meltoner/agrofelis/introduction/_figures/unselected/01_agrofelis-robot-schematics.png

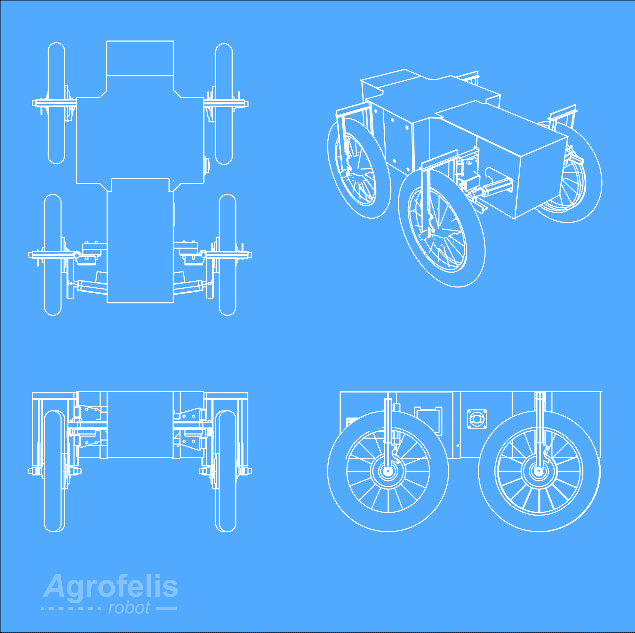
introduction/_figures/unselected/01_agrofelis-robot-schematics.png
