meltoner/agrofelis/introduction/_figures/unselected/02_.jpg

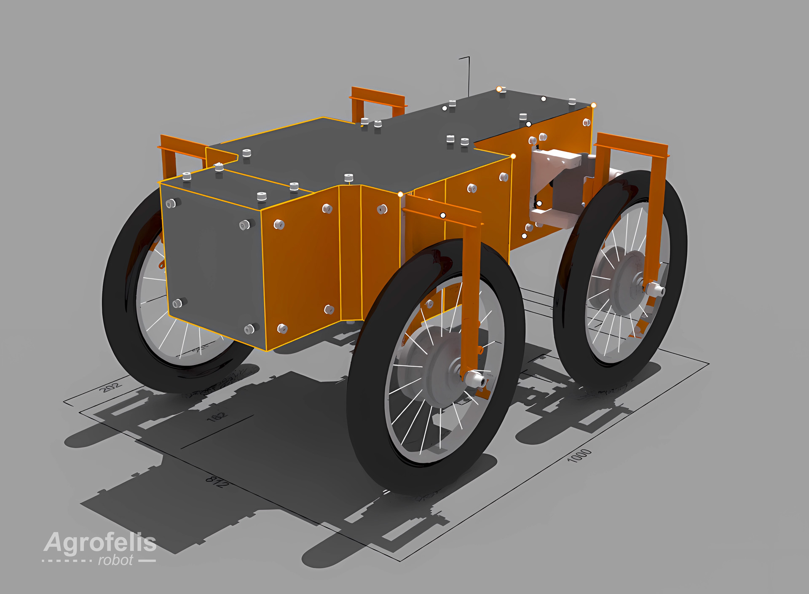
introduction/_figures/unselected/02_.jpg
