meltoner/agrofelis/introduction/_figures/unselected/02_agrofelis-robot-render.jpg

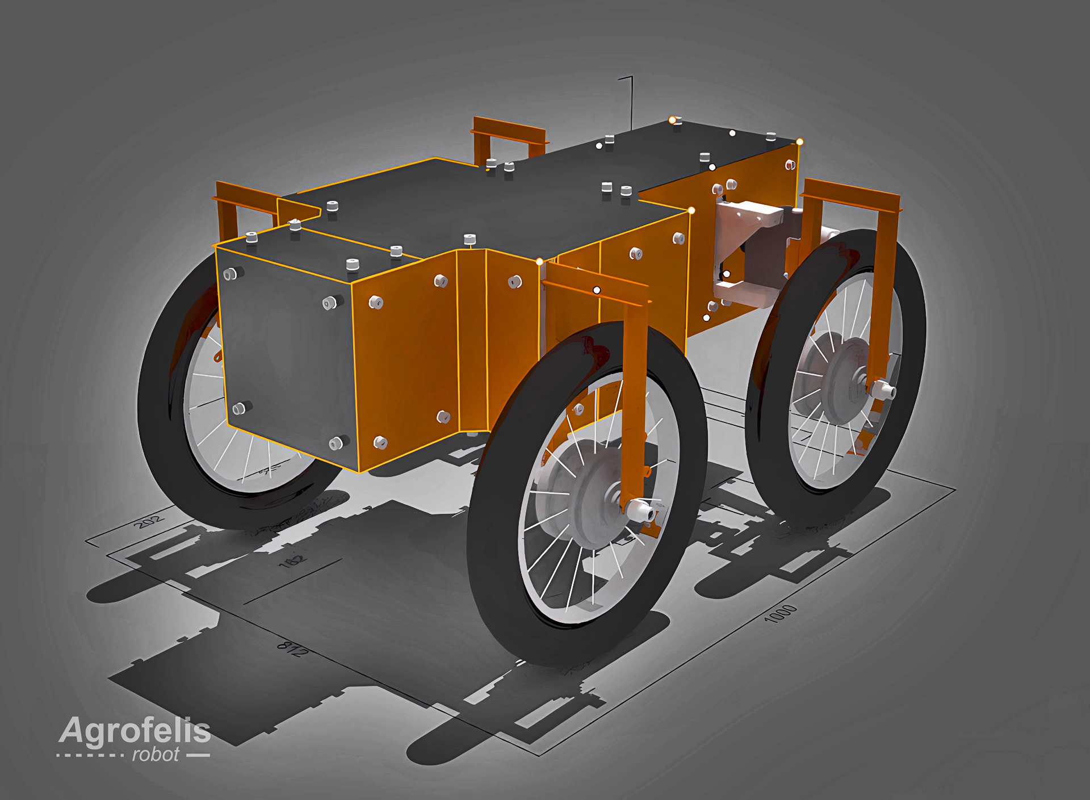
introduction/_figures/unselected/02_agrofelis-robot-render.jpg
