meltoner/agrofelis/introduction/_figures/unselected/03.png

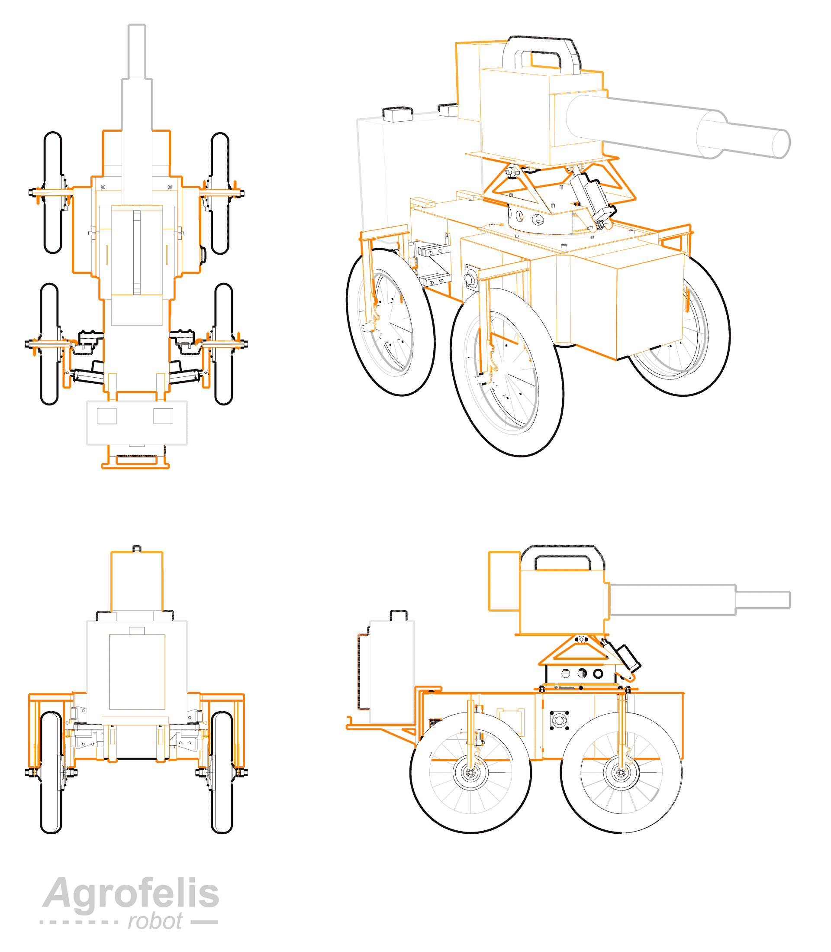
introduction/_figures/unselected/03.png
