meltoner/agrofelis/introduction/_figures/unselected/03_agrofelis-robot-implement-mount-schematic.png

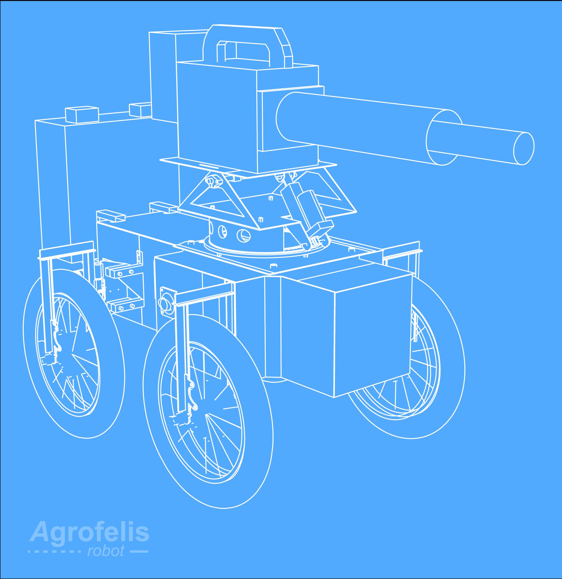
introduction/_figures/unselected/03_agrofelis-robot-implement-mount-schematic.png
