meltoner/agrofelis/introduction/_figures/unselected/+3dView_plansc.png

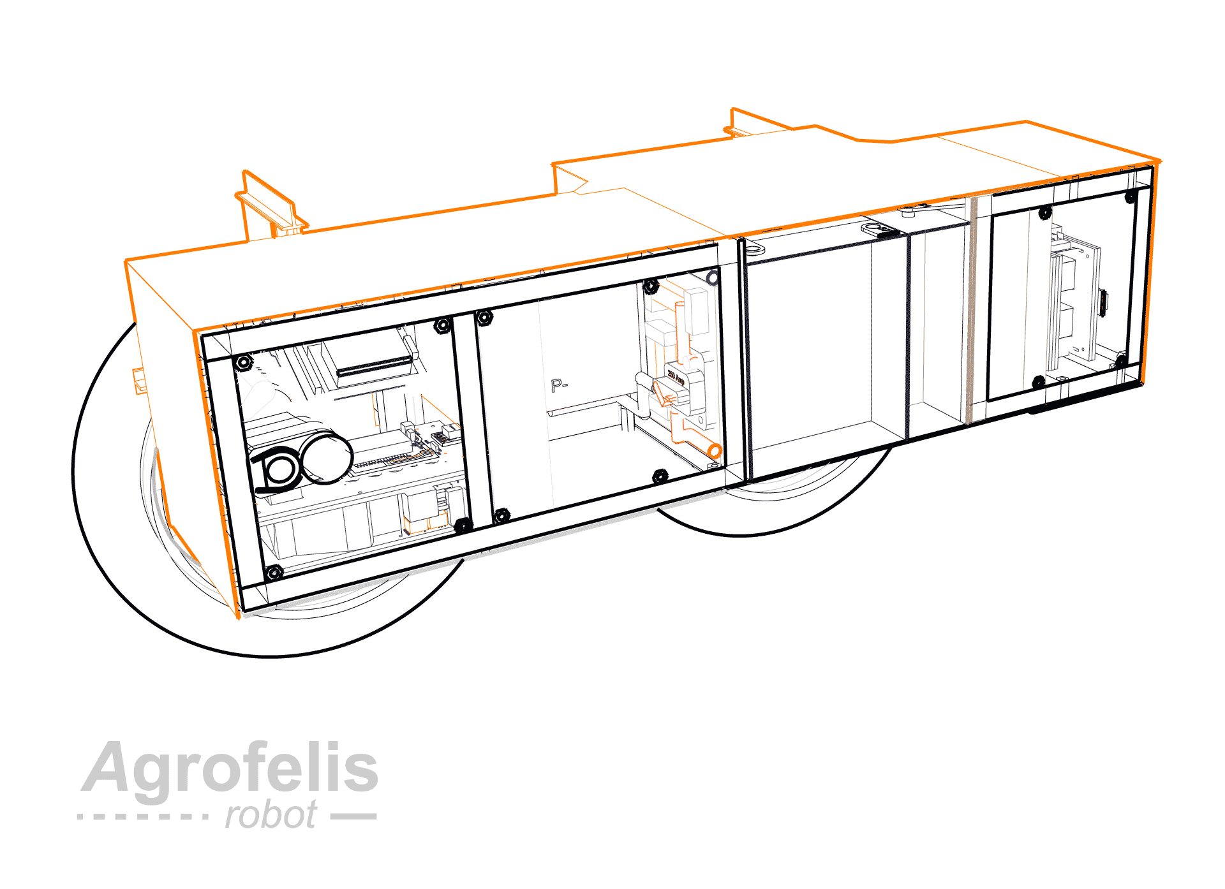
introduction/_figures/unselected/+3dView_plansc.png
