meltoner/agrofelis/components/mobility/motors_hub_driver/pcb/PCB.CNC.controller/readme.md

The folder contains SVG files that define the wholes and paths of the PCB. 
Moreover, the folder contains the actionable NC derivatives, generated by 
the respective JavaScript applications.

SVG 
- [1.DRILL.svg](https://github.com/meltoner/agrofelis/blob/main/components/mobility/motors_hub_driver/pcb/PCB.CNC.controller/1.DRILL.svg)
- [2.CURVE.svg](https://github.com/meltoner/agrofelis/blob/main/components/mobility/motors_hub_driver/pcb/PCB.CNC.controller/2.CURVE.svg)

NC
- [1.DRILL.ENHANCED.nc](https://github.com/meltoner/agrofelis/blob/main/components/mobility/motors_hub_driver/pcb/PCB.CNC.controller/1.DRILL.ENHANCED.nc)
- [2.CURVE.ENHANCED.nc](https://github.com/meltoner/agrofelis/blob/main/components/mobility/motors_hub_driver/pcb/PCB.CNC.controller/2.CURVE.ENHANCED.nc)

JavaScript
- [LineRoutesToHoles.html](https://github.com/meltoner/agrofelis/blob/main/components/mobility/motors_hub_driver/pcb/PCB.CNC.controller/LineRoutesToHoles.html)
- [LineRoutesToWire.html](https://github.com/meltoner/agrofelis/blob/main/components/mobility/motors_hub_driver/pcb/PCB.CNC.controller/LineRoutesToWire.html)

The transformation procedure follows :

A. FROM SVG EXPORT IN RHINO A4 1:1
OPEN IN ILLUSTRATOR AND SCALE X * 1.887640
MOVE OBJECT TO LEFT DOWN CORNER
SAVE

B. OPEN IN LASERGRBL AND SAVE AS CNC BOTH FILES

C. EDIT THE CNC CODE AND PROCESS IT VIA THE 

[LineRoutesToHoles.html](https://github.com/meltoner/agrofelis/blob/main/components/mobility/motors_hub_driver/pcb/PCB.CNC.controller/LineRoutesToHoles.html) THE DRILLING AND THE
[LineRoutesToWire.html](https://github.com/meltoner/agrofelis/blob/main/components/mobility/motors_hub_driver/pcb/PCB.CNC.controller/LineRoutesToWire.html) THE WIRING CNC CODE

USE A DRILL BIT IN THE FOR THE DRILLING
USE A PCB NOSE BIT FOR THE WIRING

[DRILL.svg](https://github.com/meltoner/agrofelis/blob/main/components/mobility/motors_hub_driver/pcb/PCB.CNC.controller/1.DRILL.svg) IS THE DRILLING PART
[CURVE.svg](https://github.com/meltoner/agrofelis/blob/main/components/mobility/motors_hub_driver/pcb/PCB.CNC.controller/2.CURVE.svg) IS THE WIRING PART

---------------------
189.26611224
