meltoner/agrofelis/components/mobility/motors_hub_driver/pcb/PCB.CNC.power/readme.md

The folder contains SVG files that define the wholes and paths of the PCB. 
Moreover, the folder contains the actionable NC derivatives, generated by 
the respective JavaScript applications.

SVG 
- [1.DRILL.svg](https://github.com/meltoner/agrofelis/blob/main/components/mobility/motors_hub_driver/pcb/PCB.CNC.power/1.drill.svg)
- [2.CURVE.svg](https://github.com/meltoner/agrofelis/blob/main/components/mobility/motors_hub_driver/pcb/PCB.CNC.power/2.curve.svg)

NC
- [1.drill.normalised.nc](https://github.com/meltoner/agrofelis/blob/main/components/mobility/motors_hub_driver/pcb/PCB.CNC.power/1.drill.normalised.nc)
- [1.drill.normalised.enhanced.nc](https://github.com/meltoner/agrofelis/blob/main/components/mobility/motors_hub_driver/pcb/PCB.CNC.power/1.drill.normalised.enhanced.nc)
- [2.curve.normalised.nc](https://github.com/meltoner/agrofelis/blob/main/components/mobility/motors_hub_driver/pcb/PCB.CNC.power/2.curve.normalised.nc)
- [2.curve.normalised.enhanced.nc](https://github.com/meltoner/agrofelis/blob/main/components/mobility/motors_hub_driver/pcb/PCB.CNC.power/2.curve.normalised.enhanced.nc)

JavaScript
- [LineRoutesToHoles.html](https://github.com/meltoner/agrofelis/blob/main/components/mobility/motors_hub_driver/pcb/PCB.CNC.power/LineRoutesToHoles.html)
- [LineRoutesToWire.html](https://github.com/meltoner/agrofelis/blob/main/components/mobility/motors_hub_driver/pcb/PCB.CNC.power/LineRoutesToWire.html)

A. FROM SVG EXPORT IN RHINO A4 1:1
OPEN IN ILLUSTRATOR AND SCALE X * 1.887640
MOVE OBJECT TO LEFT DOWN CORNER
SAVE

B. OPEN IN LASERGRBL AND SAVE AS CNC BOTH FILES

C. EDIT THE CNC CODE AND PROCESS IT VIA THE 

[LineRoutesToHoles.html](https://github.com/meltoner/agrofelis/blob/main/components/mobility/motors_hub_driver/pcb/PCB.CNC.power/LineRoutesToHoles.html) THE DRILLING AND THE
[LineRoutesToWire.html](https://github.com/meltoner/agrofelis/blob/main/components/mobility/motors_hub_driver/pcb/PCB.CNC.power/LineRoutesToWire.html) THE WIRING CNC CODE

USE A DRILL BIT IN THE FOR THE DRILLING
USE A PCB NOSE BIT FOR THE WIRING

[DRILL.svg](https://github.com/meltoner/agrofelis/blob/main/components/mobility/motors_hub_driver/pcb/PCB.CNC.power/1.drill.svg) IS THE DRILLING PART
[CURVE.svg](https://github.com/meltoner/agrofelis/blob/main/components/mobility/motors_hub_driver/pcb/PCB.CNC.power/2.curve.svg) IS THE WIRING PART

---------------------
