meltoner/agrofelis/components/mobility/motors_hub_driver/pcb/PCB.CNC.adac/readme.md

A. FROM SVG EXPORT IN RHINO A4 1:1
OPEN IN ILLUSTRATOR AND SCALE X * 1.887640
MOVE OBJECT TO LEFT DOWN CORNER
SAVE

B. OPEN IN LASERGRBL AND SAVE AS CNC BOTH FILES

C. EDIT THE CNC CODE AND PROCESS IT VIA THE 

LineRoutesToHoles.html THE DRILLING AND THE
LineRoutesToWire.html THE WIRING CNC CODE

USE A DRILL BIT IN THE FOR THE DRILLING
USE A PCB NOSE BIT FOR THE WIRING

DRIL.svg IS THE DRILLING PART
CURVE.svg IS THE WIRING PART

---------------------
152.2306
