meltoner/agrofelis/components/vehicle-steering/driver-board/laser-cut-nc/notes.txt

180 ms
60%
two passes

WARNING DRIVER +5V SHOULD NOT BE CONNECTED
AS IT LINKS TO THE HIGH VOLTAGE.
