meltoner/agrofelis/components/vehicle-steering/driver-board/STEERING_DRIVER_CABLES_LABELS.pdf

MB P
-5V
+5V
MB
MB
MB C

MA P

MOTOR A
potentiometer

-5V
+5V
MA
MA
MA C

# STEERING DRIVER CABLE LABELS

# DUAL DC MOTOR DRIVER WITH CURRENT SERNSOR AND FEEDBACK

# MOTOR B

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
MOTOR A

30 V | 30 V | 30 V | 30 V

J.NANO 5V

J.NANO USB | WIFI | USB | MEGA USB

MEGA USB

BMS USB

USB HUB 5V | 5 V

MOTOR B

MOTOR B
potentiometer

# MOTOR A
