meltoner/agrofelis/components/mobility/motors_hub_driver/src/web-app/snapshot.png

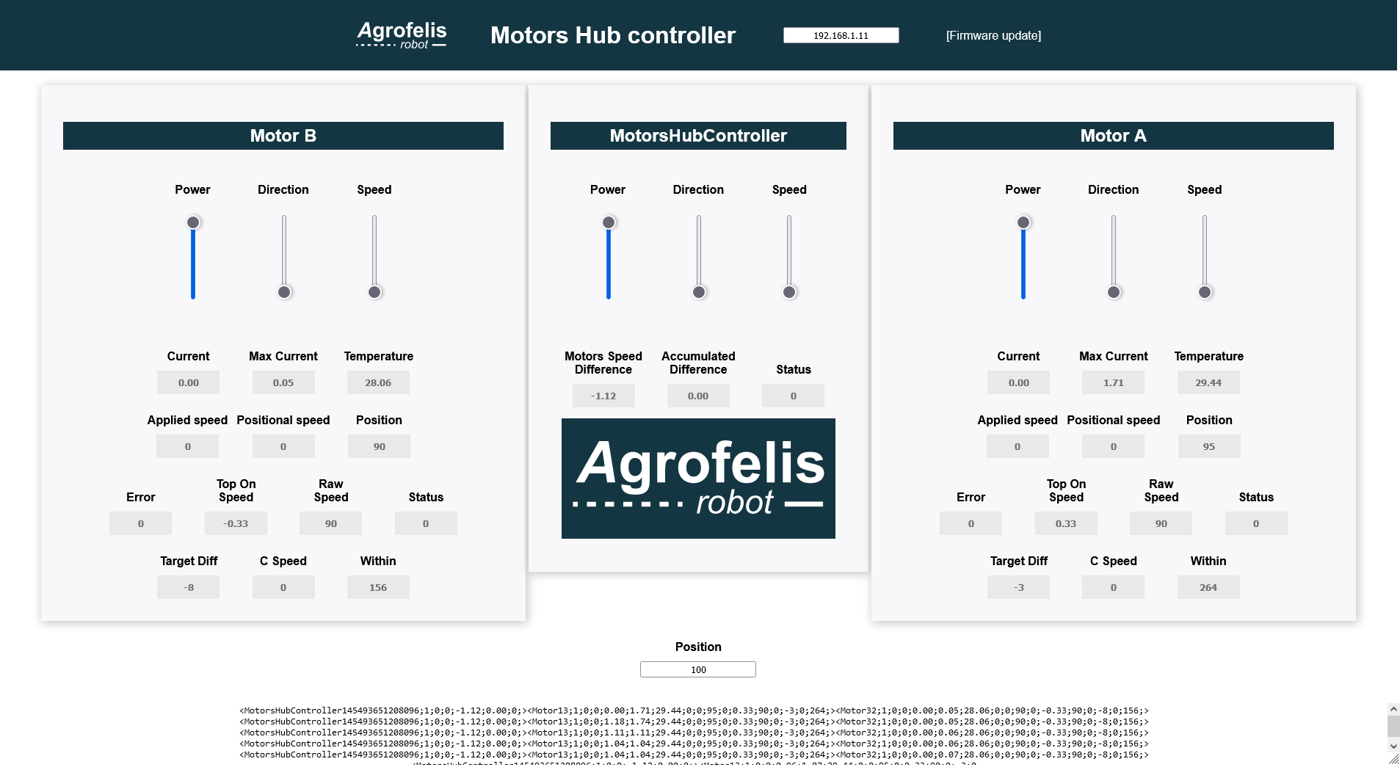
components/mobility/motors_hub_driver/src/web-app/snapshot.png
