meltoner/agrofelis/components/vehicle-steering/driver-board/model/LINEAR MODULE_embedded_files/drivercurrent.png

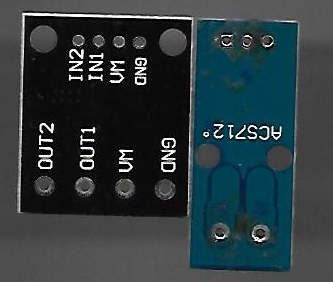
components/vehicle-steering/driver-board/model/LINEAR MODULE_embedded_files/drivercurrent.png
