meltoner/agrofelis/components/connectivity/assets/3d-print/JetsonElectronicsBase/export_electronics_base.stl

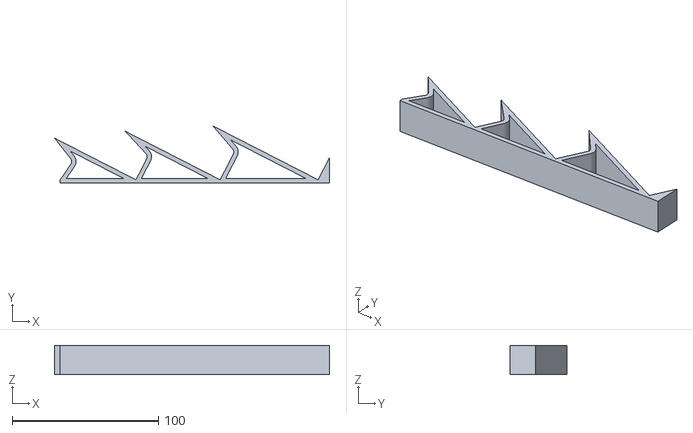
[picture p175: CAD file, 2023-09-10]
components/connectivity/assets/3d-print/JetsonElectronicsBase/export_electronics_base.stl
188.2 x 39.2 x 20.0
