meltoner/agrofelis/components/connectivity/assets/3d-print/usbHolder/usb_holder.stl

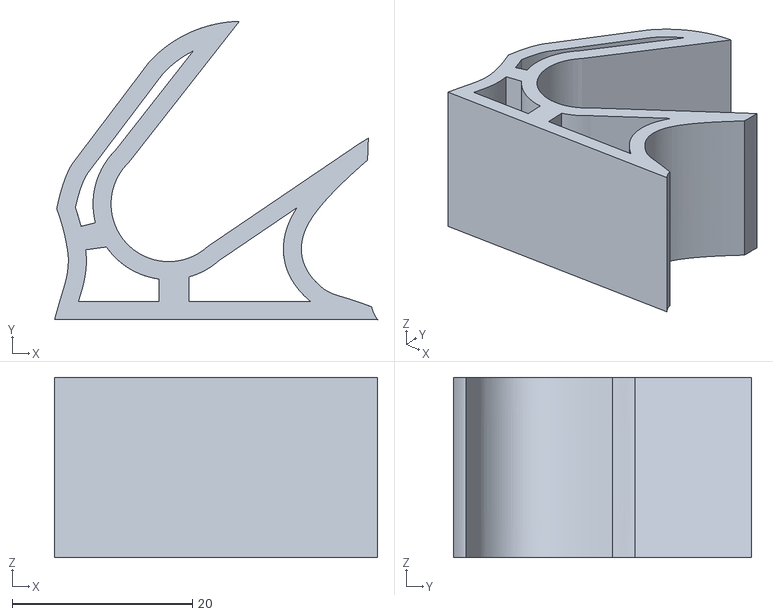
[picture p176: CAD file, 2023-09-10]
components/connectivity/assets/3d-print/usbHolder/usb_holder.stl
35.8 x 33.1 x 20.0
