meltoner/agrofelis/components/mobility/motors_hub_driver/structural/box_fins/3d_print/motorsDriverFinsInner.stl

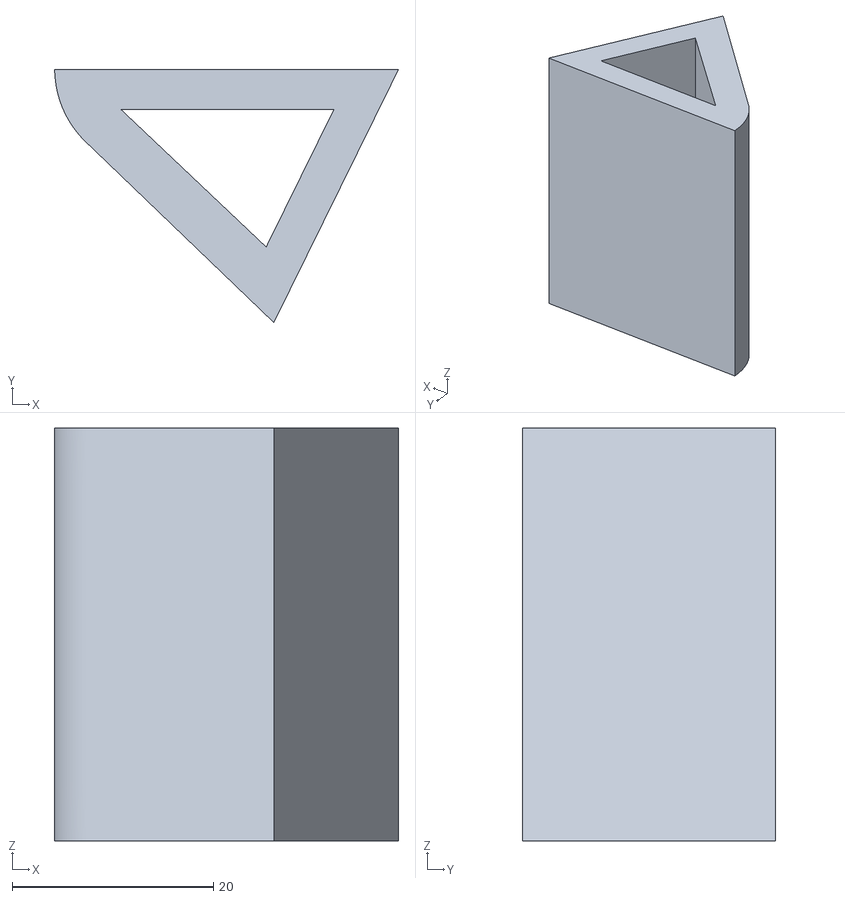
[picture p177: CAD file, 2023-07-12]
components/mobility/motors_hub_driver/structural/box_fins/3d_print/motorsDriverFinsInner.stl
34.2 x 25.1 x 41.0
