meltoner/agrofelis/components/vehicle-steering/assets/3d-print-feedback-potensiometer-covers/potensiometerCoversL.stl

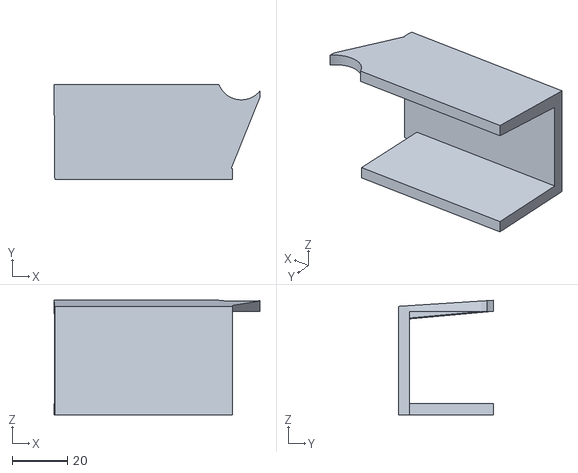
[picture p178: CAD file, 2023-08-30]
components/vehicle-steering/assets/3d-print-feedback-potensiometer-covers/potensiometerCoversL.stl
74.3 x 34.2 x 41.3
