meltoner/agrofelis/components/mobility/motors_hub_driver/structural/box_fins/3d_print/motorsDriverFinsOuter.stl

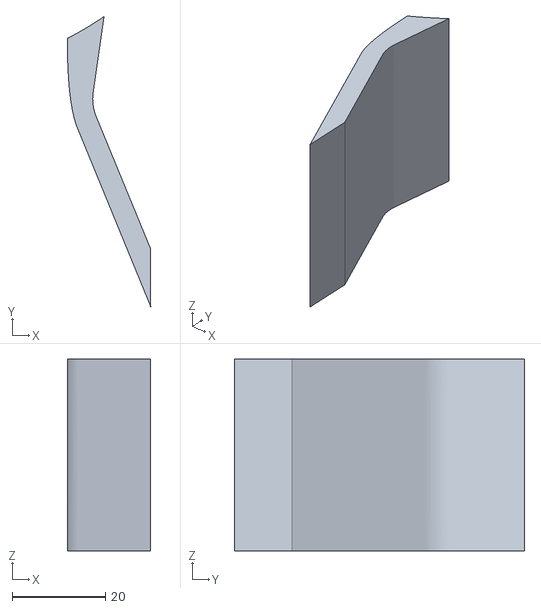
[picture p179: CAD file, 2023-07-12]
components/mobility/motors_hub_driver/structural/box_fins/3d_print/motorsDriverFinsOuter.stl
17.8 x 62.0 x 41.0
