meltoner/agrofelis/(list of files, cad)

Other CAD files:
components/implement-2-degrees-rotating-mount/assets/stainless-steel-laser-cut/laser-cut_stainless_gear_disk_motor_gear_order.dwg
components/vehicle-steering/assets/3d-print-feedback-potensiometer-covers/potensiometerCoversR.stl
components/vehicle-steering/driver-board/model/LINEAR MODULE_4.3dm
components/vehicle-wheels/assets/36holes-16-inch-pattern.3dm
