meltoner/agrofelis/components/mobility/motors_hub_driver/pcb/PCB.PRINT.Stickers/readme.md

The folder includes the printed top cover of the PCB boards, namely the:

- [motors_hub_driver-sticker-pcb-power_driver.pdf](https://github.com/meltoner/agrofelis/blob/main/components/mobility/motors_hub_driver/pcb/PCB.PRINT.Stickers/motors_hub_driver-sticker-pcb-power_driver.pdf)
- [motors_hub_driver-sticker-pcb-controller.pdf](https://github.com/meltoner/agrofelis/blob/main/components/mobility/motors_hub_driver/pcb/PCB.PRINT.Stickers/motors_hub_driver-sticker-pcb-controller.pdf)
- [motors_hub_driver-sticker-pcb-adac.pdf](https://github.com/meltoner/agrofelis/blob/main/components/mobility/motors_hub_driver/pcb/PCB.PRINT.Stickers/motors_hub_driver-sticker-pcb-adac.pdf)
