meltoner/agrofelis/book/03agrofelisrobotwheelsforksdesignandfabrication.pdf

# Agrofelis Robot Wheels Forks Design and Fabrication

### Documentation

### Agrofelis

### Document created on 2023-10-09 03:57:09

Abstract

This document presents an overview of the fabrication process for the forks mounting the four wheels of the Agrofelis vehicle. These forks are intentionally designed to be detachable, so that the wheels could be removed or replaced with alternative ones. The forks are responsible for securing the active wheels of the vehicle, establishing active brakes actuated via servos, enabling steering and installing feedback rotating mechanisms. Two types of forks are being employed, those installed in the front and those installed in the back. The majority of fork designs are similar, with the only differentiating factor being the mounting mechanism aimed for fixed or steering purposes. The forks installed on the left and right sides are arranged in a mirrored fashion. The forks are constructed from regular iron T-shaped rods that have been cut and welded. Additional sub-components elaborated are the vehicle’s fork mounting mechanisms and the parrot-like (drop out) elements securing the wheels via the motor’s hub shaft. The design schematics, plasma cut patterns, as well as images of the fabrication progression are all documented. The document concludes by providing a list of indicative suppliers from whom the raw materials were acquired, further enriched with bill and material details.

## Contents

Introduction | 1
Forks Arrangement | 1
Front Forks | 3
Back Forks | 7
Forks Components and Indicative Suppliers | 15
Summary | 16

Agrofelis
Agrofelis Robot Wheels Forks Design and Fabrication

## Introduction

In order to minimize the footprint of the vehicle, to have a sturdier front structure where mechanisms could be mounted, to reduce the fabrication complexity and to cut manufacturing costs, the front wheels were designed with a fixed function in mind, while the back wheels were designed with a dynamic function implementing the steering of the vehicle. The forks utilized existing profile characteristics found in the bicycle industry and more specifically for the fork drop out and brake mounting points, so disk brakes could be employed. Fabrication of the forks and their mounting mechanisms involves regular 25 mm T-shaped rods, along with two plasma-cut components that are cut, drilled and MIG welded. All forks were designed so they are detachable in order to support future revisions or variations of the forks.

In the following sections, the Agrofelis forks are being decomposed into their sub-elements, showcasing their fabrication details.

## Forks Arrangement

The following schematic illustrates the four wheel forks of the vehicle.

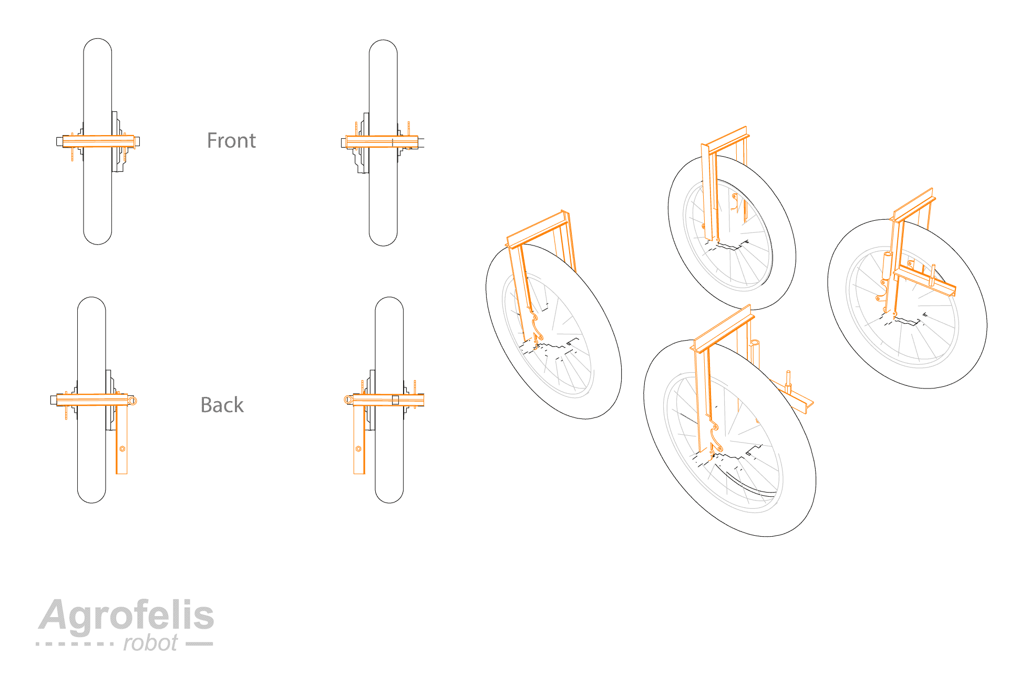
[picture p206: figure]

Figure 1: Forks and wheels

The following figure depicts the forks mirrored arrangement.

Forks Arrangement | Page | 1 of 17

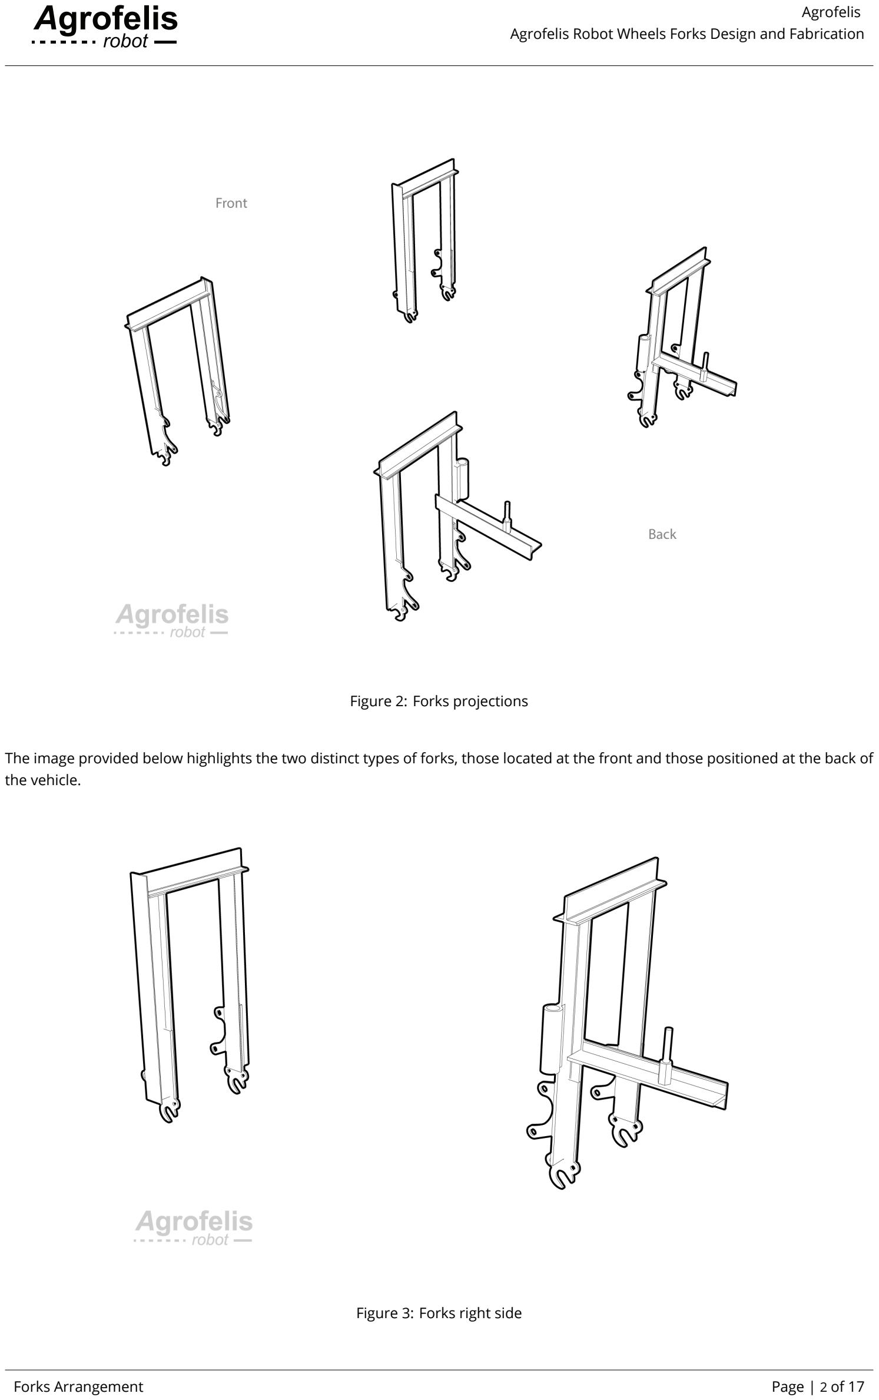
[picture p207: page 3]

Figure 2: Forks projections

The image provided below highlights the two distinct types of forks, those located at the front and those positioned at the back of the vehicle.

Figure 3: Forks right side

Forks Arrangement | Page | 2 of 17

## Front Forks

All fours forks share a common structure, differentiating only at the final fabrication stage based on their intended usage. The diagram below encodes the profile characteristics and dimensions of a front fork.

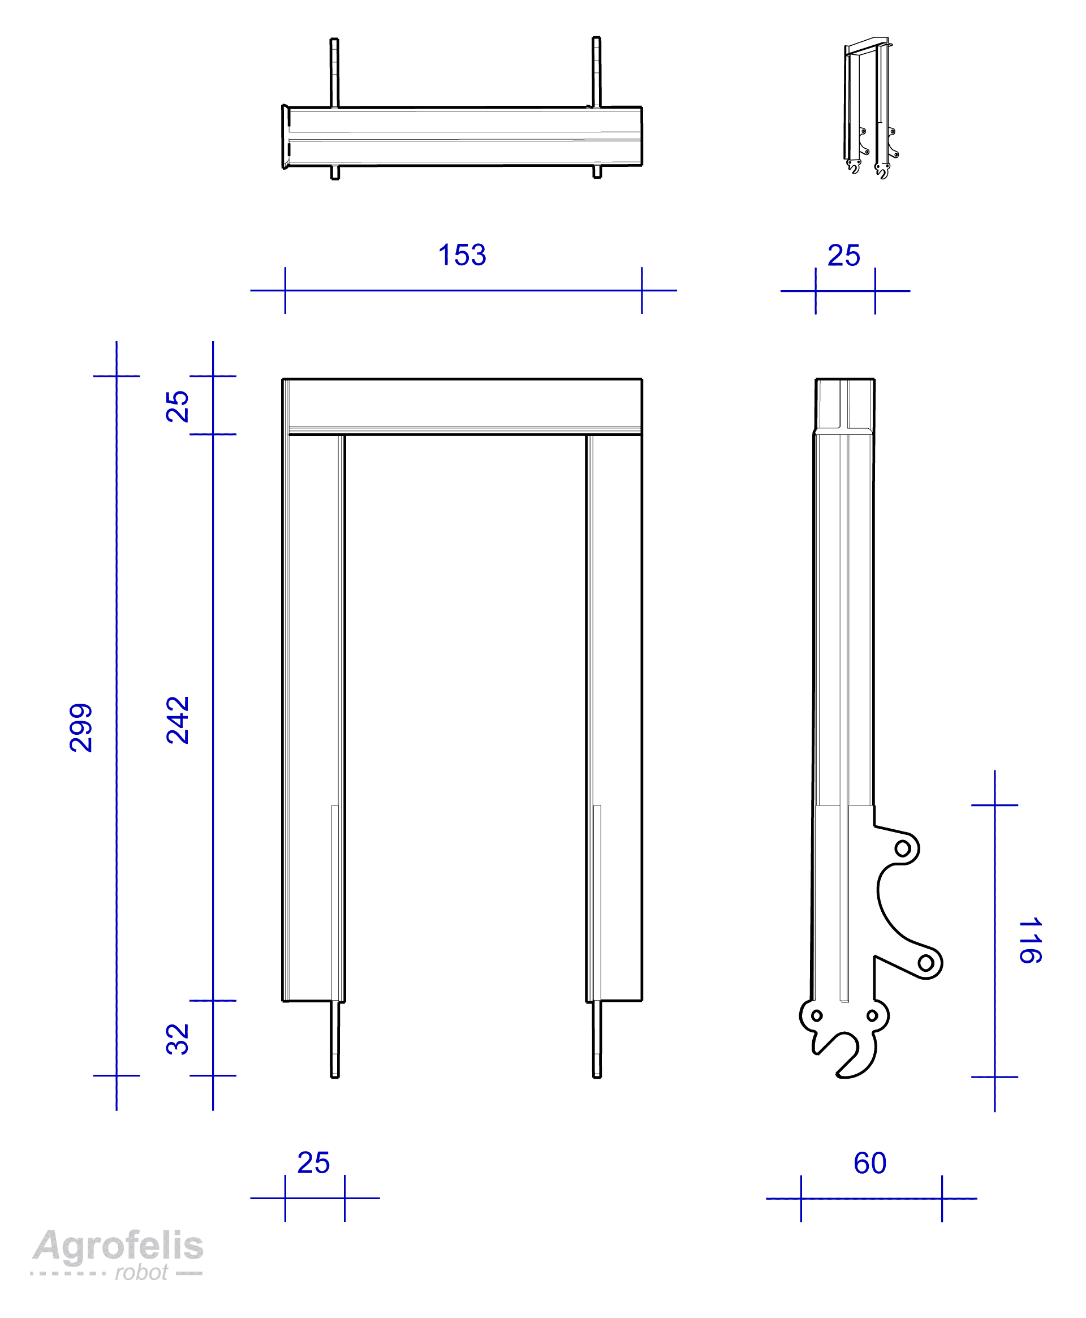
[picture p208: figure]

Figure 4: Front fork dimensions

The front fork mounting mechanism is also fabricated using a T-shaped rod, with its top part trimmed to create a socket for the fork’s placement. The mounting mechanism is welded onto the vehicle’s frame. Both the mounting mechanism and the fork are drilled and connected together using regular nuts and bolts. The mounting mechanism (A) of the front fork (B) is illustrated by the following figure.

Front Forks | Page | 3 of 17

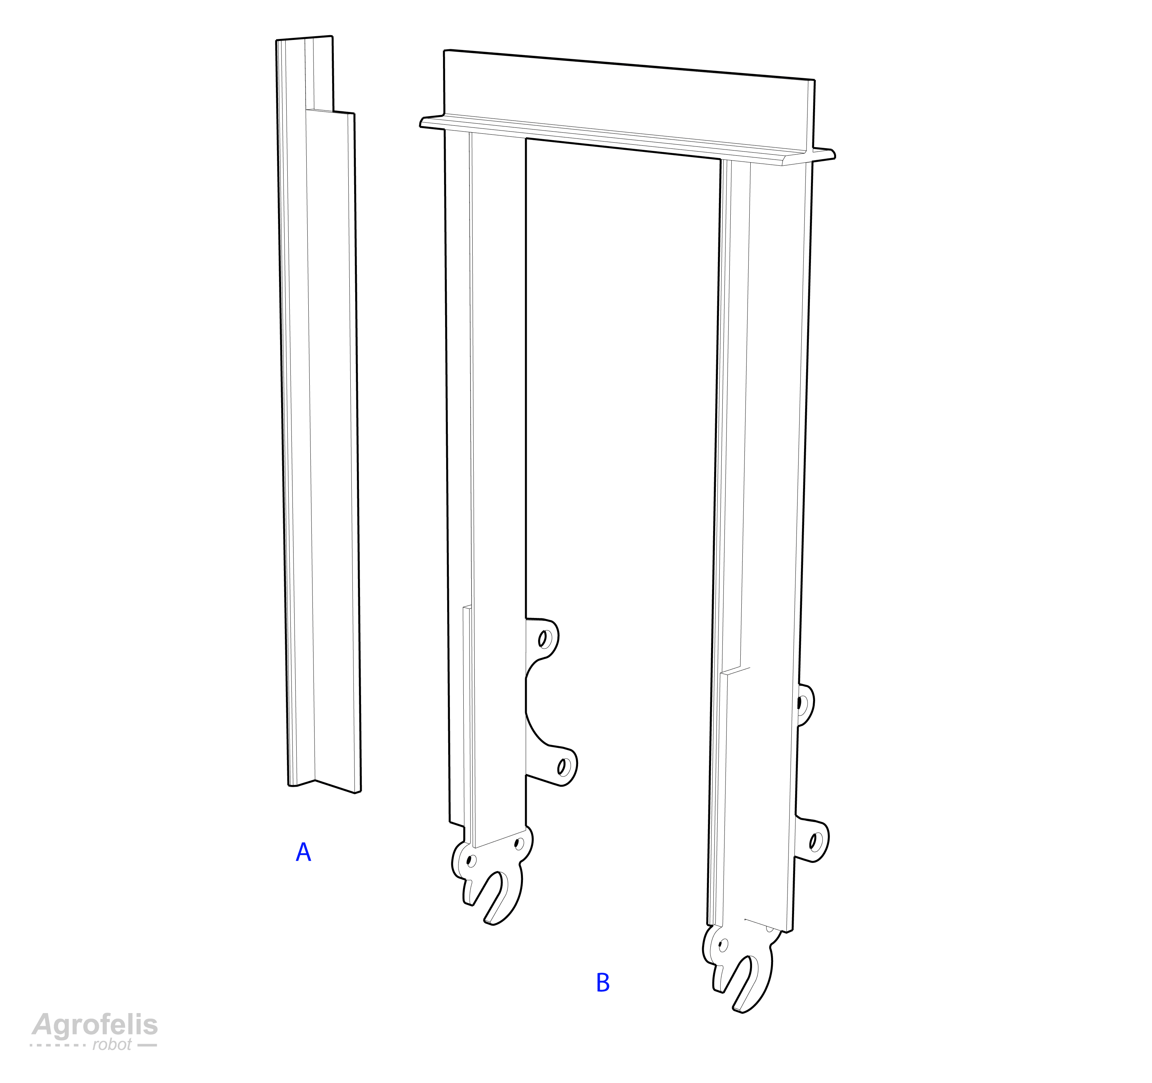
[picture p209: figure]

Figure 5: Front fork and mount

The front fork sub-parts are indexed by the following exploded view diagram.

Front Forks | Page | 4 of 17

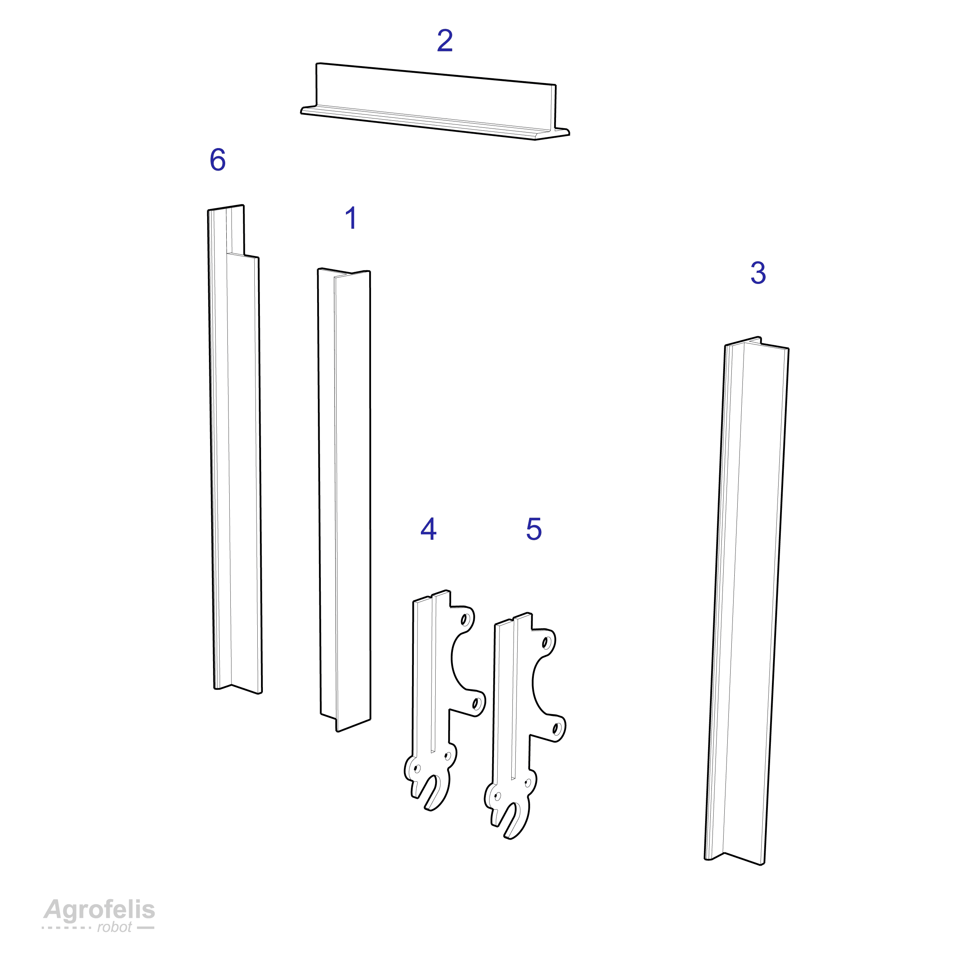
[picture p210: figure]

Figure 6: Front fork exploded view

The following part designed and fabricated, has a vertical socket allowing to slide within the T-shaped rod as seen by the following schematic.

Front Forks | Page | 5 of 17

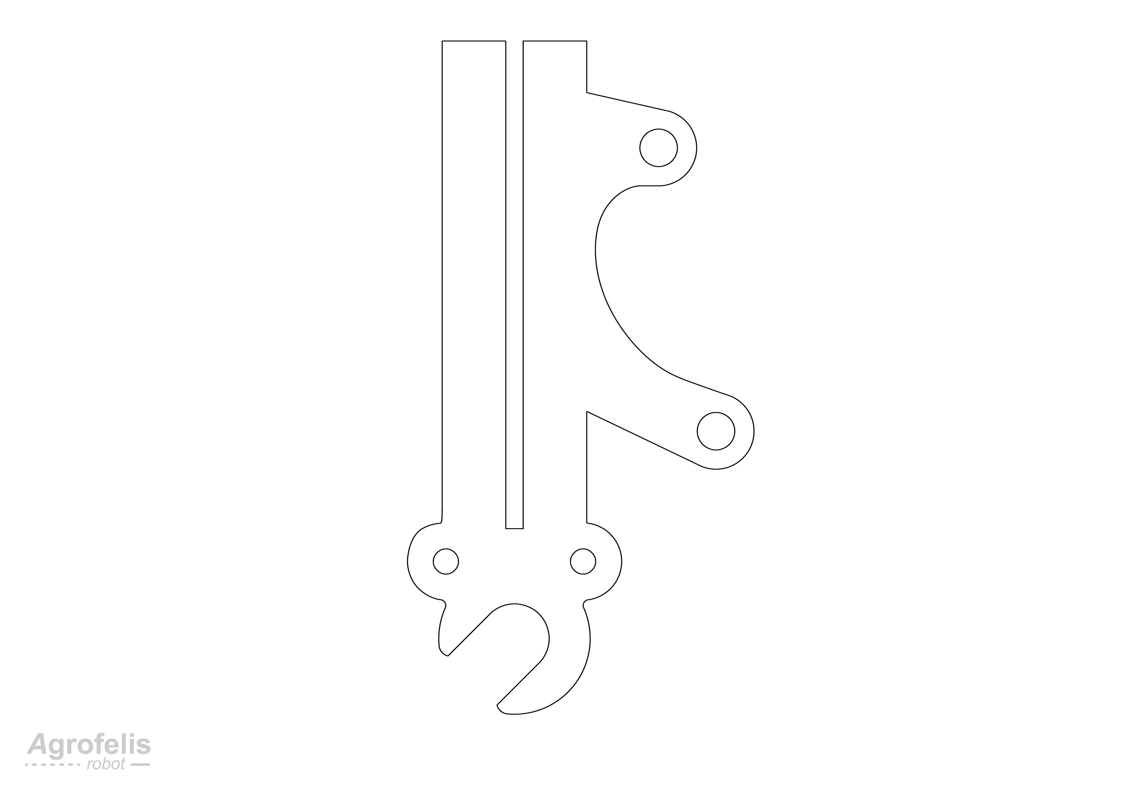
[picture p211: figure]

Figure 7: Fork drop out component plasma cut

Two of these elements are fabricated per fork and are welded in each of its bottom sides. The component accommodates for mounting the wheels, as well as for mounting the disk brakes mechanism. The NC files used to fabricate them are provided in the following directory in the open source repository.

- assets/forks_dropout (https://github.com/meltoner/agrofelis/tree/main/components/vehicle-forks/assets/forks_dropout)

The following directory contains the scalable vector graphics design plan of the component, offset by 1 mm, accounting for the plasma torch diameter.

- forks_dropout_1mm_offset.svg (https://github.com/meltoner/agrofelis/tree/main/components/vehicle-forks/assets/forks_dropout/forks_dropout_1mm_offset.svg)

In addition, the NC (Numerical Control) instructions file sent to the CNC is available in the following file.

- forks_dropout_1mm_offset.nc (https://github.com/meltoner/agrofelis/tree/main/components/vehicle-forks/assets/forks_dropout/forks_dropout_1mm_offset.nc)

The SVG to NC conversion was accomplished by the Laser GRBL free laser engraving software and its outcome was transformed for a plasma cutter (z-axis actuation) using the open-source software developed for driving a custom DIY plasma cutter tailored for this specific purpose.

- https://github.com/meltoner/g-code-plasma-cutting

The fabricated plasma cut drop out component can be seen by the following image.

Front Forks | Page | 6 of 17

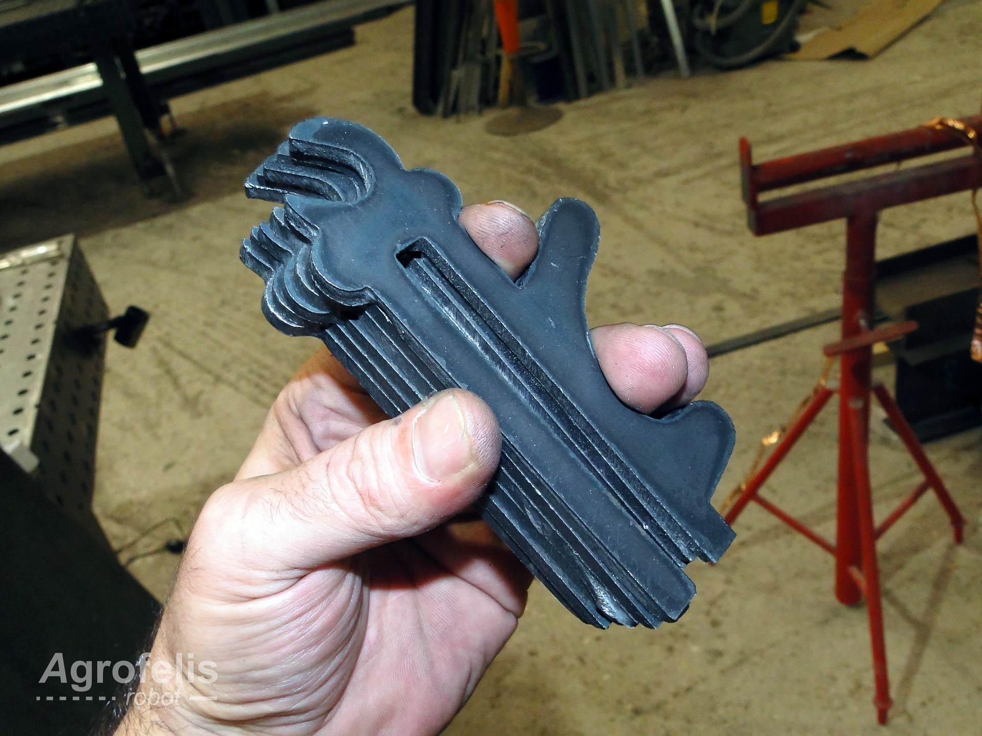
[picture p212: figure]

Figure 8: Fabricated drop out element

## Back Forks

The back forks of the Agrofelis vehicle closely resemble to the front forks. They differentiate by welding the half part of a hinge on their side, as well as welding a lever where a liner actuator can push rotate the wheels at the desired degree. The back fork schematic and dimensions are encoded by the following diagram.

Back Forks | Page | 7 of 17

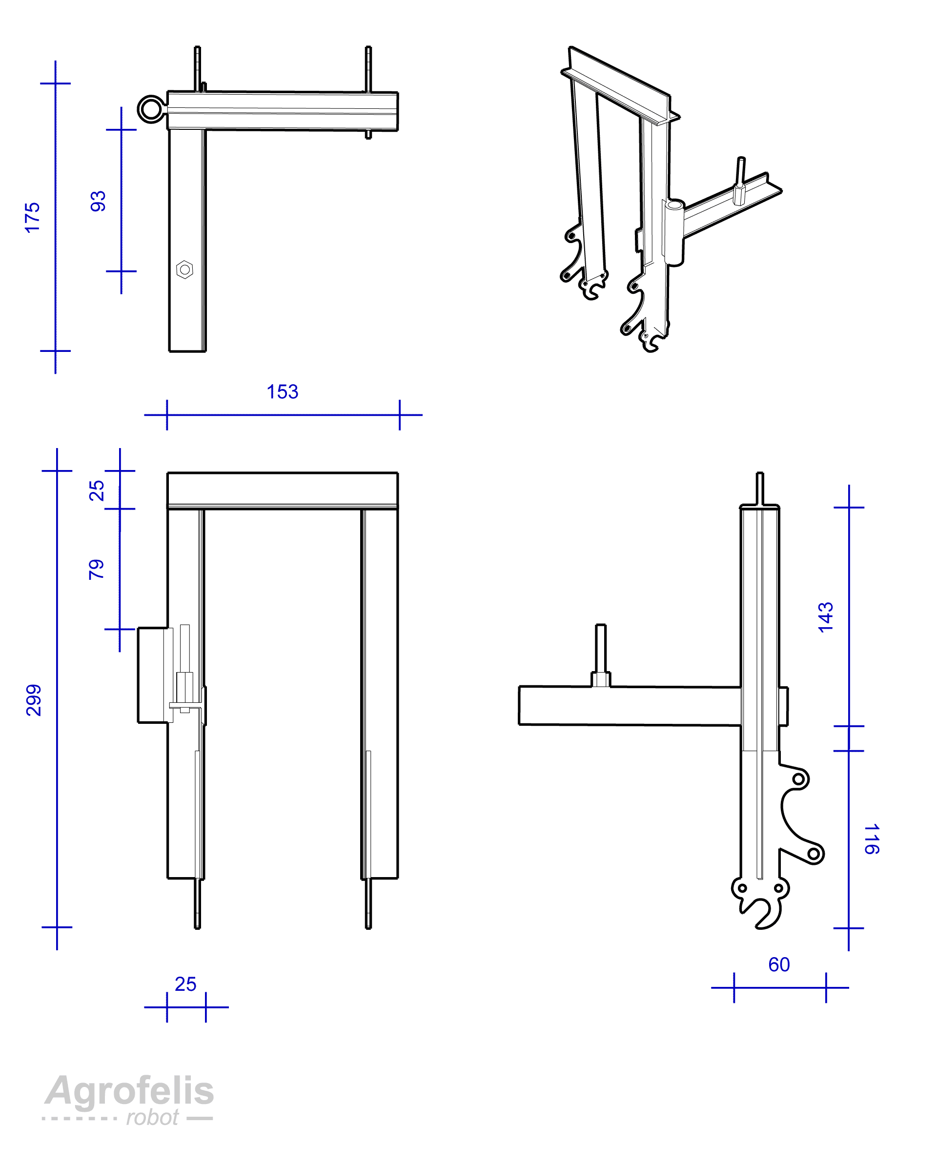
[picture p213: figure]

Figure 9: Back fork dimensions

The back fork sub-parts are indexed by the following exploded view diagram.

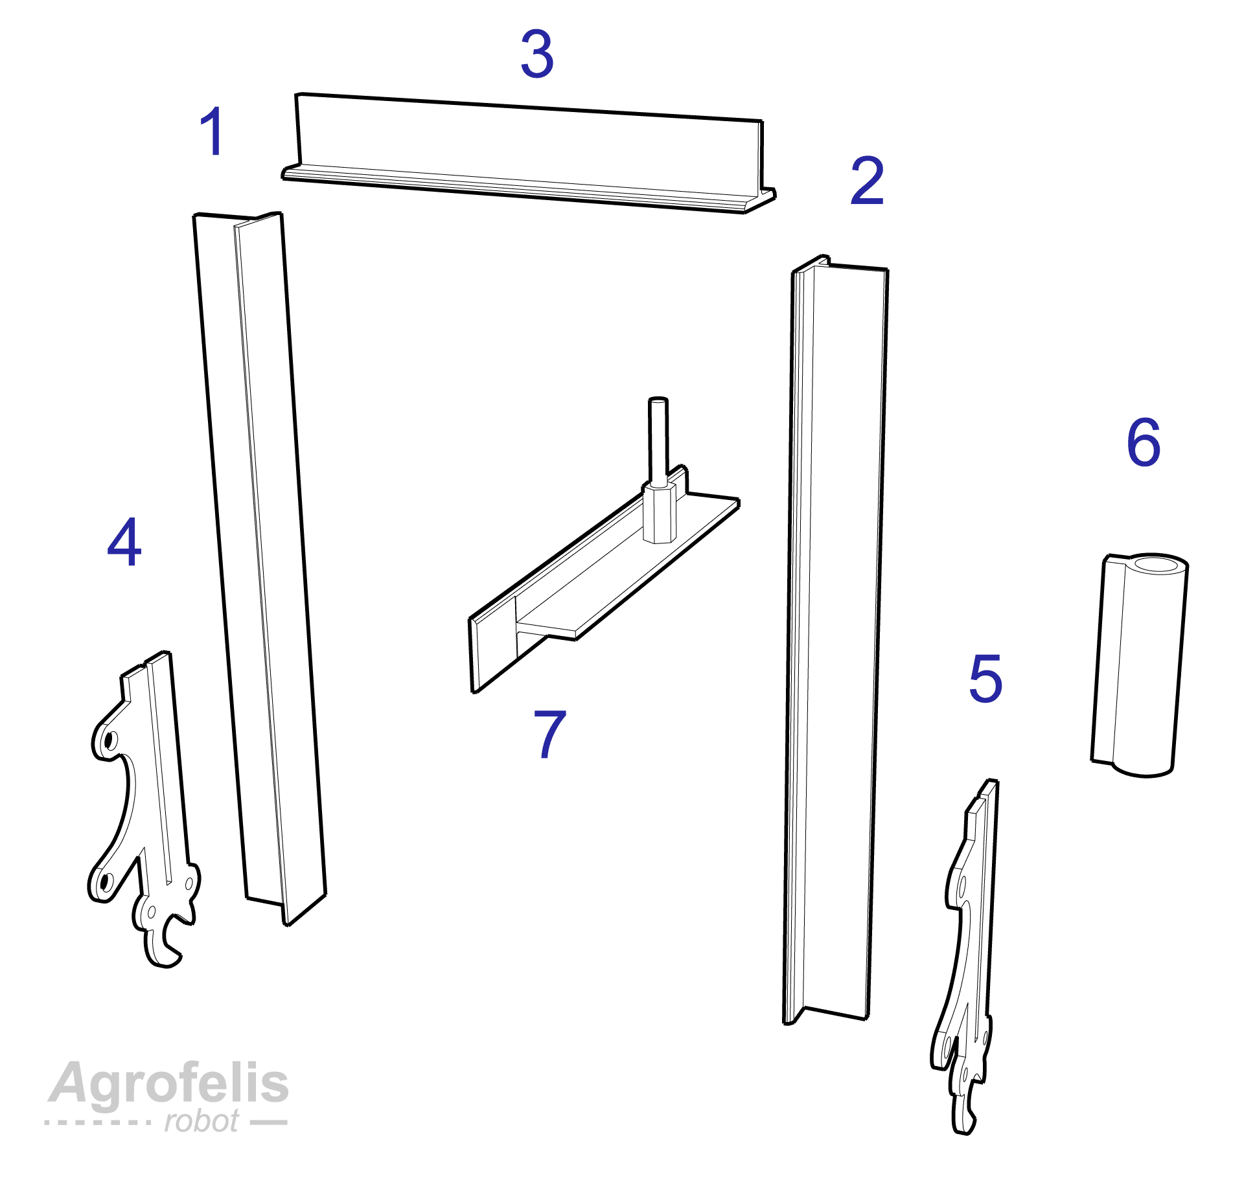
[picture p214: figure]

Figure 10: Back fork exploded view

A more detailed schematic of the related level element is encoded by the consequent image.

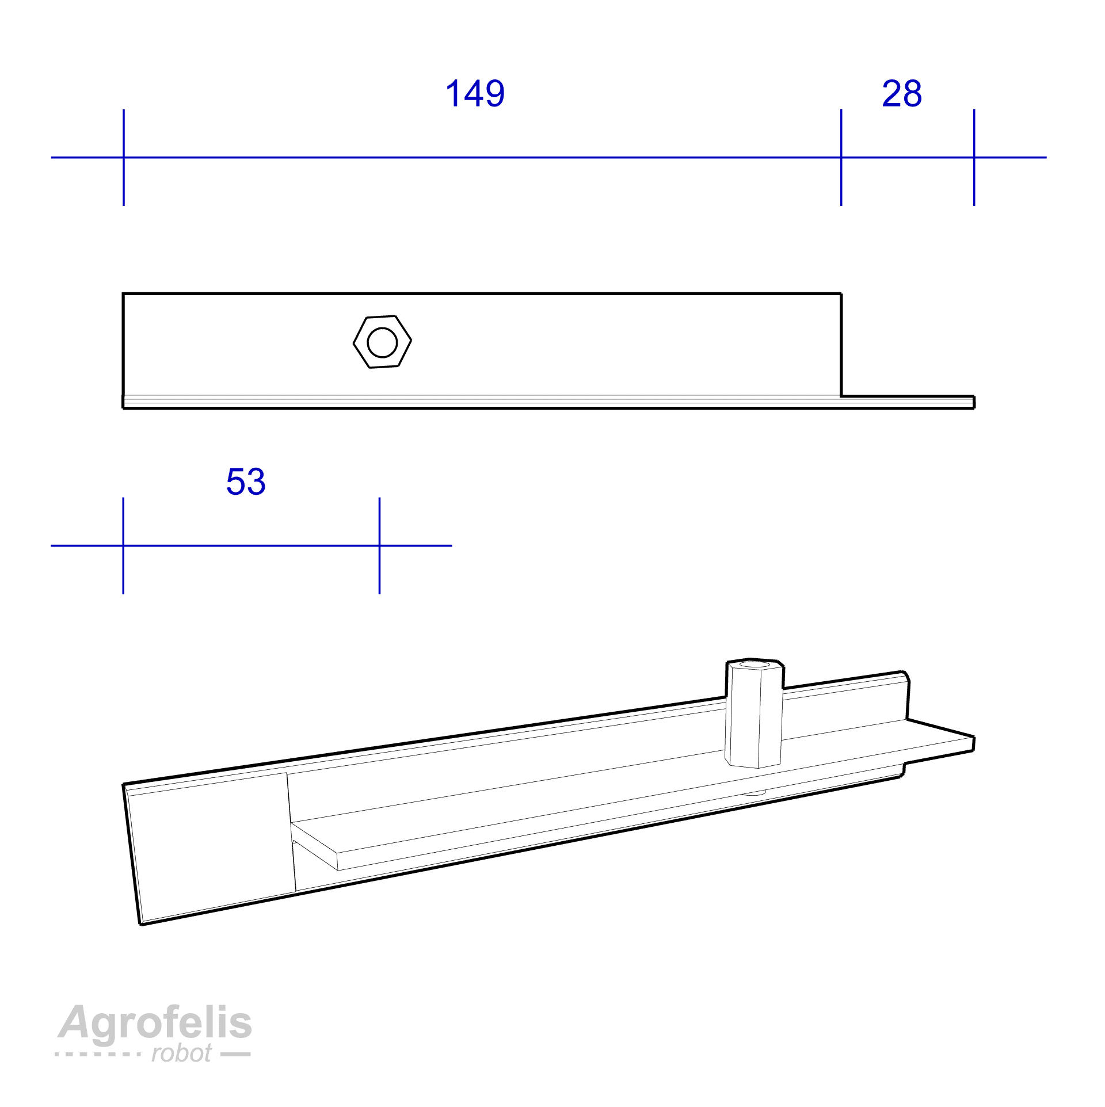
[picture p215: figure]

Figure 11: Back fork lever

Within the lever at the depicted distance a hole is drilled and an extended nut is installed via a bolt to accommodate the end of a linear actuator, rotating the wheel. Further details about this detail are covered in the Agrofelis steering design and fabrication document.

Sub-components of the forks laid out, ready to be welded have been photographed by the next image.

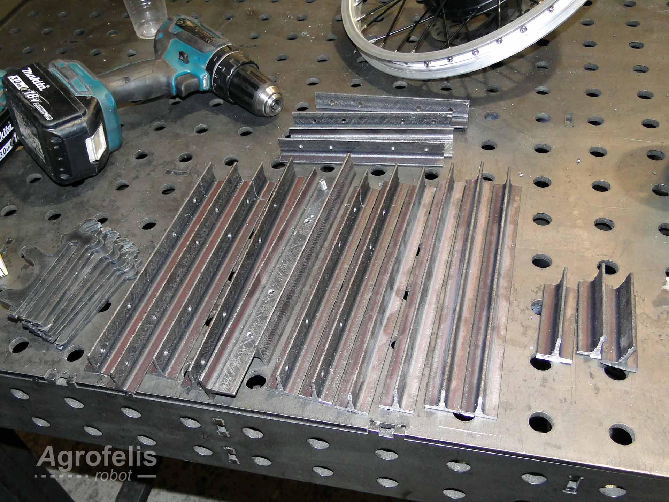
[picture p216: figure]

Figure 12: Multiple components of the forks

The back fork, is connected with the frame using a custom plasma cut part and a hinge. The half part of the hinge is welded into this component and the other half to the fork. The schematic of the custom cut part is presented by the following figure.

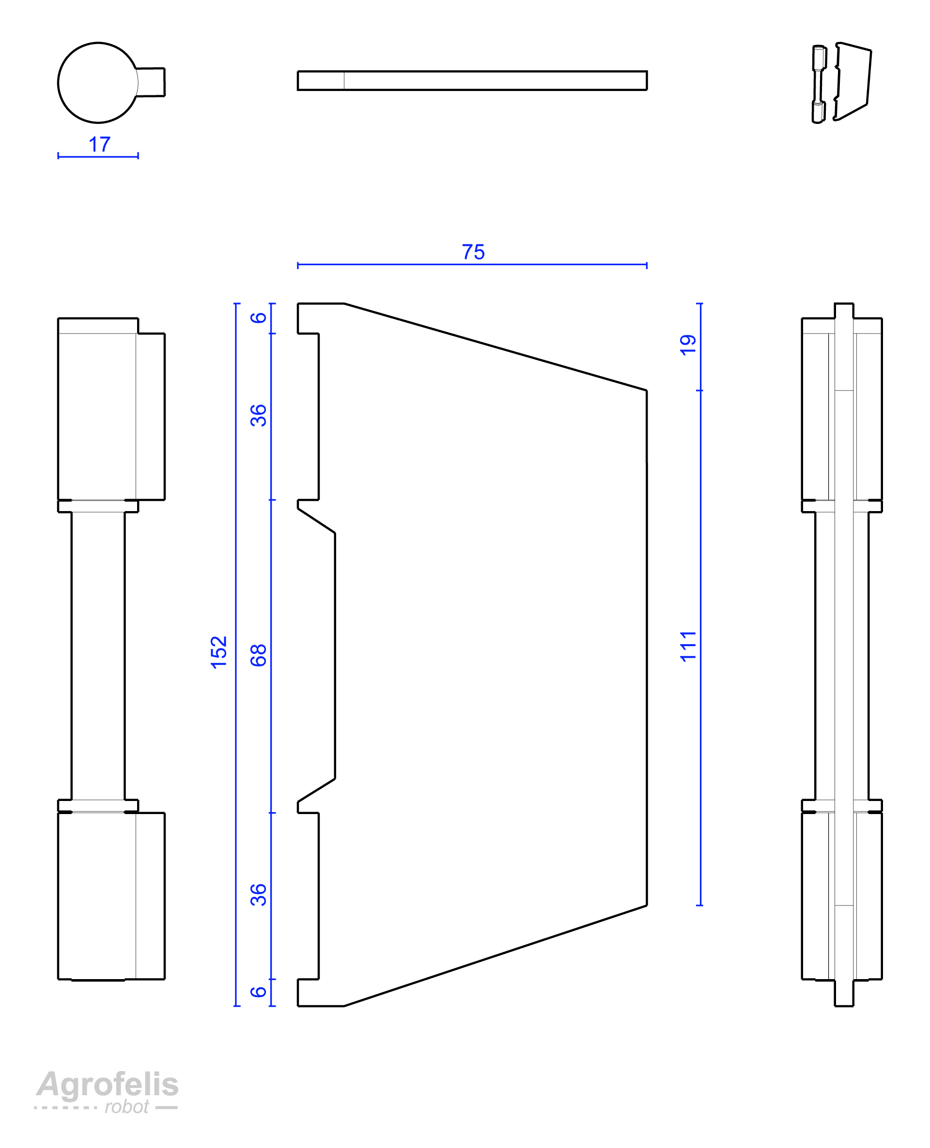
[picture p217: figure]

Figure 13: Back fork hinge-mount

Two of these elements are fabricated for the back forks and are drilled and connected to the frame using 12 mm bolt and nuts. The NC files used to fabricate them are provided in the following directory in the open source repository.

- assets/back_wheel_mount (https://github.com/meltoner/agrofelis/tree/main/components/vehicle-forks/assets/back_wheel_mount)

The directory contains the scalable vector graphics design plan of the component, offset-ed by 1 mm, accounting for the plasma torch diameter.

- back_wheel_mount.svg (https://github.com/meltoner/agrofelis/tree/main/components/vehicle-forks/assets/back_wheel_mount/back_wheel_mount.svg)

In addition, the NC (Numerical Control) instructions file sent to the CNC are provided by the following file.

- back_wheel_mount.nc (https://github.com/meltoner/agrofelis/tree/main/components/vehicle-forks/assets/back_wheel_mount/back_wheel_mount.nc)

The SVG to NC conversion process was carried out using the Laser GRBL free laser engraving software and its outcome was converted for a plasma cutter (with z-axis actuation) using open-source software specifically developed to steer a custom DIY plasma cutter designed for this precise application.

- https://github.com/meltoner/g-code-plasma-cutting

The fabricated mounting mechanism as plasma cut and welded with the first half part of the hinge is captured by the following photo.

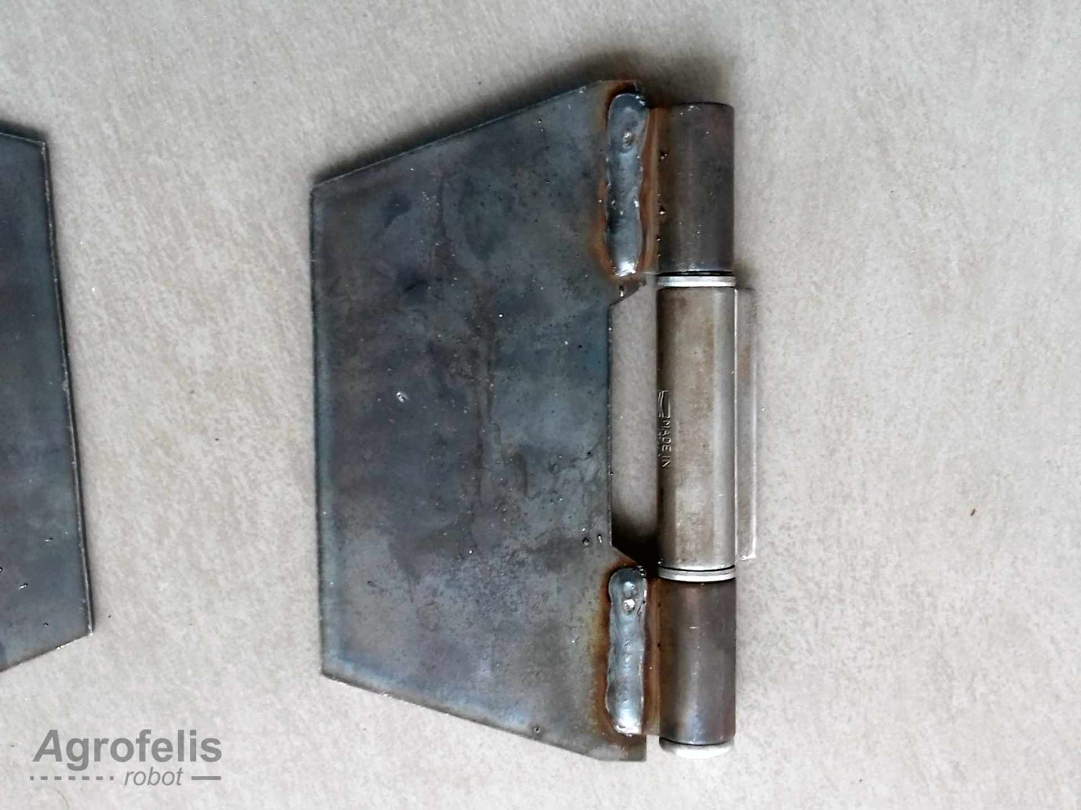
[picture p218: figure]

Figure 14: Hinge mount fabricated view a

A detailed view of the fork just prior to welding the second part of the hinge is depicted in the following photo.

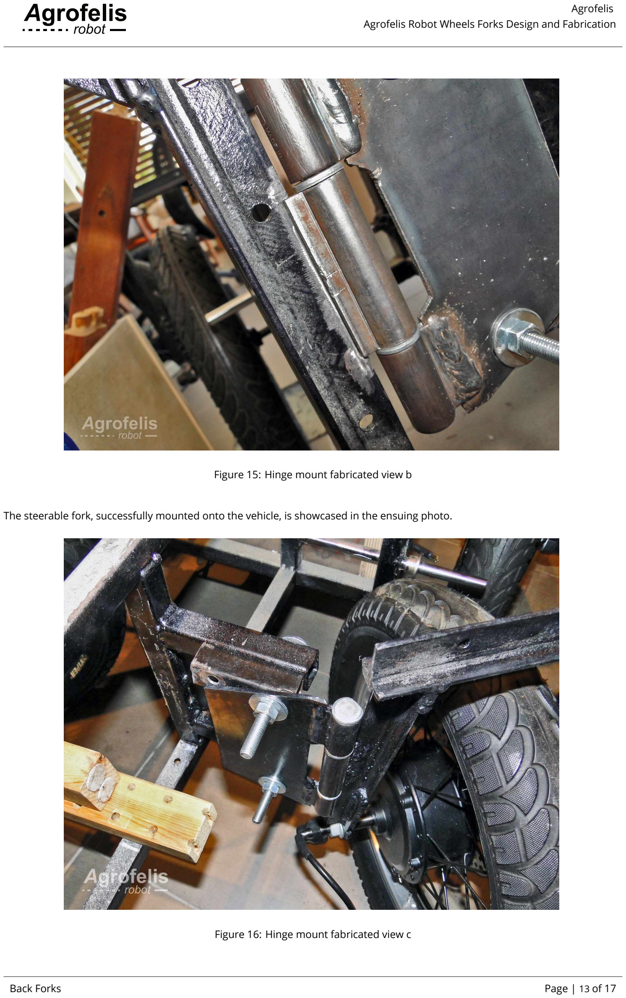
[picture p219: page 14]

Figure 15: Hinge mount fabricated view b

The steerable fork, successfully mounted onto the vehicle, is showcased in the ensuing photo.

Figure 16: Hinge mount fabricated view c

A bottom side focused view of the related mechanism after it has been painted is provided by the next image.

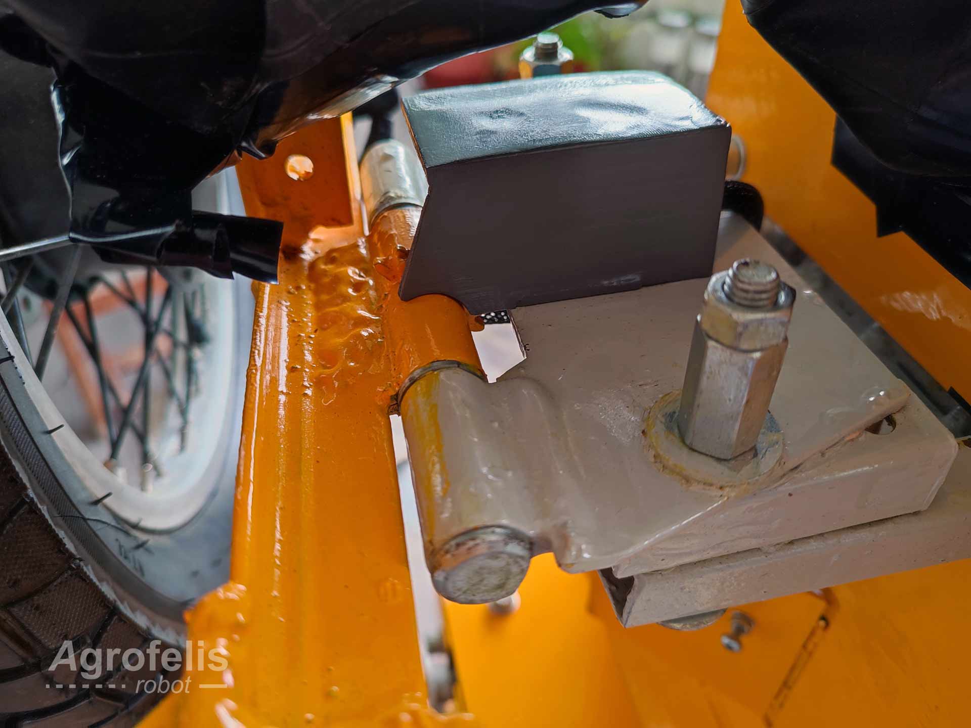
[picture p220: figure]

Figure 17: Hinge mount fabricated view d

A close-up photo revealing the dropout element of the fork with a disk brake attached to it, is displayed by the following photo.

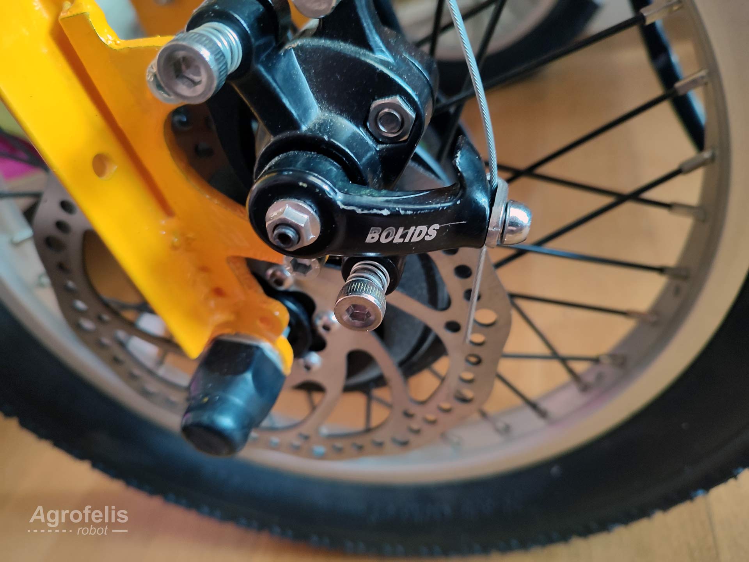
[picture p221: figure]

Figure 18: Hinge mount fabricated view d

## Forks Components and Indicative Suppliers

The following table lists the individual components employed for manufacturing the four Agrofelis forks and their mounting mechanism. The index table includes moreover the product URLs, the indicative suppliers, as well as the total unit price amounts.

No. | Product | Product URL | Supplier | Used
| | | | Quantity | VAT Price
| | | | | (€)

Subtotal
| | | | | | (€) | Note
#1 | 4 meter black iron T bar

| 25 x 3 | T bar (https://sitsianis.gr/%CF%80%CF%81%CE%BF%CE%B9%CE%BF%CE%BD%CF%84%CE%B1-%CF%83%CE%B9%CE%B4%CE%B7%CF%81%CE%BF%CF%85-%CE%BC%CE%B5%CF%84%CE%B1%CE%BB%CE%BB%CE%BF%CF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) | QOOP Met-
| | | alworks (https://www.qoop.gr) | 1 | 24.00 | 24.00 | -
#2 | Black iron metal sheet

| 1000x2000x3mm | 3mm metal
| | sheet (https://www.e-metalshop.gr/sidera/lamarynes/lamarina-sidhroy-mayrh-1000x2000x3mm) | QOOP Met-
| | | alworks (https://www.qoop.gr) | 0 | 73.85 | 0.00 | Already accounted in
| | | | | | | the chassis frame bill
| | | | | | | and material
#3 | Black iron metal sheet

| 600x400x4mm | 4mm metal
| | sheet (https://www.e-metalshop.gr/sidera/lamarynes/lamarina-sidhroy-mayrh-1000x2000x4mm) | QOOP Met-
| | | alworks (https://www.qoop.gr) | 1 | 15.00 | 15.00 | -
#4 | Bolt 12mm X 50mm | Bolt 12mm X

| | 50mm (https://www.vida.gr/exagones-vides-olopasses-m8-galvanize-metrikes-din-933/) | Vida (https://www.vida.gr) | 4 | 0.70 | 2.80 | -
#5 | 30 Nuts pack 12mm | Nuts 12mm (https://www.flextools.gr/index.php?route=product/product&path=260&product_id=1077) | Flextools (https://www.flextools.gr) | 1 | 1.50 | 1.50 | -

#6 | Welded Hinge with 3

| winds
Hinge (https://www.schmiedekult.de/Hinges-for-welding-with-3-wings-and-removable-pin) | Schmiedekult (https://www.schmiedekult.de/Schmiedekult-EN) 2 | 5.00 | 10.00 | -
Total | | | | | | 53.30

The total cost to manufacture four Agrofelis forks, exclusive of shipping and assembly expenses, totals approximately 53 euros.

Forks Components and Indicative Suppliers | Page | 15 of 17

## Summary

The development process, component details, essential dimensions and Numerical Control source files for reproducing the Agrofelis wheels forks have all been documented in a progressive manner. To conclude, an image depicting the vehicle with a focus on its front and back forks is presented below.

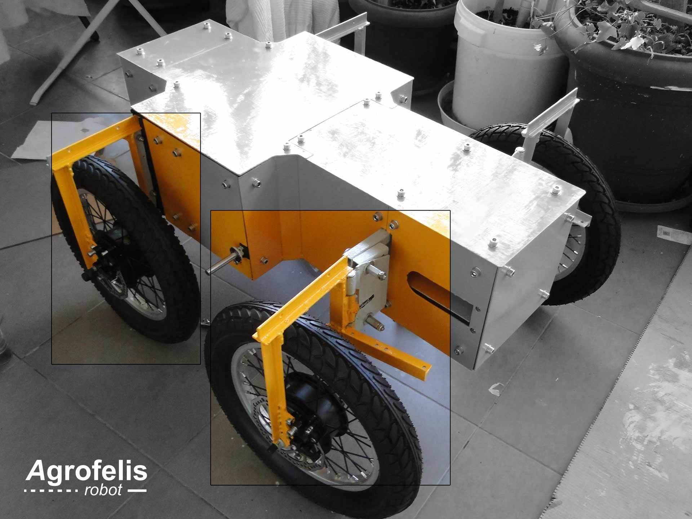
[picture p222: figure]

Figure 19: Vehicle with focus on the forks

Summary | Page | 16 of 17

# End of document

Summary | Page | 17 of 17
