meltoner/agrofelis/components/implement-2-degrees-rotating-mount/assets/3d-print/RotationTableWalls/howwalls.png

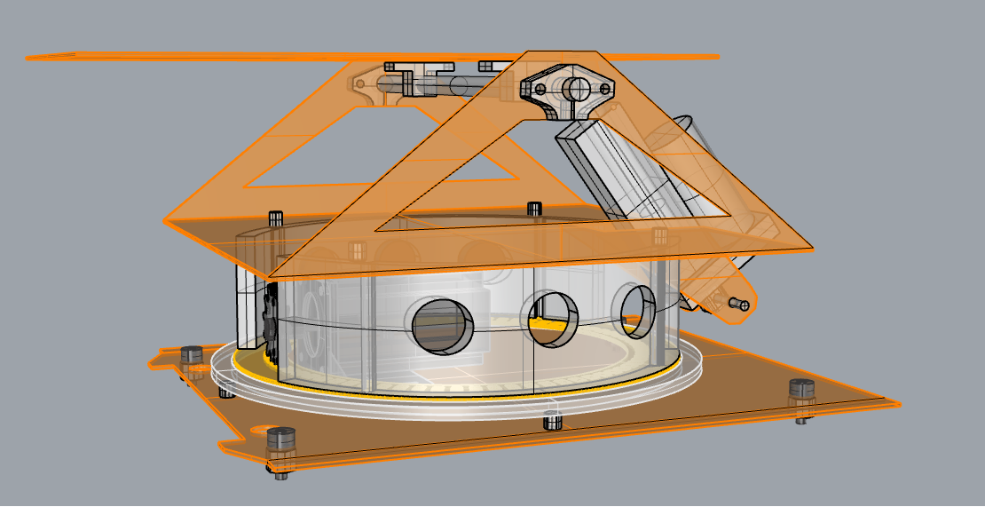
components/implement-2-degrees-rotating-mount/assets/3d-print/RotationTableWalls/howwalls.png
