meltoner/agrofelis/components/vehicle-steering/driver-board/STEERING_DRIVER_document.pdf

# STEERING DRIVER

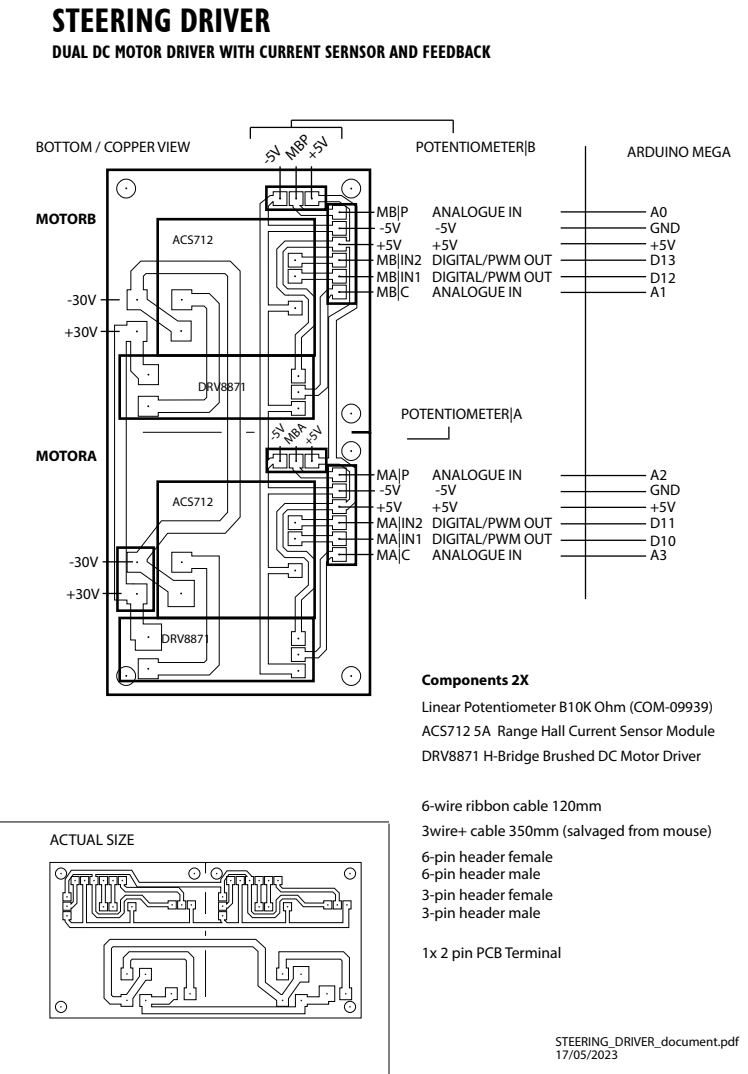
[picture p244: page 1]
STEERING_DRIVER_document.pdf 17/05/2023; ACTUAL SIZE; BOTTOM / COPPER VIEW; ARDUINO MEGA; ANALOGUE IN; GND +5V D13 D12 A1; A2 GND +5V D11 D10 A3; MOTORB; MOTORA; POTENTIOMETER|B -5VMBP+5V; POTENTIOMETER|A; MBA +5V; ACS712; DRV8871

DUAL DC MOTOR DRIVER WITH CURRENT SERNSOR AND FEEDBACK

MB|IN2 DIGITAL/PWM OUT
MB|IN1 DIGITAL/PWM OUT

ANALOGUE IN
DIGITAL/PWM OUT

Components 2X
Linear Potentiometer B10K Ohm (COM-09939)
ACS712 5A Range Hall Current Sensor Module
DRV8871 H-Bridge Brushed DC Motor Driver

6-wire ribbon cable 120mm
3wire+ cable 350mm (salvaged from mouse)
6-pin header female
6-pin header male
3-pin header female
3-pin header male

1x 2 pin PCB Terminal
