meltoner/agrofelis/components/vehicle-steering/_figures/pdf/vehicle-steering-25-R-left-right-ackerman-differences.pdf

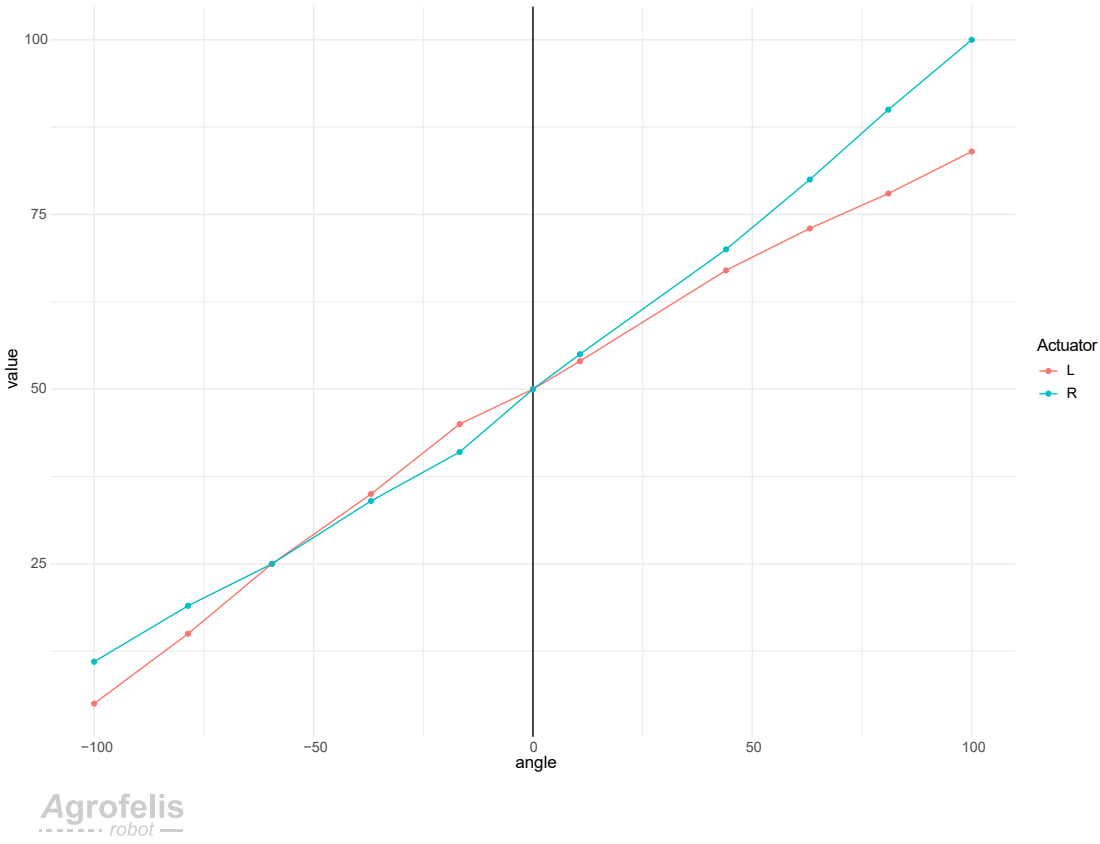
[picture p245: page 1]
angle; value; Actuator L R
