meltoner/agrofelis/components/vehicle-steering/_figures/pdf/vehicle-steering-23_STEERING_DRIVER.pdf

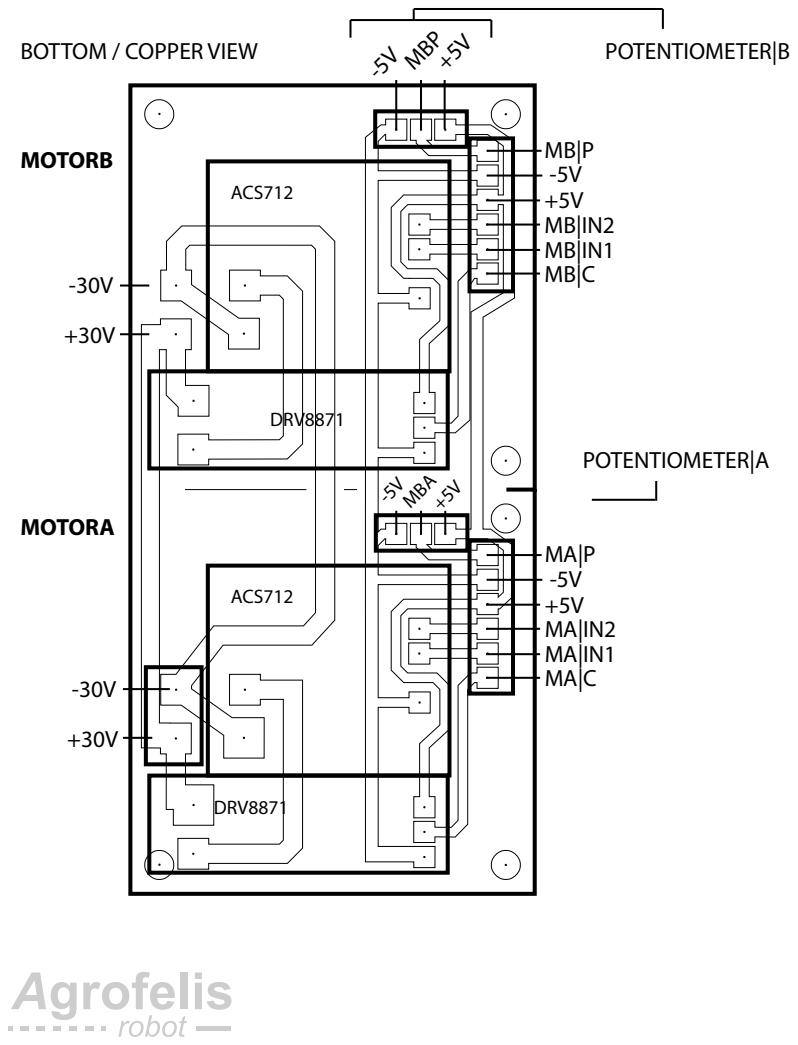
[picture p246: page 1]
MB|P MOTORB; MOTORA; POTENTIOMETER|B -5VMBP +5V; POTENTIOMETER|A; MBA +5V; ACS712; DRV8871

BOTTOM / COPPER VIEW
