meltoner/agrofelis/components/vehicle-steering/_figures/pdf/vehicle-steering-23_STEERING_DRIVER_connections.pdf

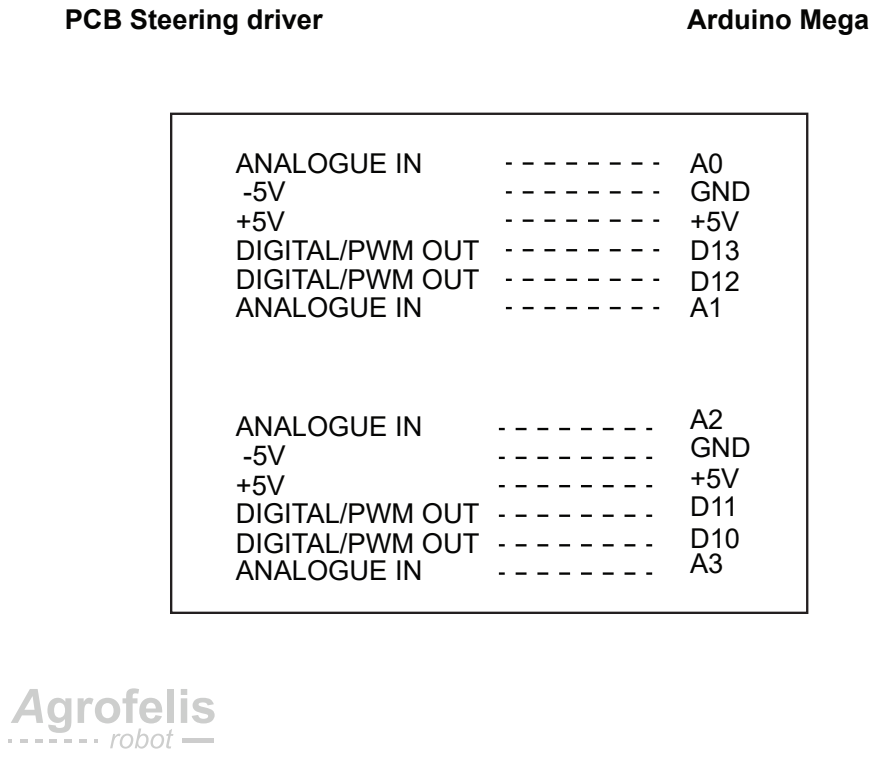
[picture p247: page 1]
PCB Steering driver; Arduino Mega; ANALOGUE IN; GND +5V D13 D12 A1; A2 GND +5V D11 D10 A3

DIGITAL/PWM OUT
ANALOGUE IN
