meltoner/agrofelis/components/vehicle-steering/_figures/pdf/vehicle-steering-24-STEERING_DRIVER_CABLES_LABELS.pdf

# MOTOR B MOTOR A

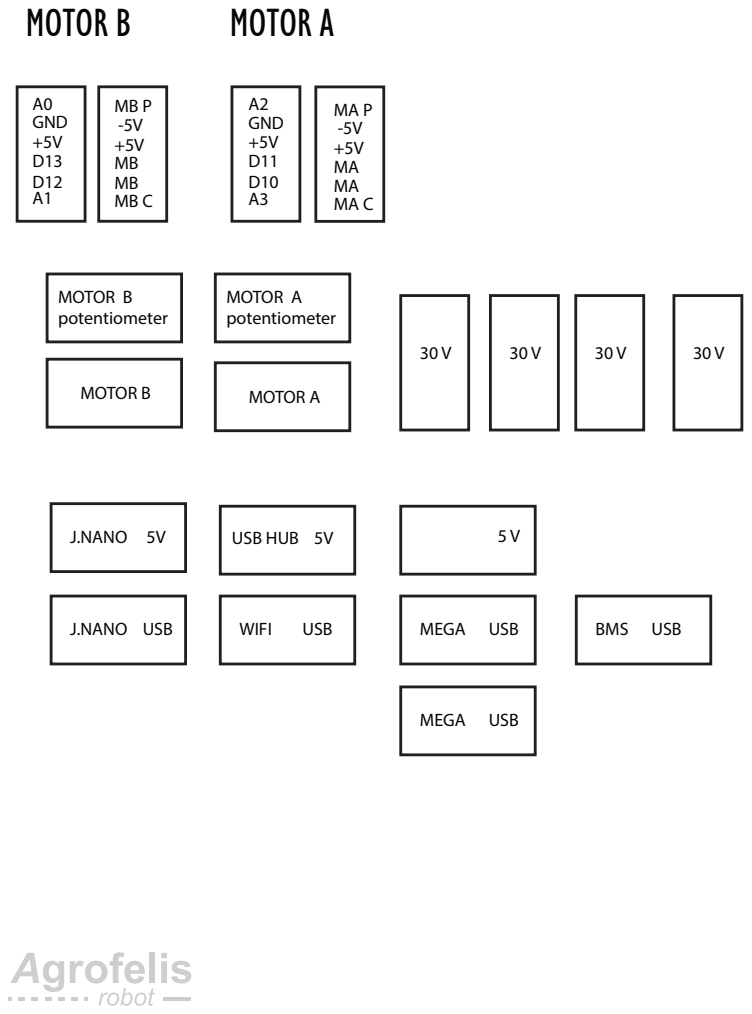
[picture p248: page 1]
MOTOR A potentiometer; A0 GND +5V D13 D12 A1; A2 GND +5V D11 D10 A3; MOTOR A; J.NANO 5V; J.NANO USB; WIFI; USB; MEGA USB; BMS USB; USB HUB 5V; MOTOR B; MOTOR B potentiometer
