meltoner/agrofelis/components/vehicle-wheels/_figures/pdf/vehicle-wheels-02.pdf

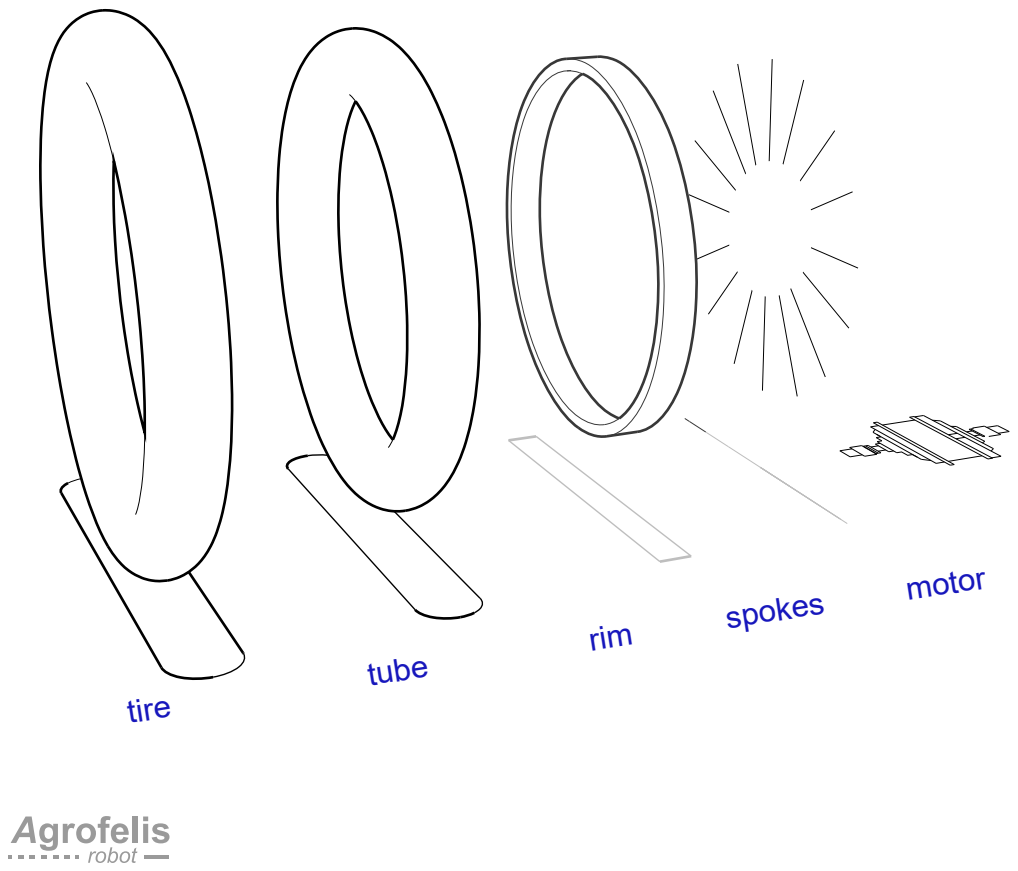
[picture p249: page 1]
tire; tube; rim; spokes; motor
