meltoner/agrofelis/components/vehicle-wheels/_figures/pdf/vehicle-wheels-03.pdf

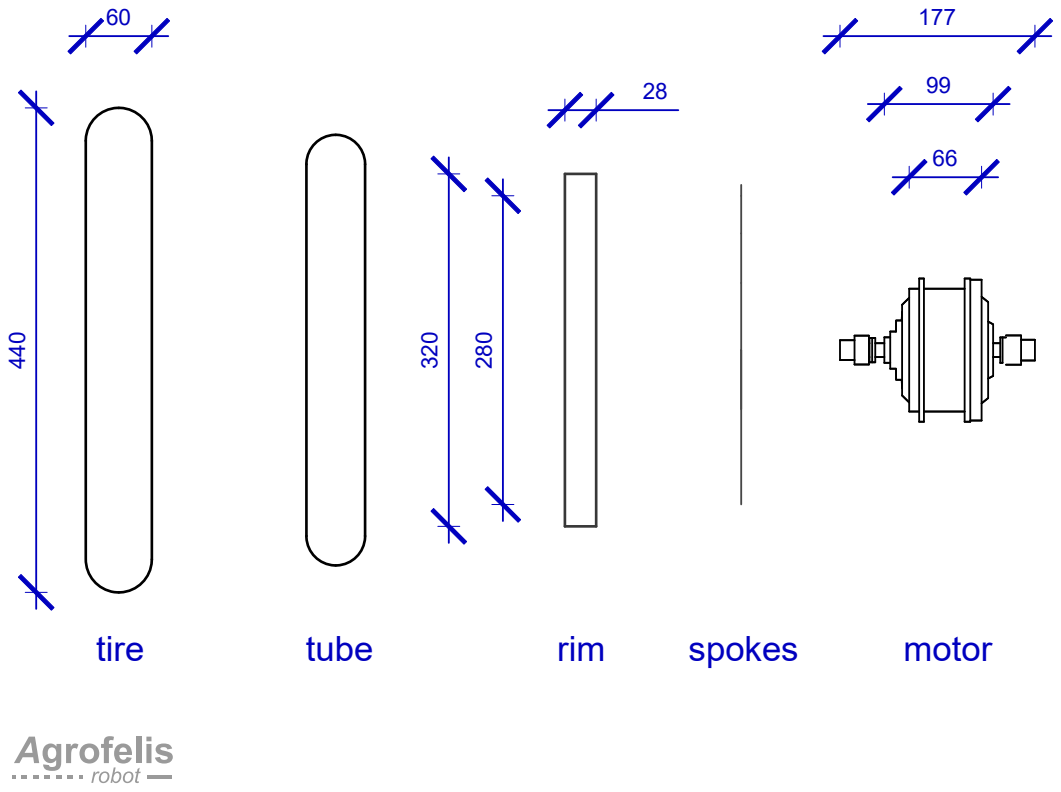
[picture p250: page 1]
tire; tube; rim; spokes; motor
