meltoner/agrofelis/components/vehicle-wheels/assets/36holes-16-inch-pattern.pdf

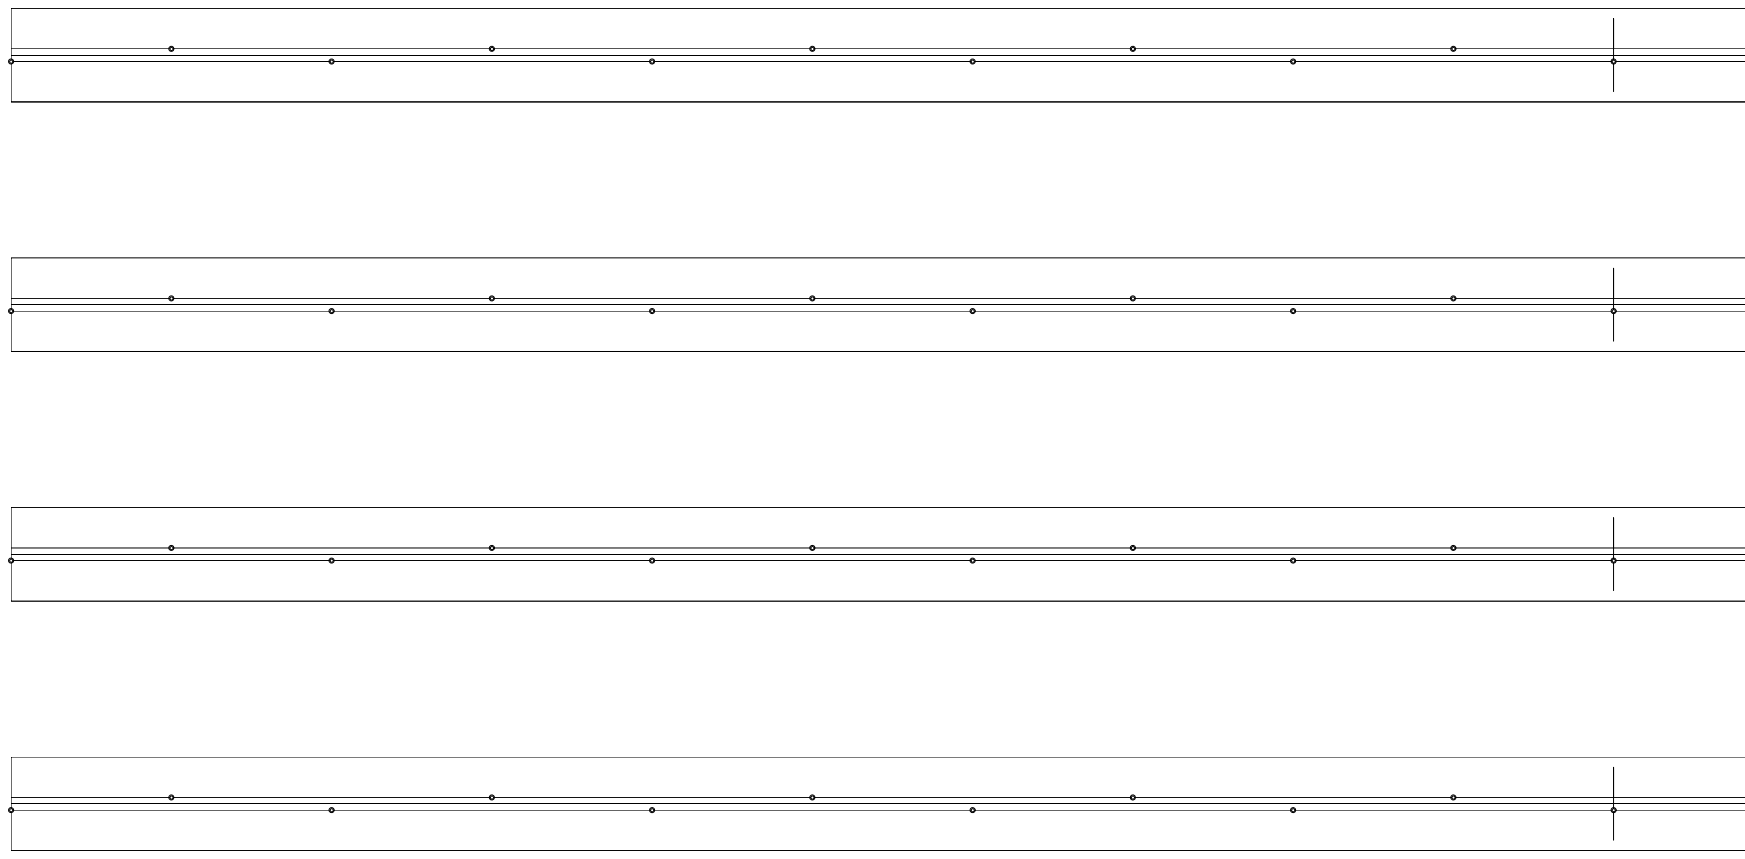
[picture p251: page 1]
