meltoner/agrofelis/components/connectivity/_figures/pdf/computing-00-overview.pdf

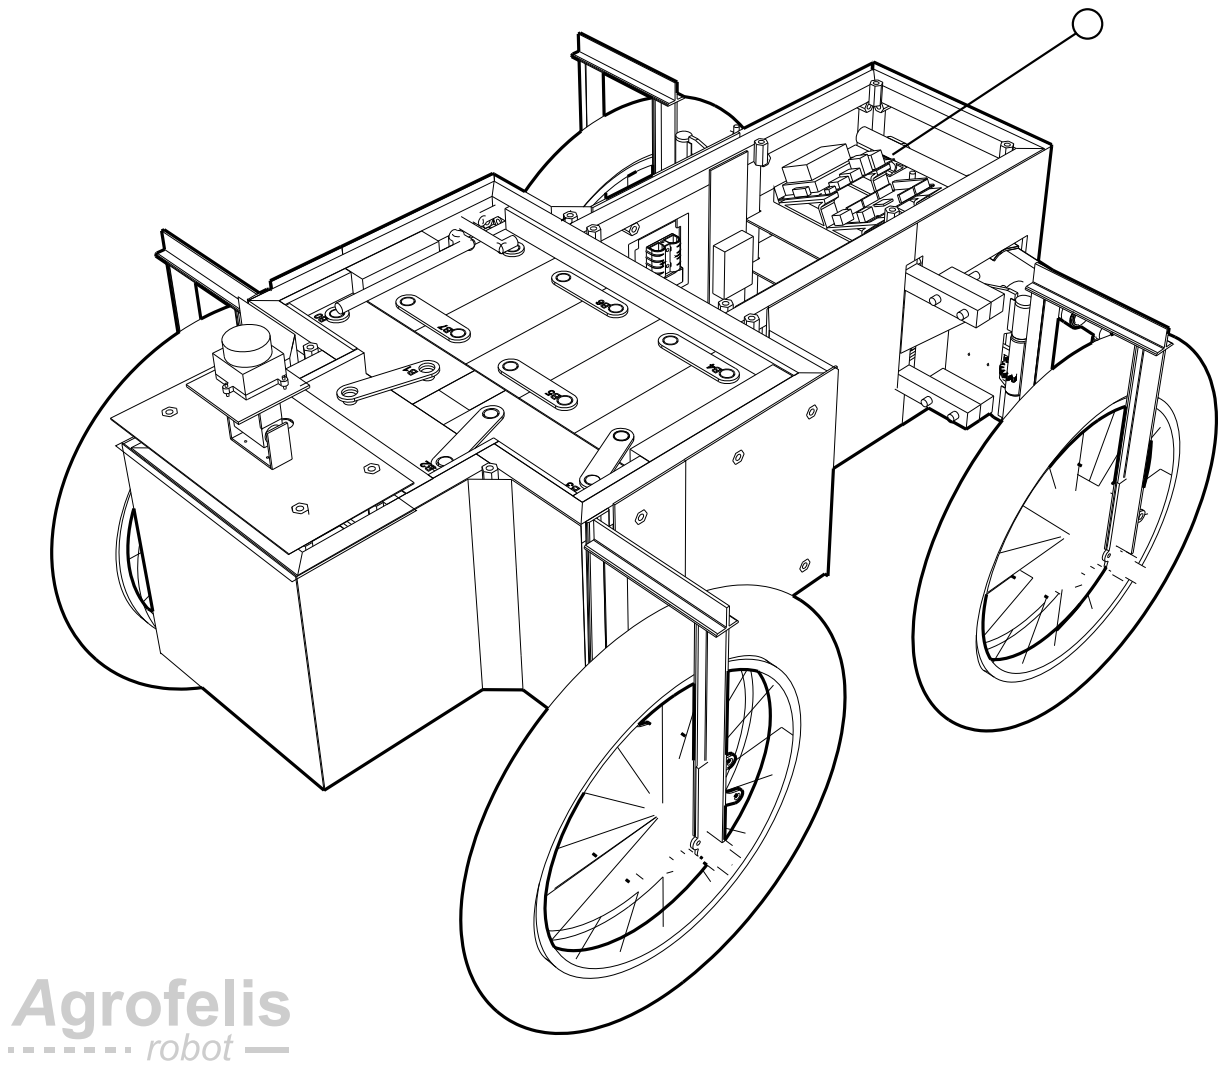
[picture p252: page 1]
