meltoner/agrofelis/components/connectivity/_figures/pdf/computing-06-0-schematic.pdf

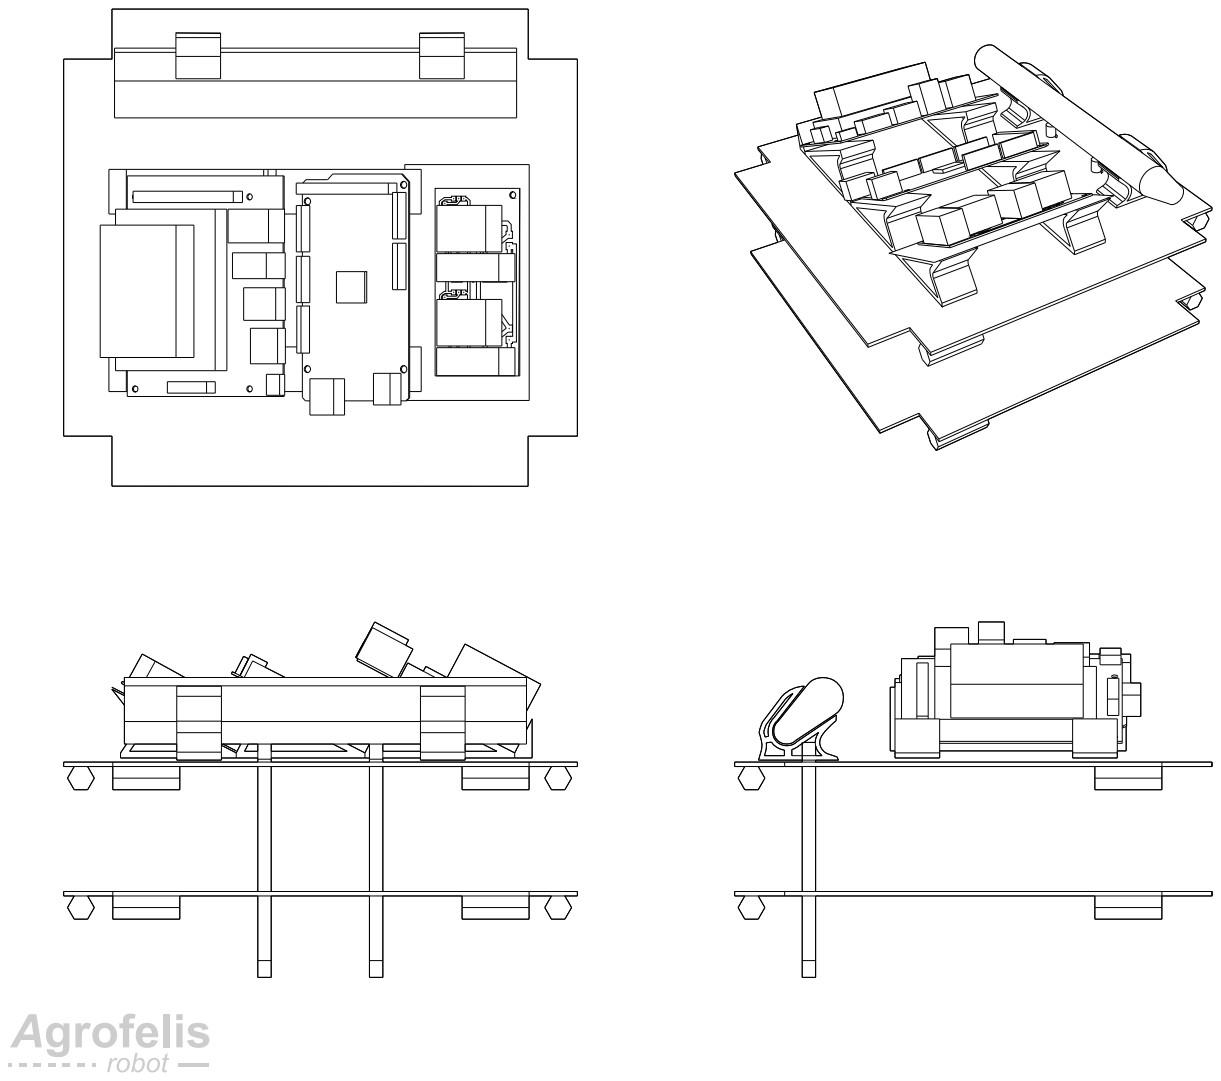
[picture p253: page 1]
