meltoner/agrofelis/components/connectivity/_figures/pdf/computing-06-1-3d-print-brackets.pdf

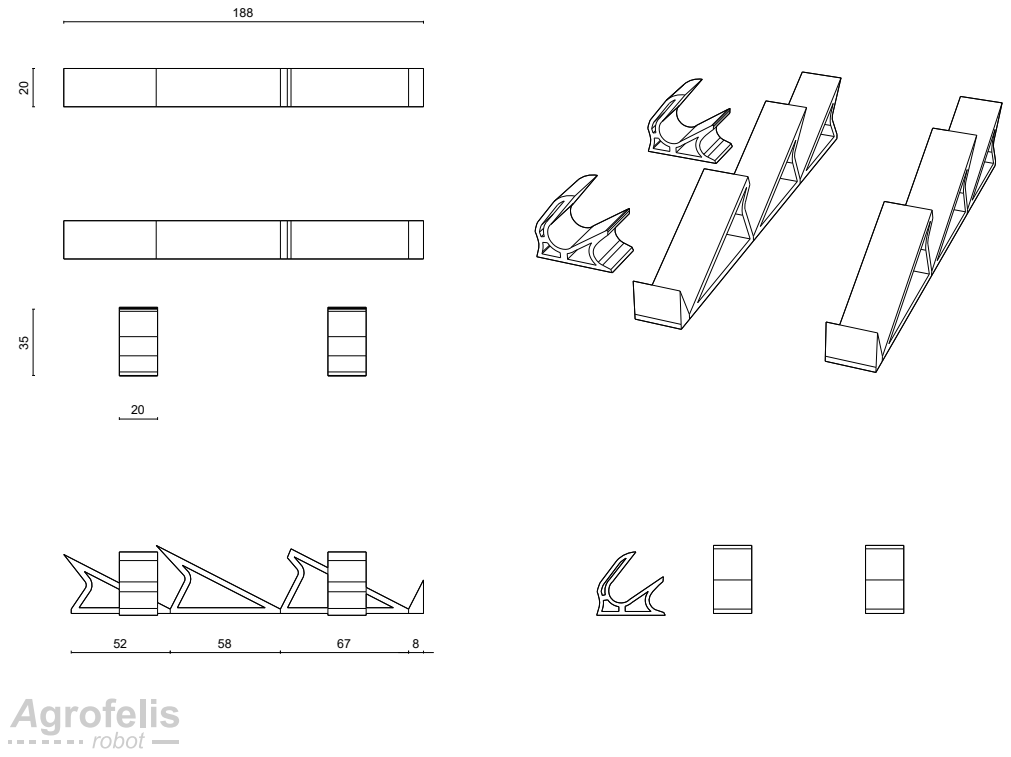
[picture p254: page 1]
