meltoner/agrofelis/components/remote-control/_figures/pdf/hlighted-remote-control-02-module-schematics.pdf

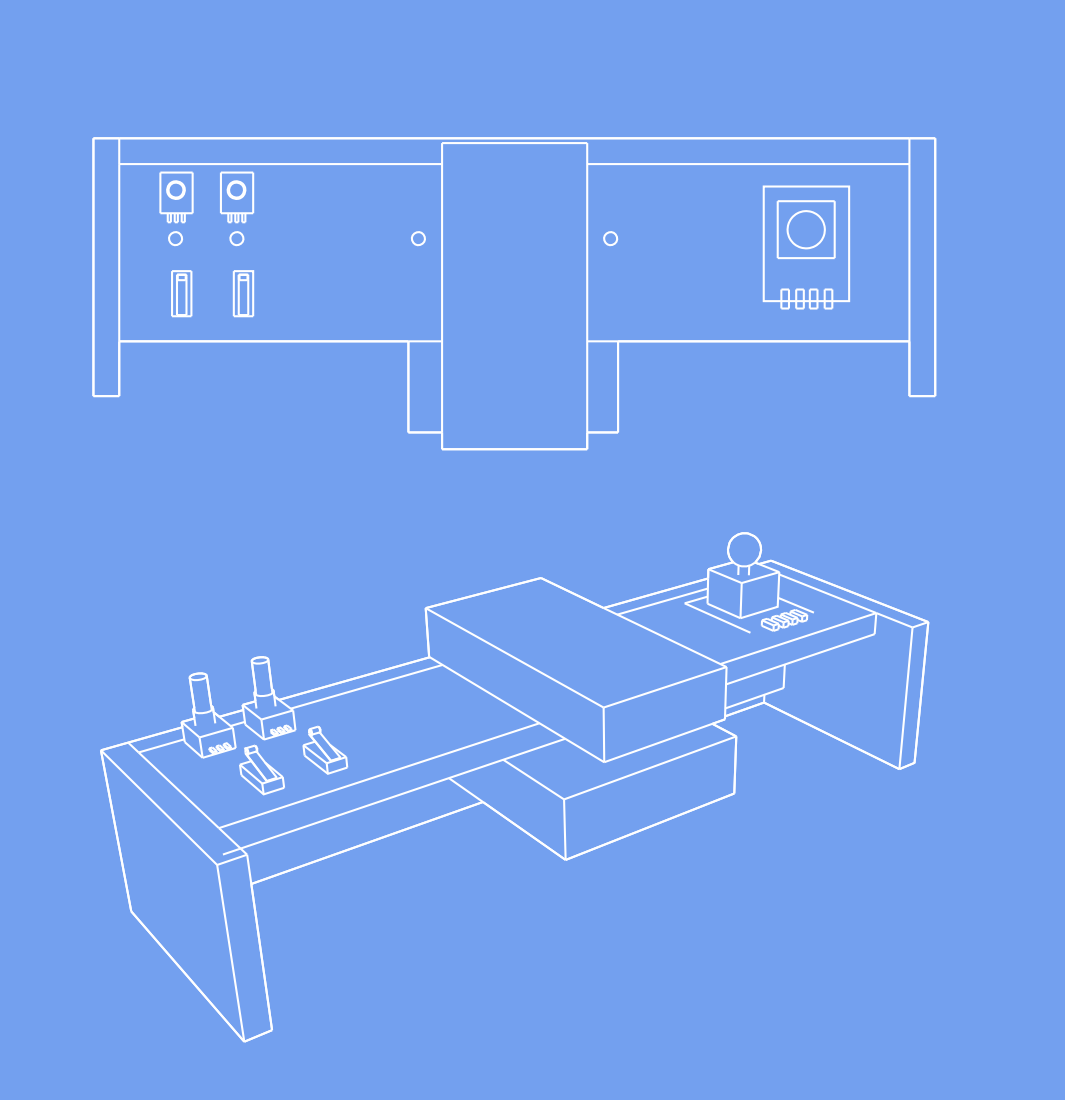
[picture p255: page 1]
