meltoner/agrofelis/components/remote-control/_figures/pdf/remote-control-01-structure-schematics.pdf

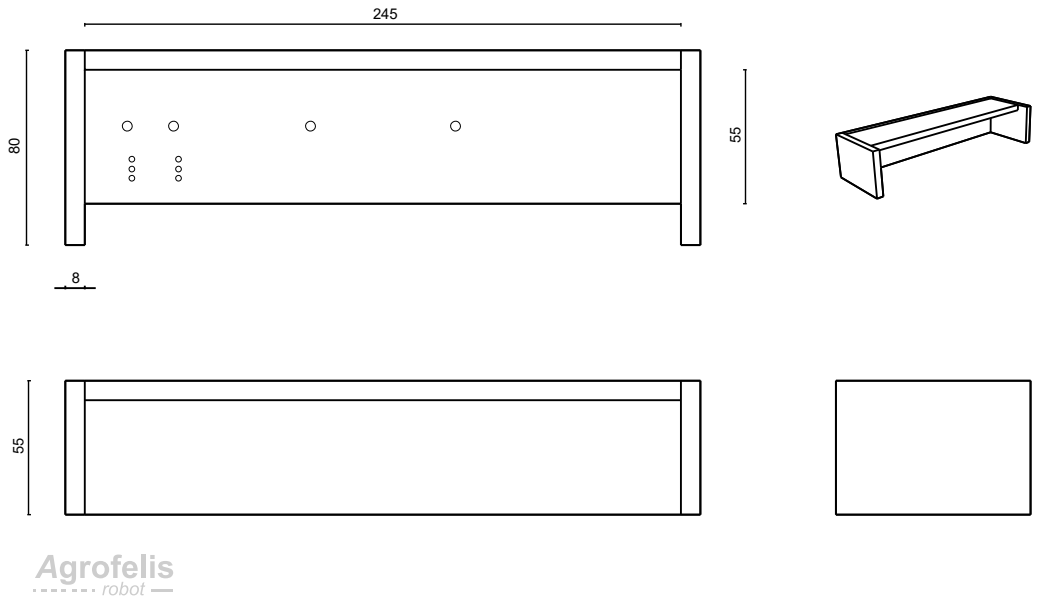
[picture p256: page 1]
