meltoner/agrofelis/components/remote-control/_figures/pdf/remote-control-02-module-schematics.pdf

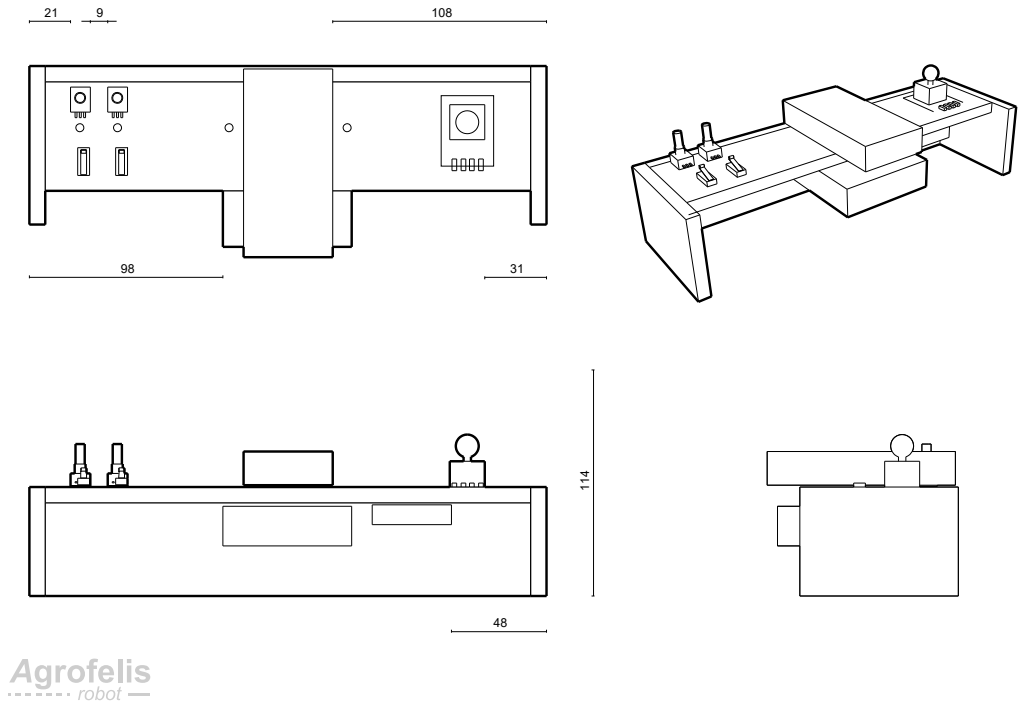
[picture p257: page 1]
