meltoner/agrofelis/components/remote-control/_figures/pdf/remote-control-03-module-exploded.pdf

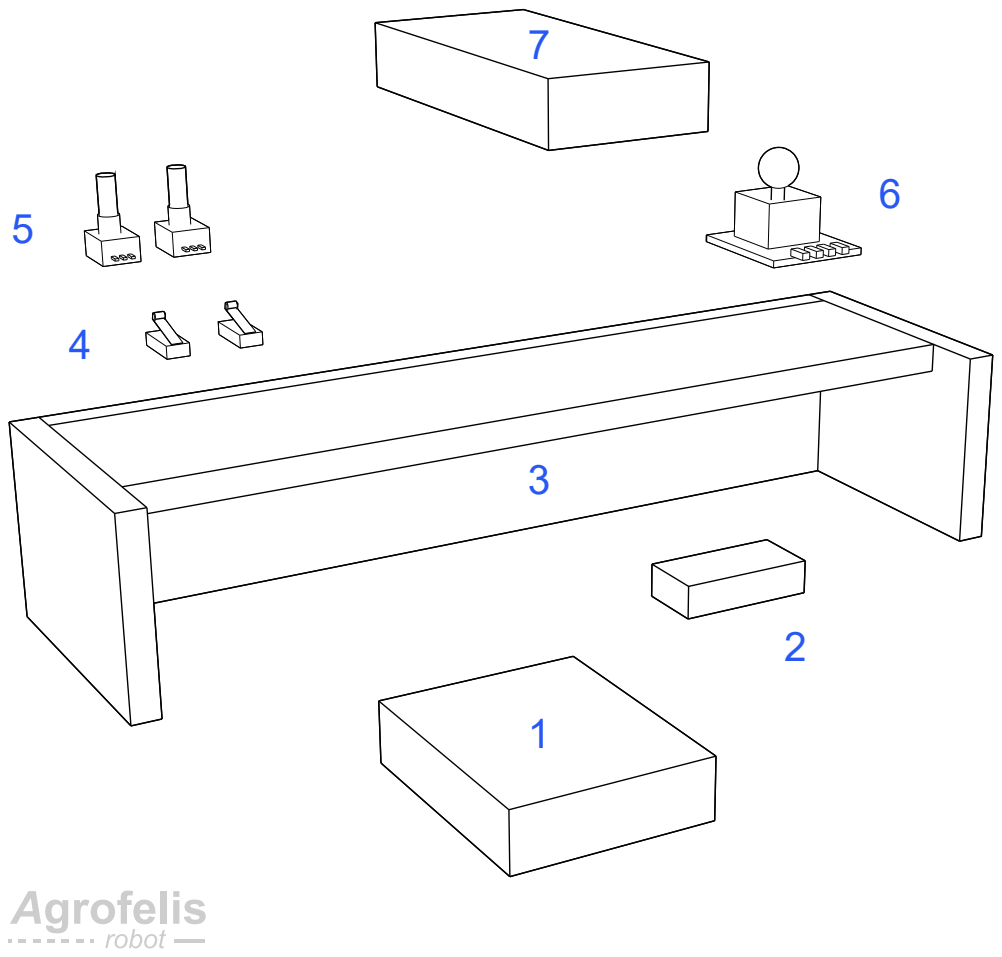
[picture p258: page 1]
