meltoner/agrofelis/components/implement-2-degrees-rotating-mount/assets/stainless-steel-laser-cut/laser-cut_stainless_gear_disk_motor_gear_order_preview.pdf

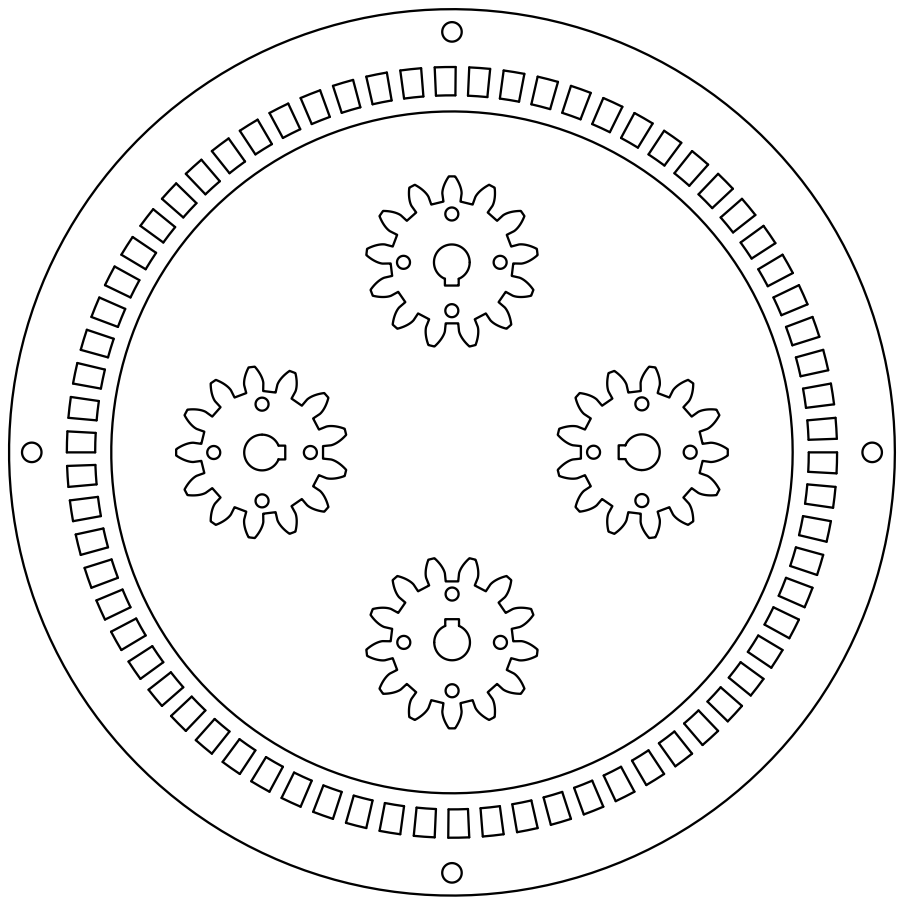
[picture p259: page 1]
