meltoner/agrofelis/components/implement-2-degrees-rotating-mount/_figures/pdf/_vehicle-2-degrees-rotating-implement-mount-01-.pdf

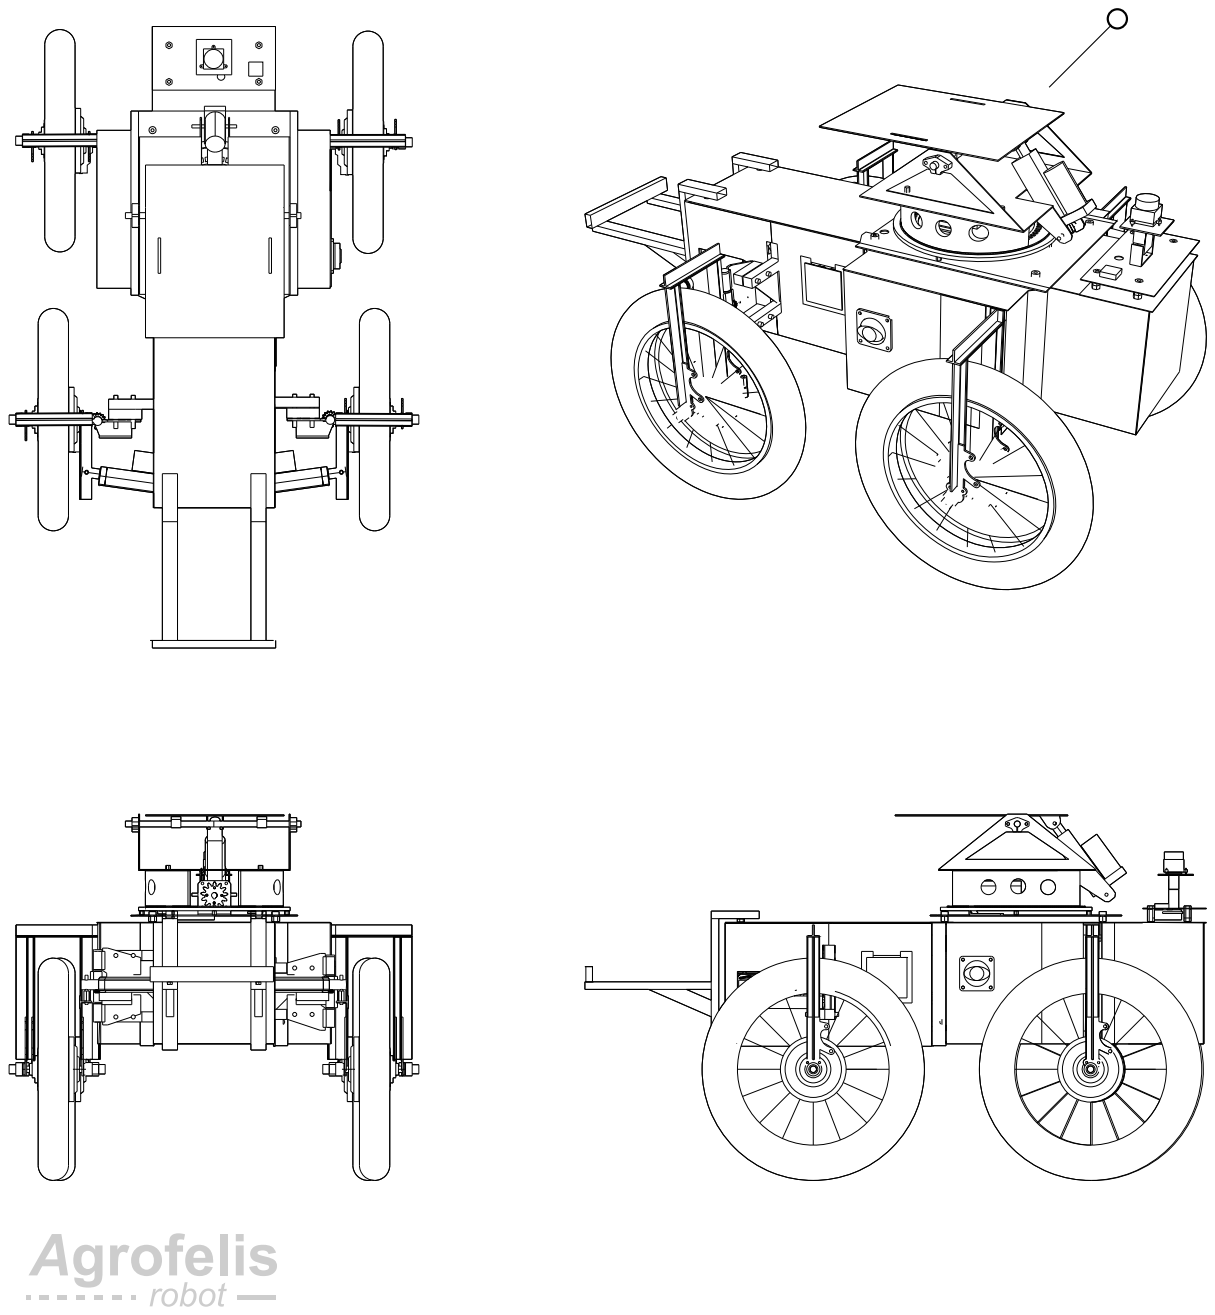
[picture p260: page 1]
