meltoner/agrofelis/components/implement-2-degrees-rotating-mount/_figures/pdf/_vehicle-2-degrees-rotating-implement-mount-02-.pdf

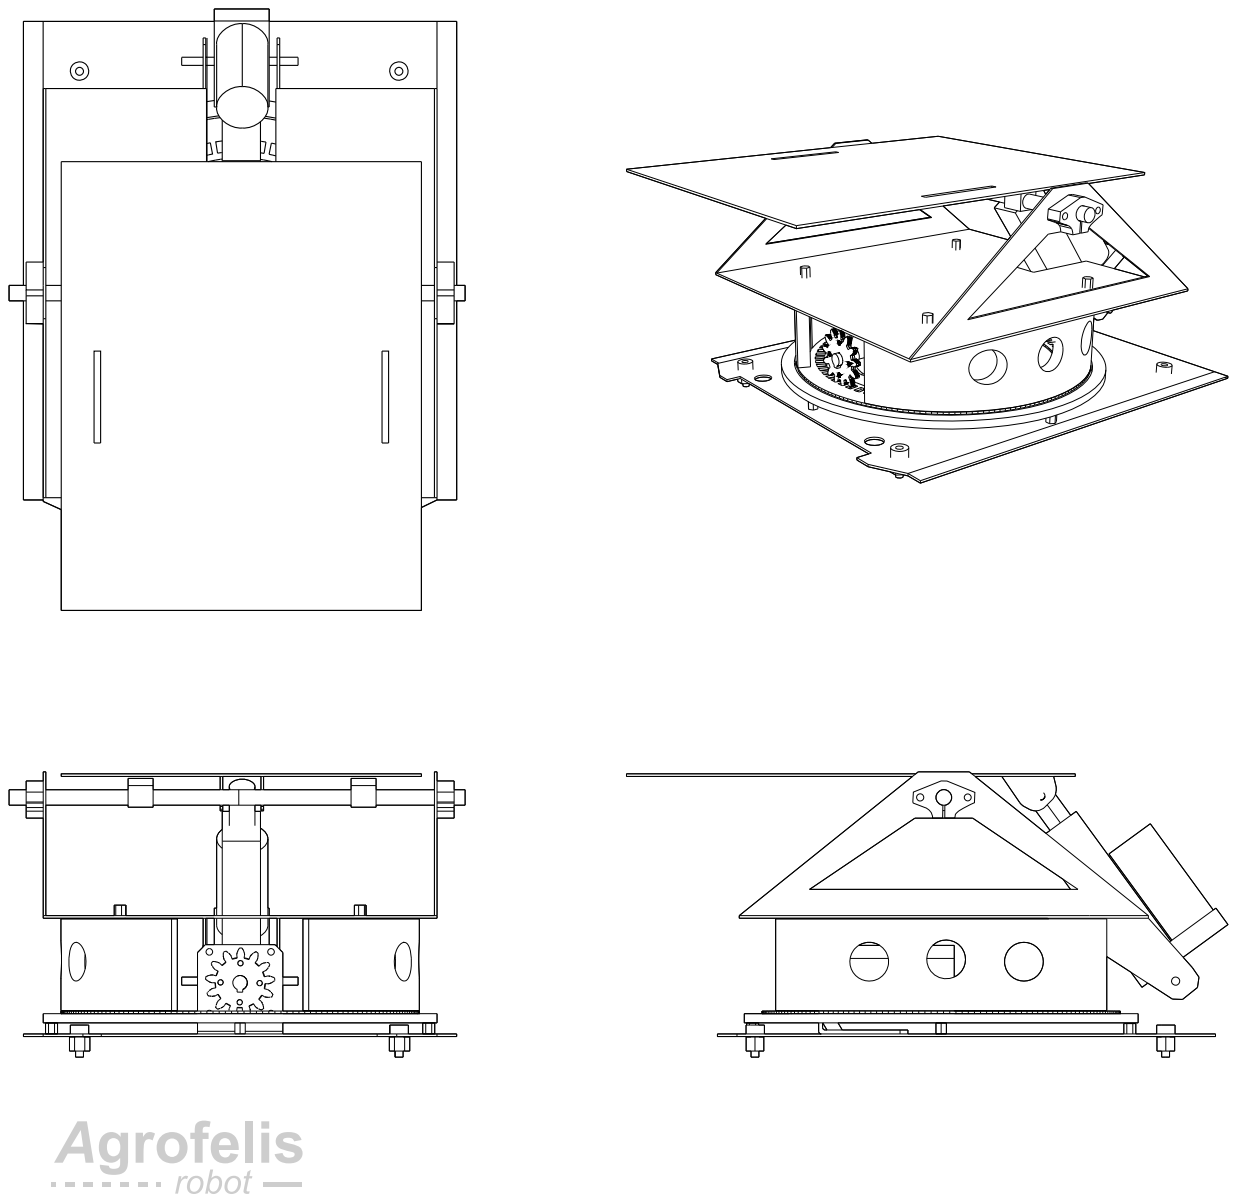
[picture p261: page 1]
