meltoner/agrofelis/components/implement-2-degrees-rotating-mount/_figures/pdf/_vehicle-2-degrees-rotating-implement-mount-04-.pdf

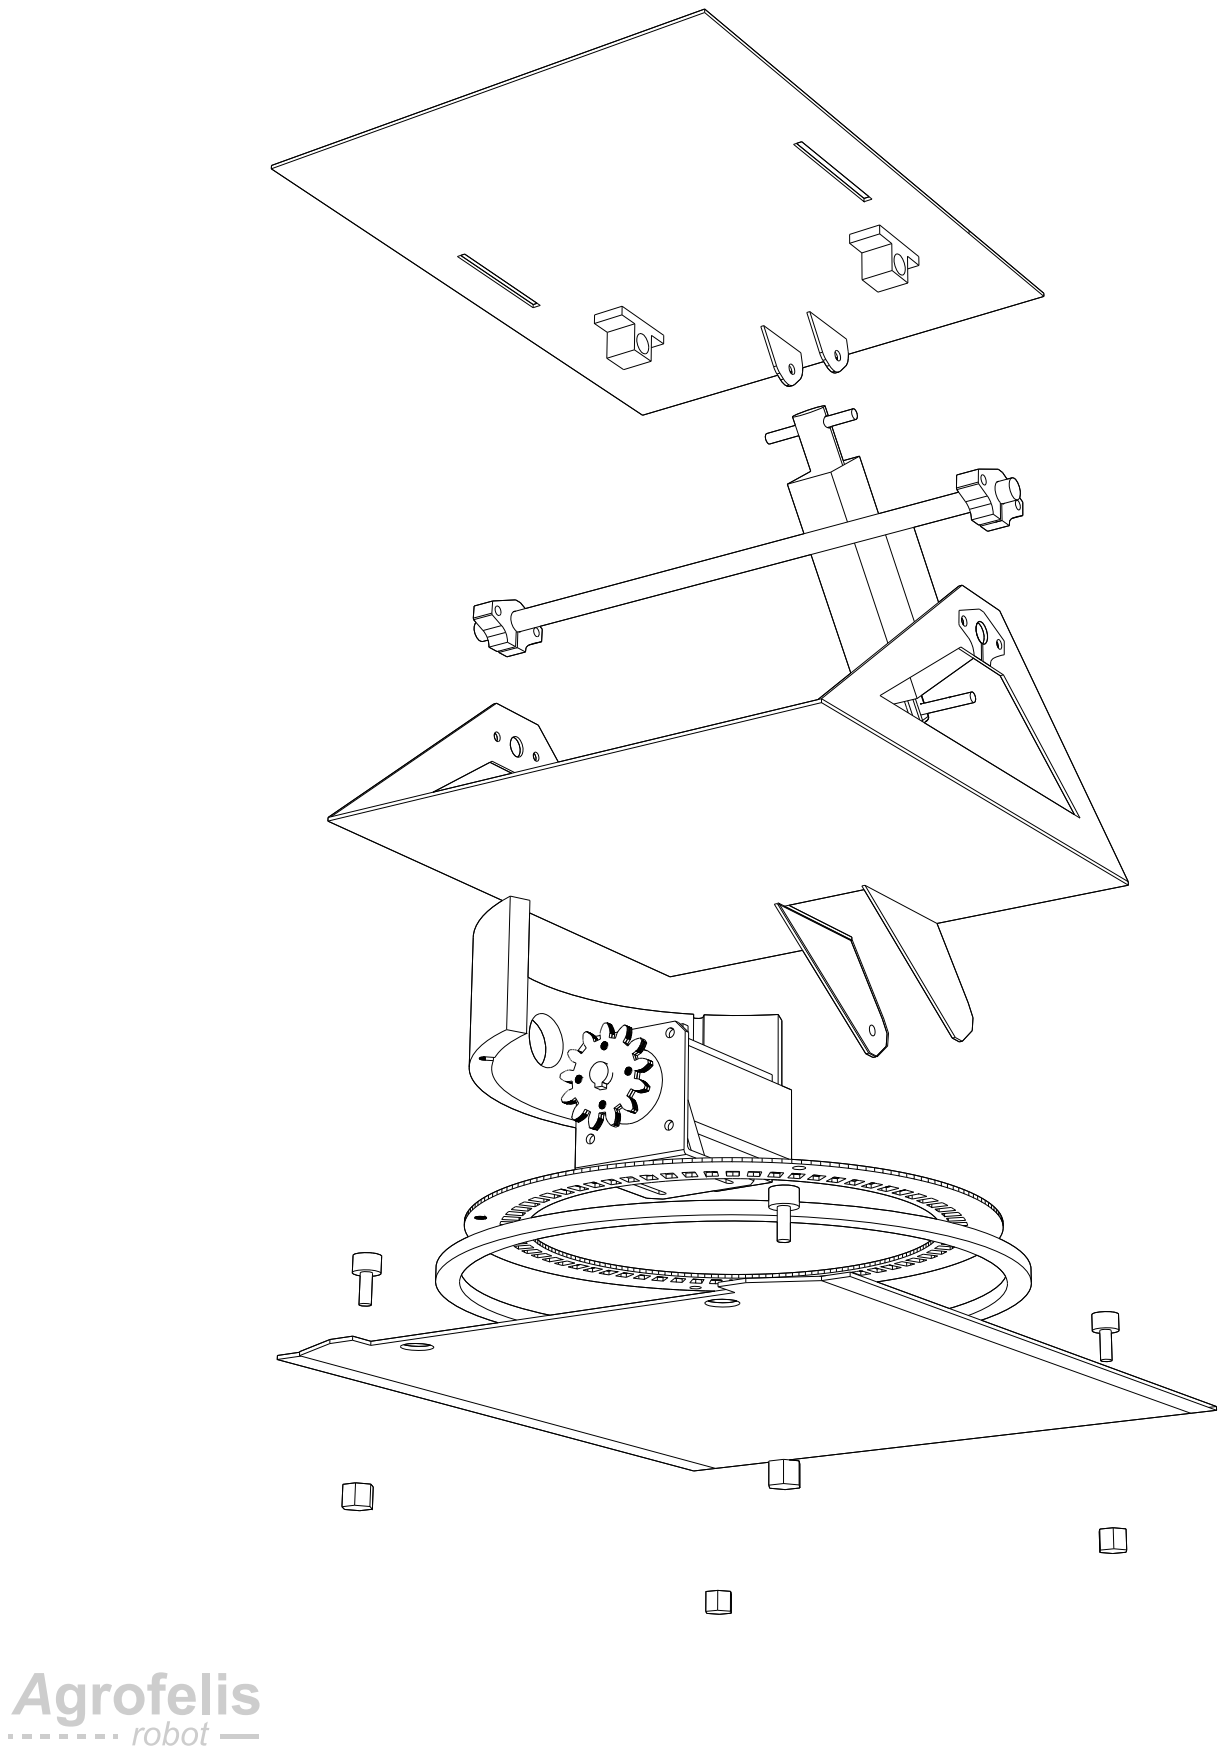
[picture p262: page 1]
