meltoner/agrofelis/components/implement-2-degrees-rotating-mount/_figures/pdf/_vehicle-2-degrees-rotating-implement-mount-05-.pdf

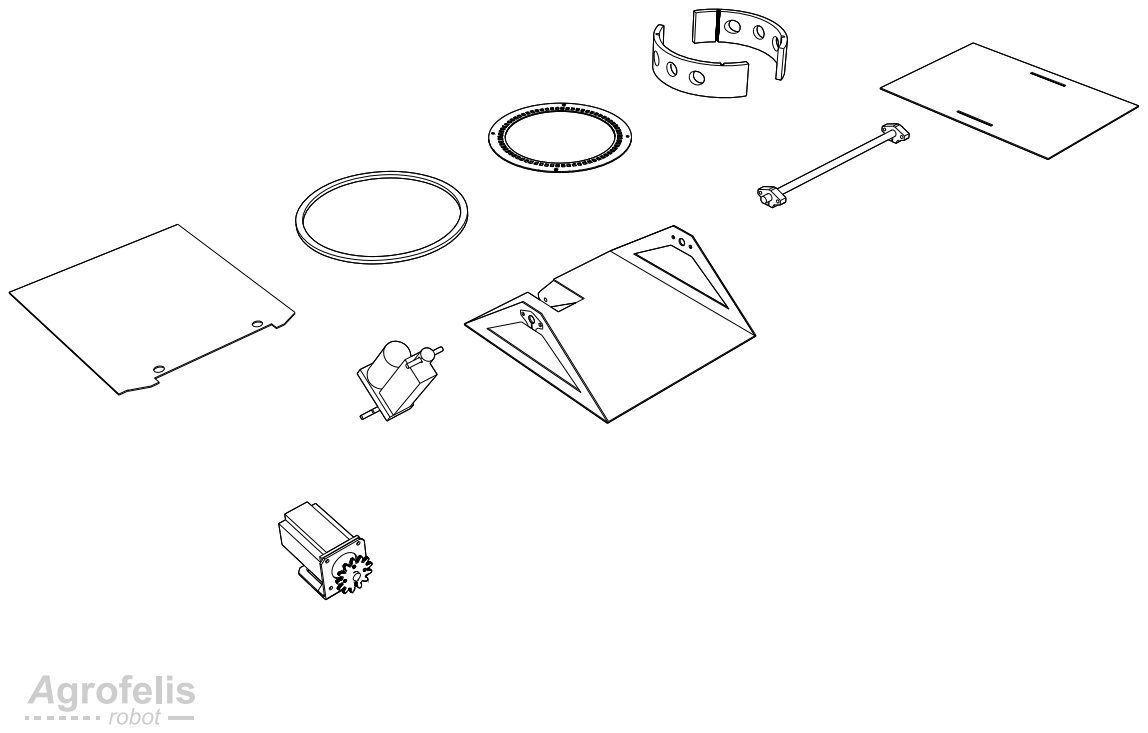
[picture p263: page 1]
