meltoner/agrofelis/components/implement-2-degrees-rotating-mount/_figures/pdf/_vehicle-2-degrees-rotating-implement-mount-06-.pdf

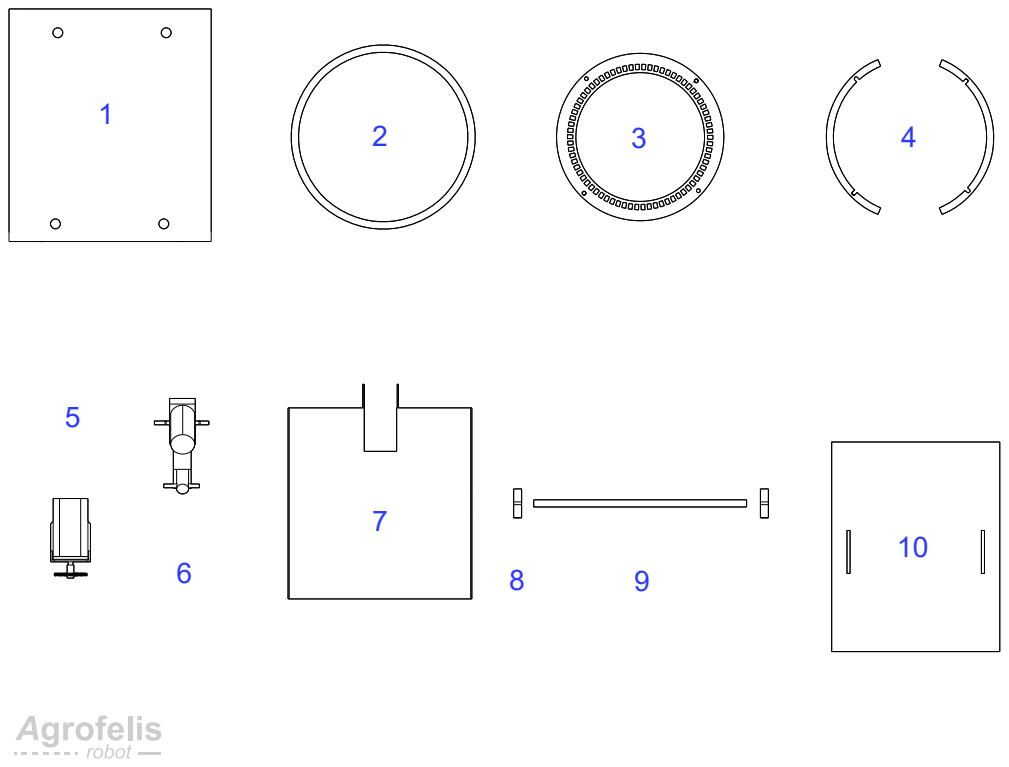
[picture p264: page 1]
