meltoner/agrofelis/components/vehicle-lidar/_figures/pdf/vehicle-lidar-01-lidar-overview.pdf

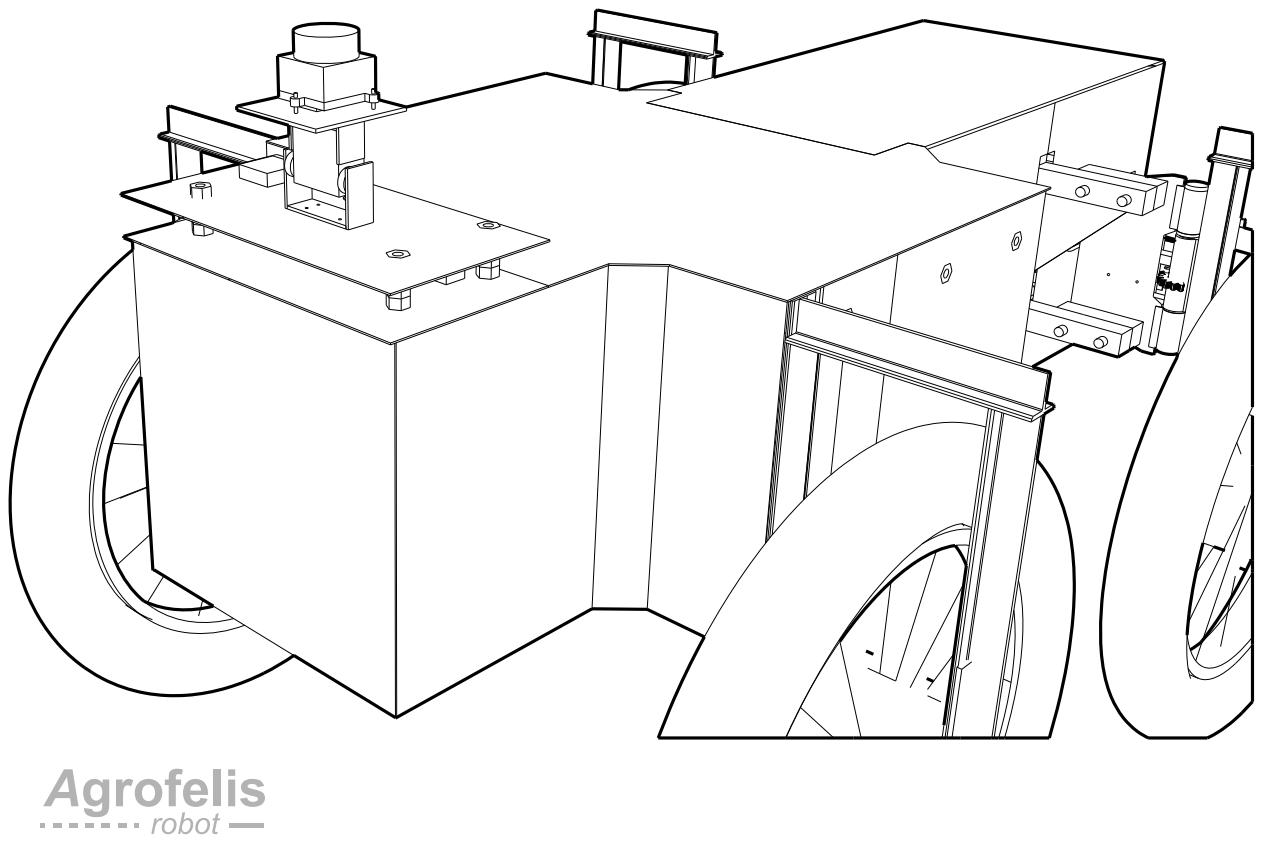
[picture p271: page 1]
