meltoner/agrofelis/components/vehicle-lidar/_figures/pdf/vehicle-lidar-02-lidar-dimensions.pdf

244

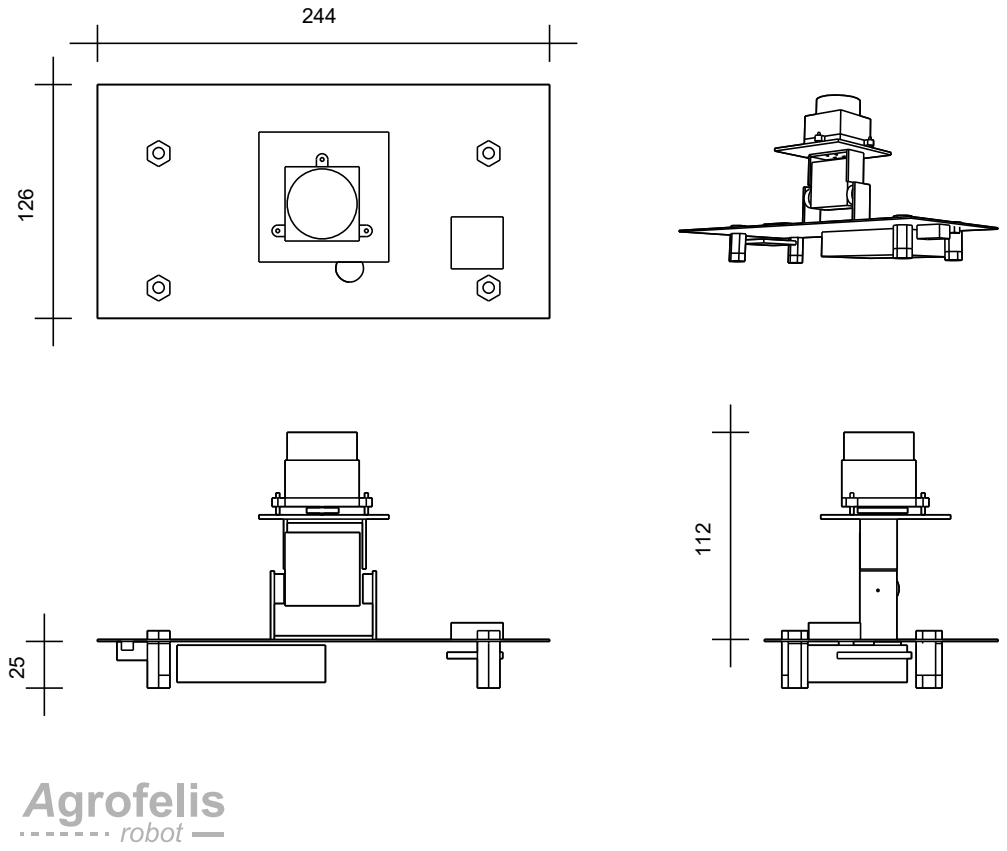
[picture p272: page 1]
