meltoner/agrofelis/components/vehicle-lidar/_figures/pdf/vehicle-lidar-03-lidar-exploded-view.pdf

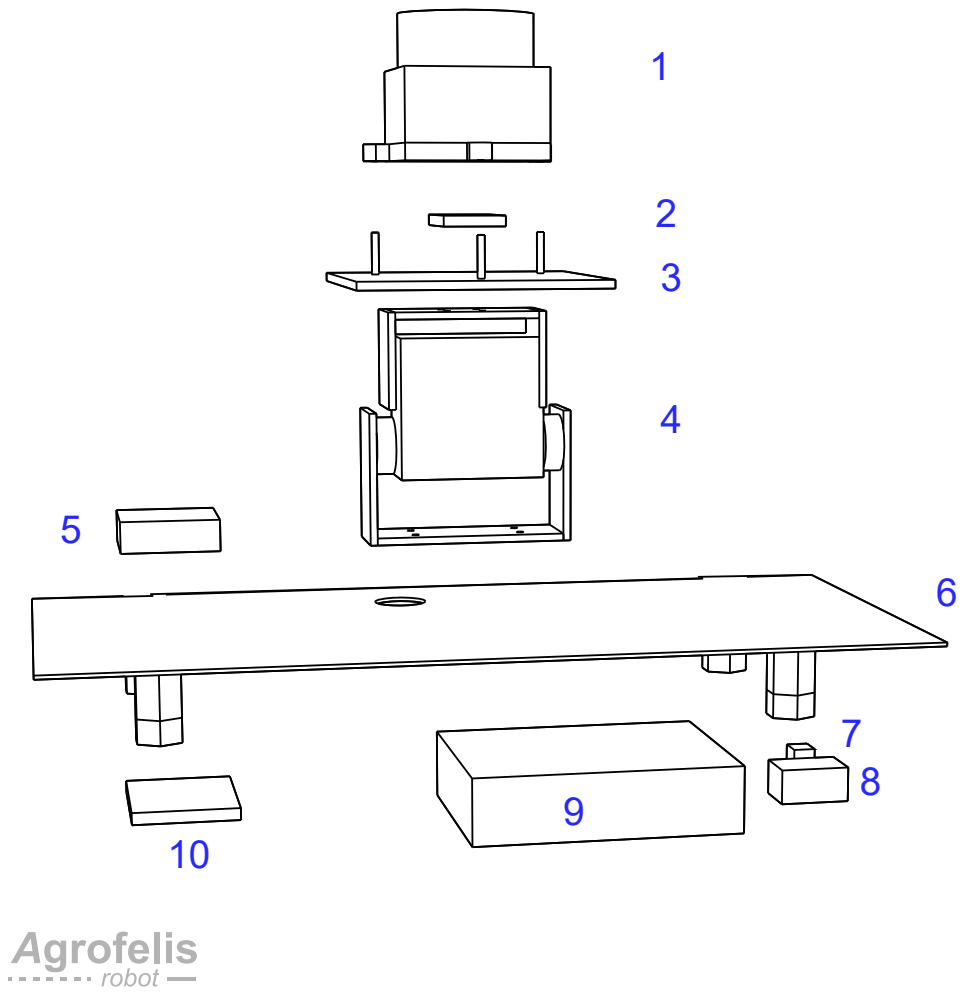
[picture p273: page 1]
