meltoner/agrofelis/components/vehicle-lidar/_figures/pdf/vehicle-lidar-with-rotating-implement.pdf

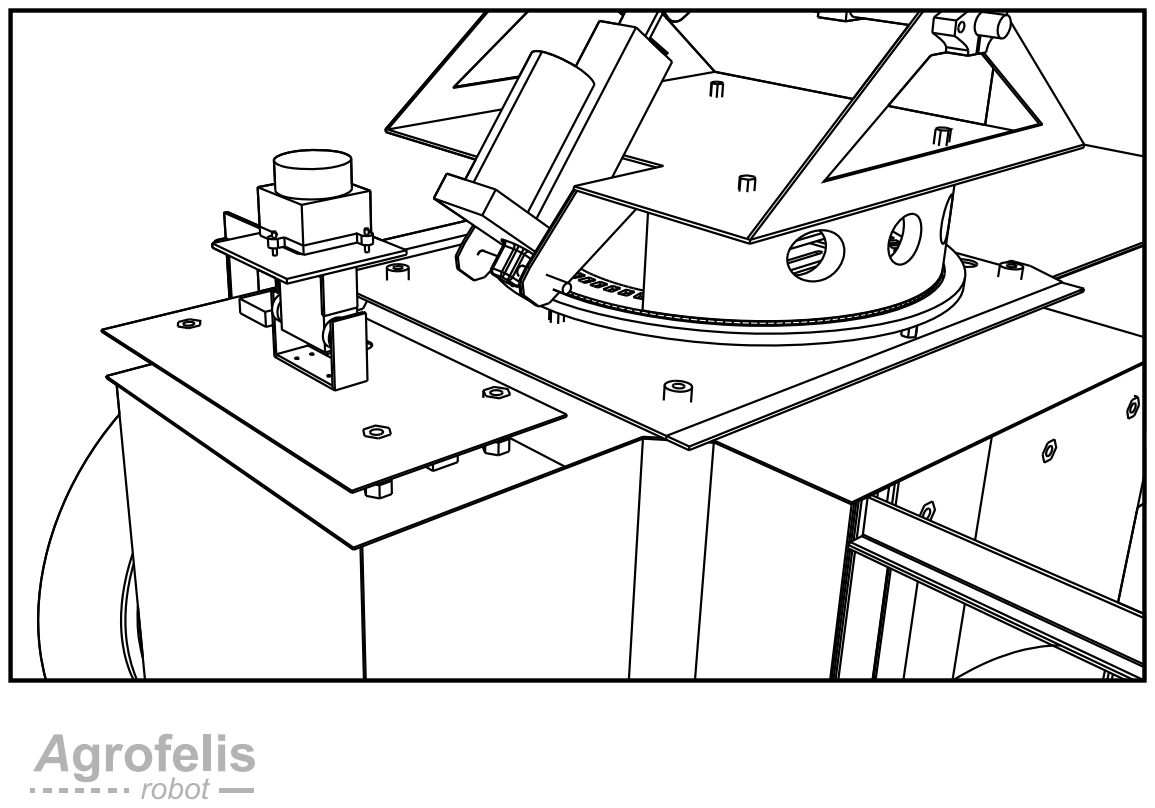
[picture p274: page 1]
