meltoner/agrofelis/components/vehicle-power/_figures/pdf/vehicle-power-04-plexiglass-dimensions.pdf

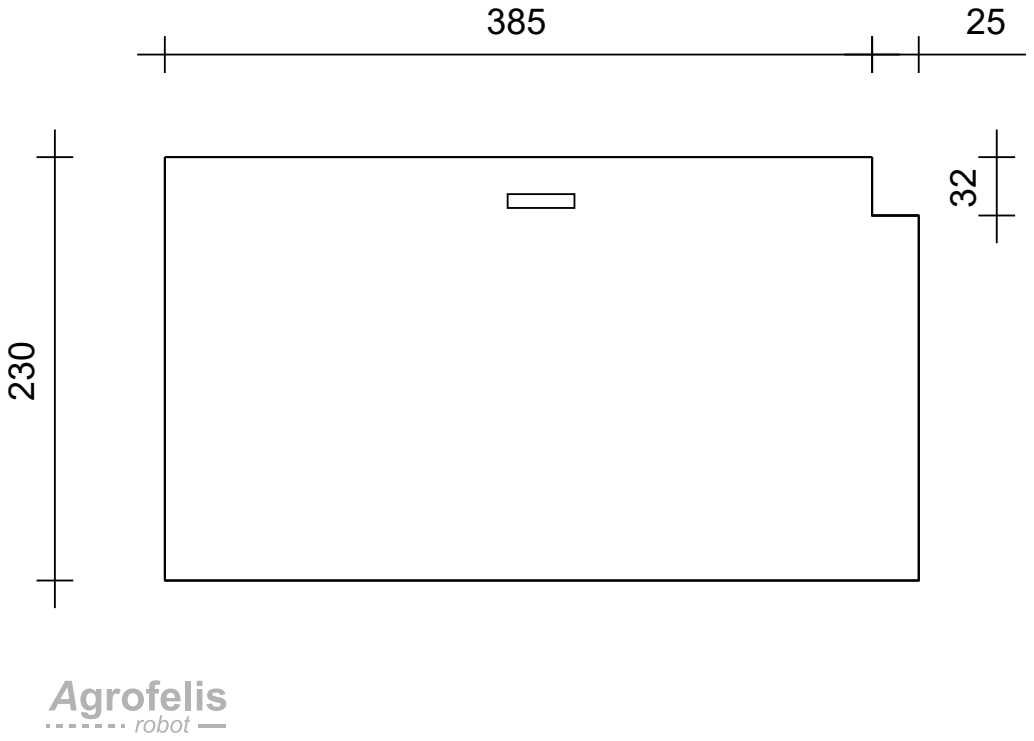
[picture p275: page 1]
