meltoner/agrofelis/components/vehicle-power/_figures/pdf/vehicle-power-00-overview.pdf

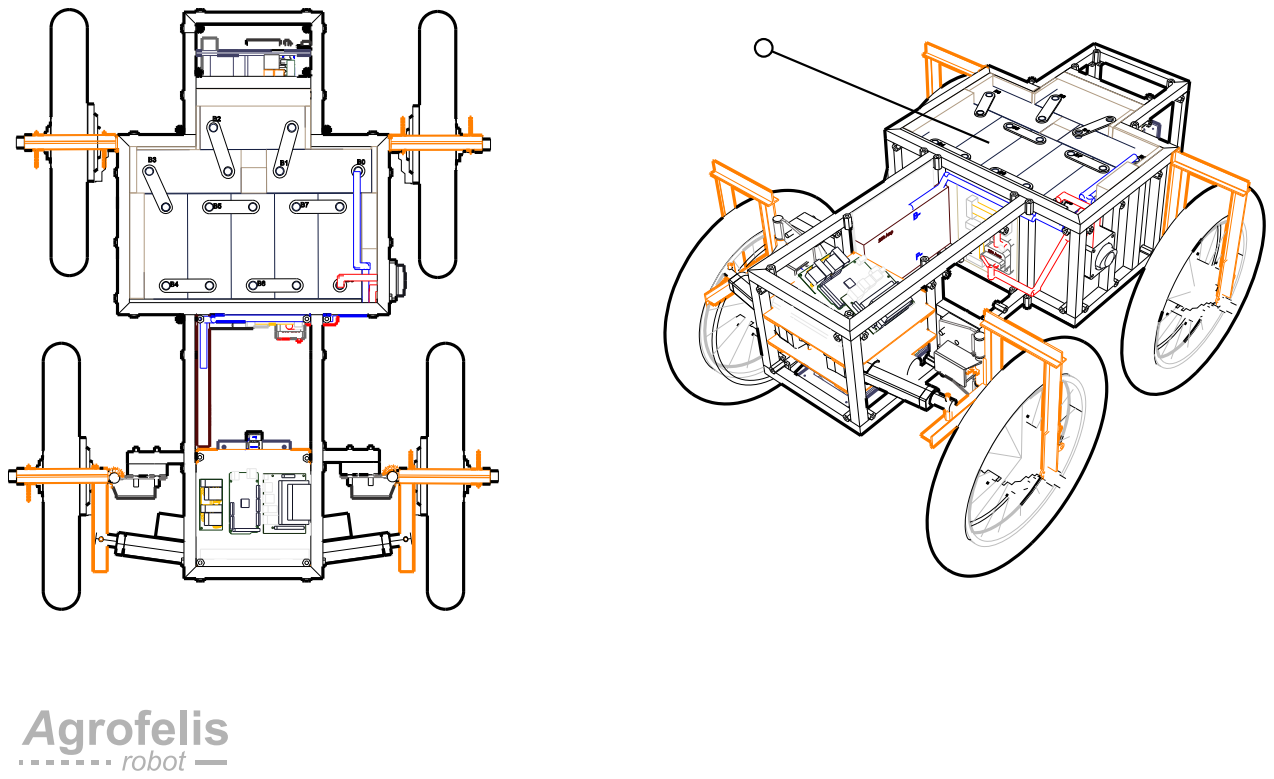
[picture p276: page 1]
