meltoner/agrofelis/components/vehicle-power/_figures/pdf/vehicle-power-01.pdf

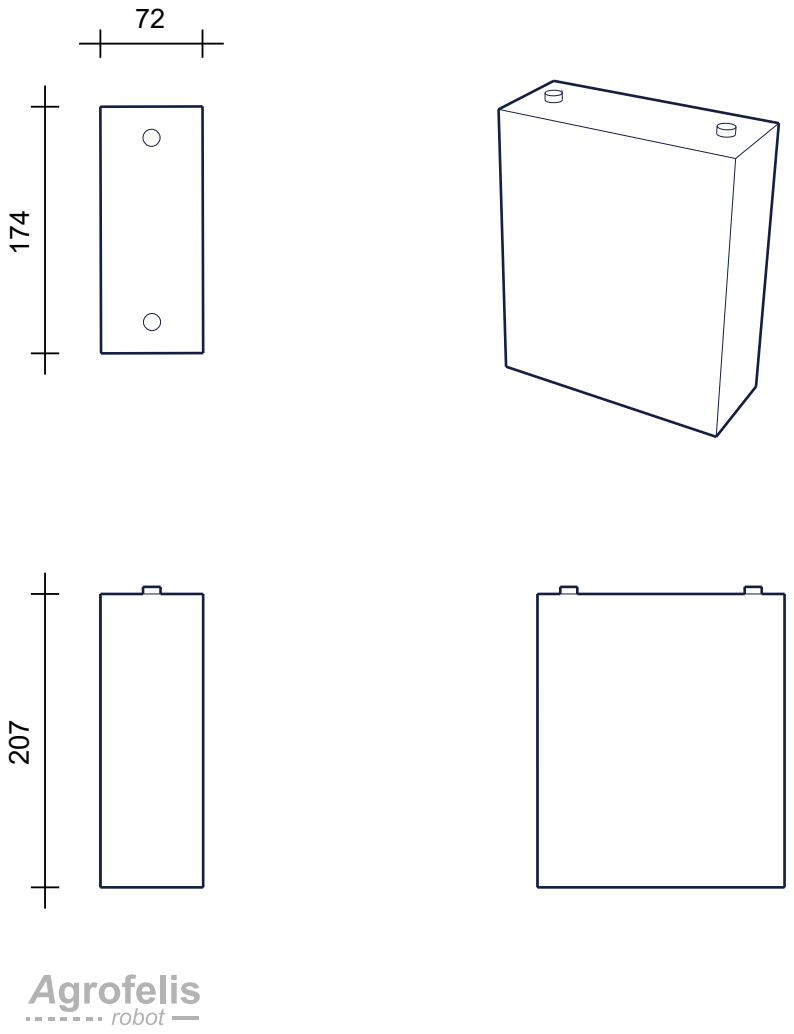
[picture p277: page 1]
