meltoner/agrofelis/components/vehicle-power/_figures/pdf/vehicle-power-02-batteries-arrangment.pdf

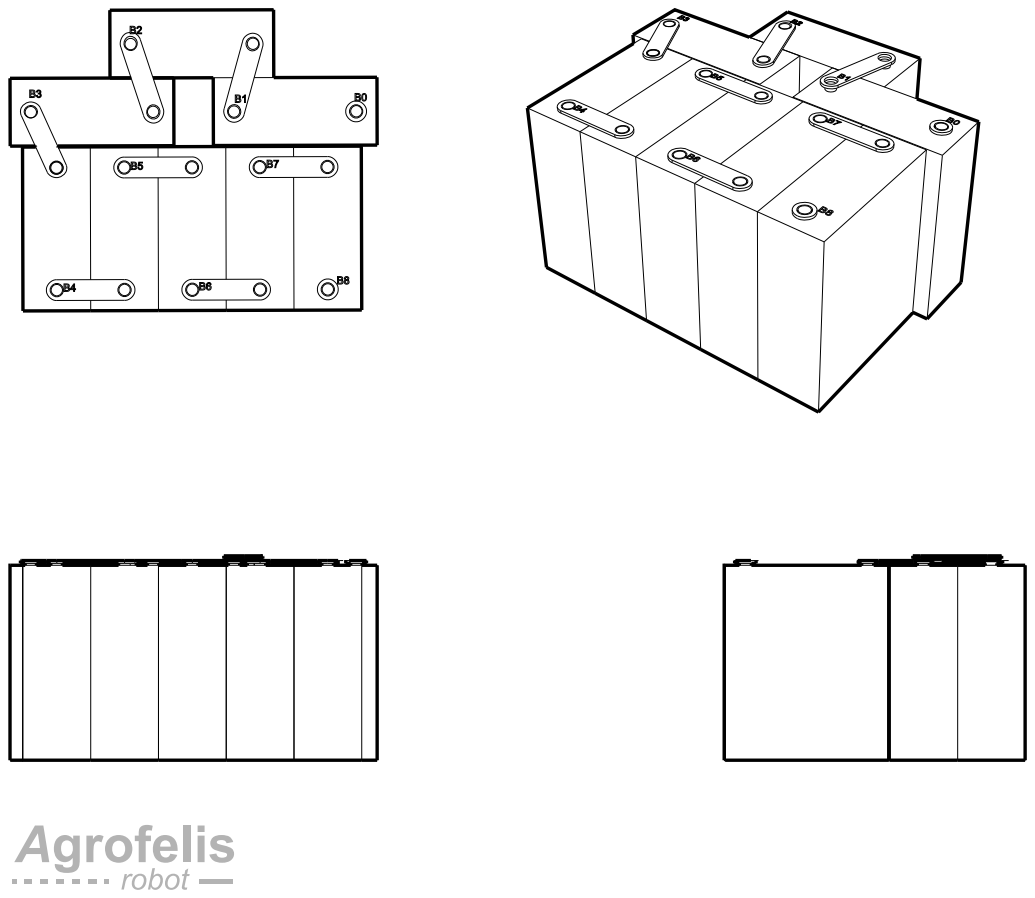
[picture p278: page 1]
