meltoner/agrofelis/components/vehicle-power/_figures/pdf/vehicle-power-03-bateries-wood-covers.pdf

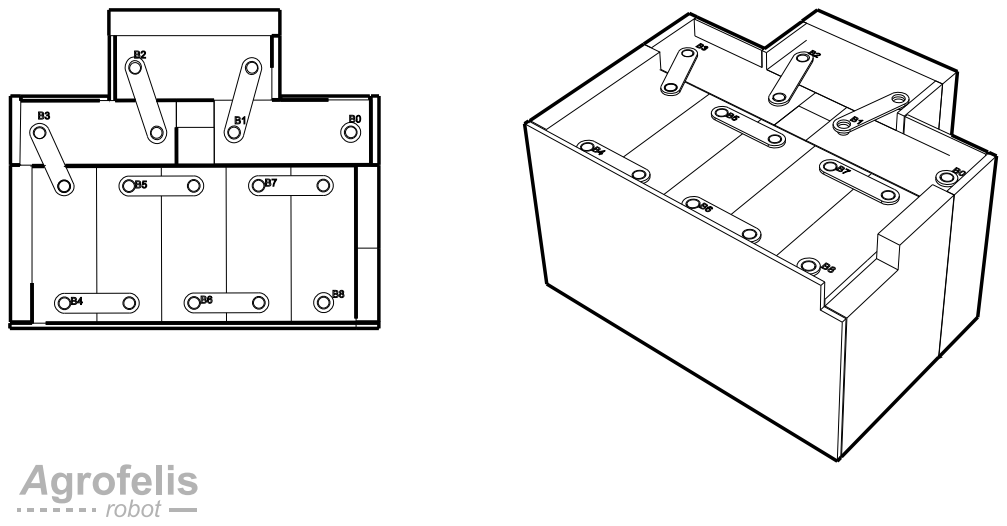
[picture p279: page 1]
