meltoner/agrofelis/components/vehicle-power/_figures/pdf/vehicle-power-04-covers-dimensions.pdf

1 | 2 | 3 | 4 | 5 | 6 | 7 | 8 | 9

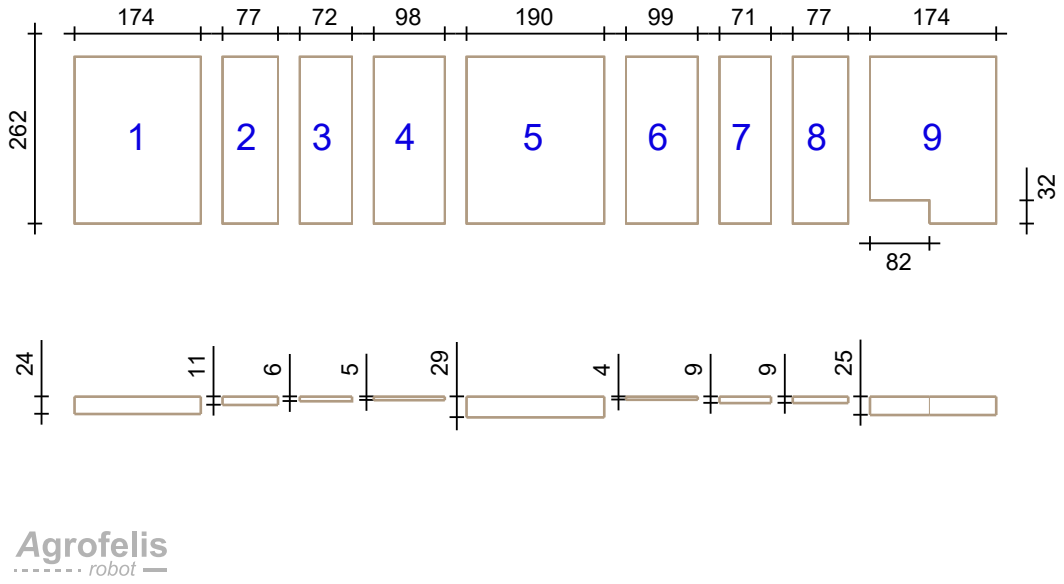
[picture p280: page 1]
