meltoner/agrofelis/components/vehicle-power/_figures/pdf/vehicle-power-04-covers-exploded.pdf

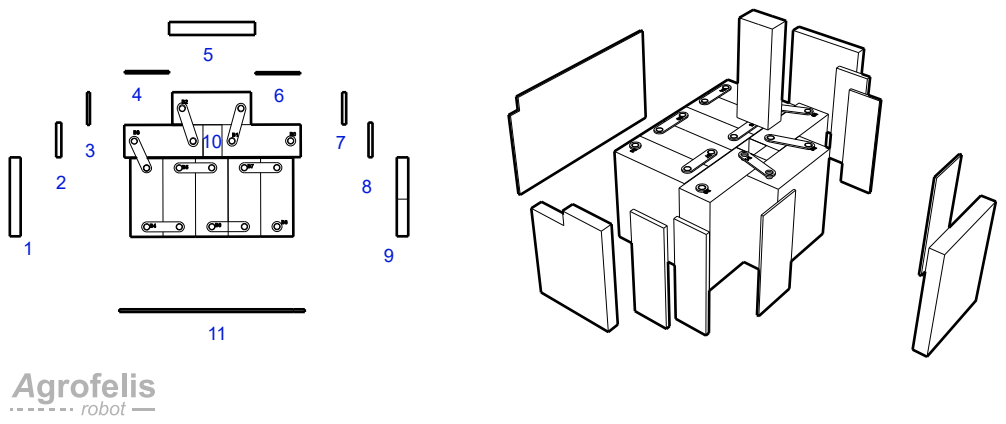
[picture p281: page 1]
