meltoner/agrofelis/components/vehicle-power/_figures/pdf/vehicle-power-06-components.pdf

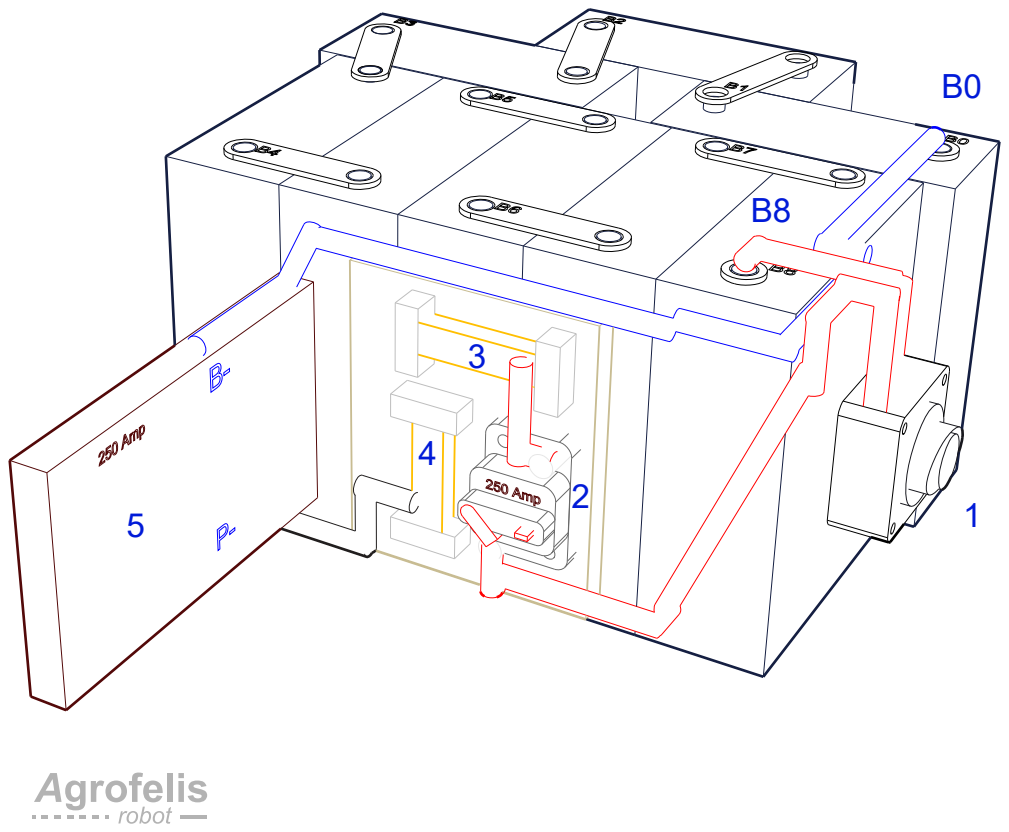
[picture p282: page 1]
