meltoner/agrofelis/components/vehicle-power/_figures/pdf/vehicle-power-07-step-down-converters.pdf

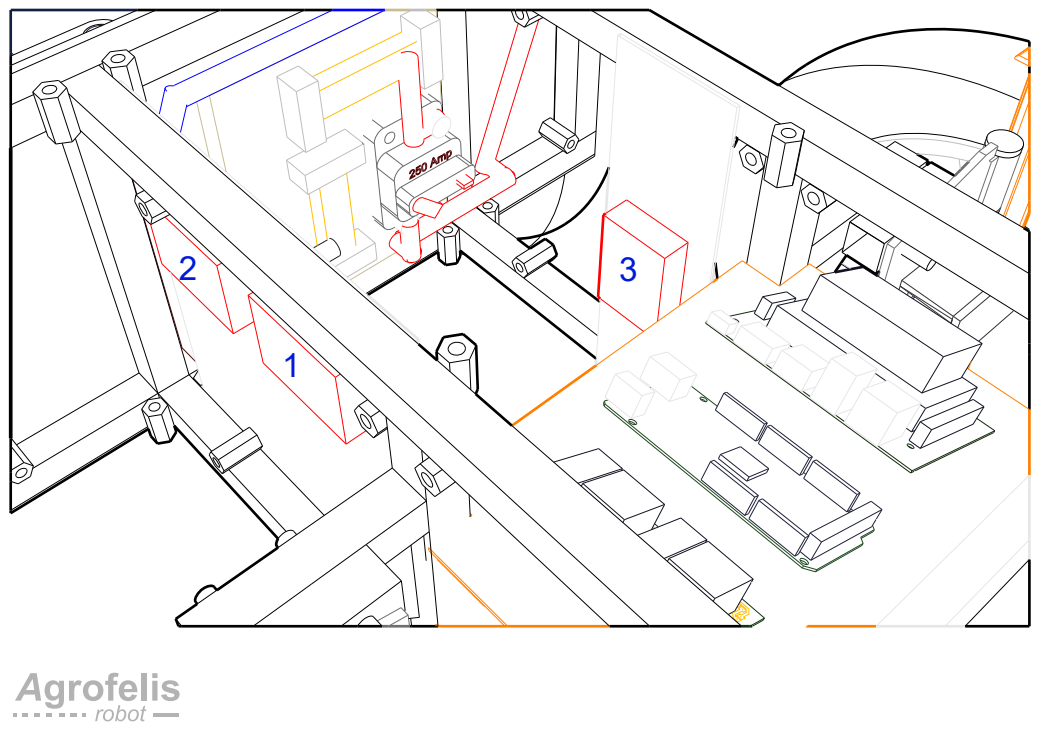
[picture p283: page 1]
