meltoner/agrofelis/components/vehicle-covers/_figures/pdf/03_2mm_covers.pdf

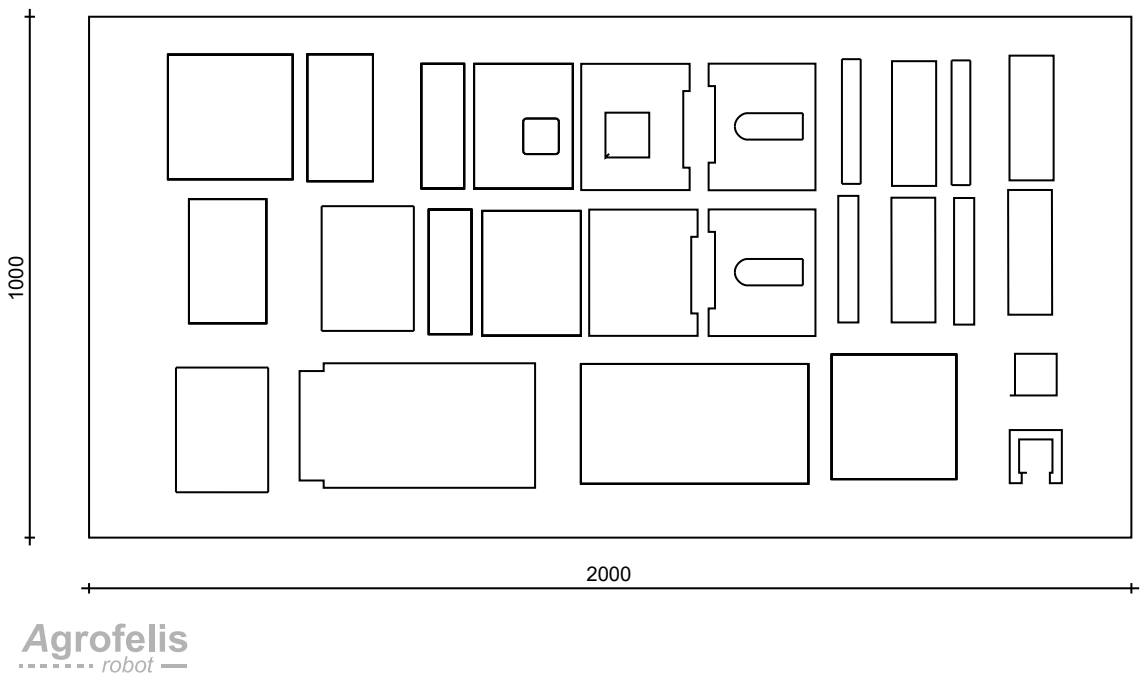
[picture p284: page 1]
