meltoner/agrofelis/components/vehicle-covers/_figures/pdf/01_cover_overview.pdf

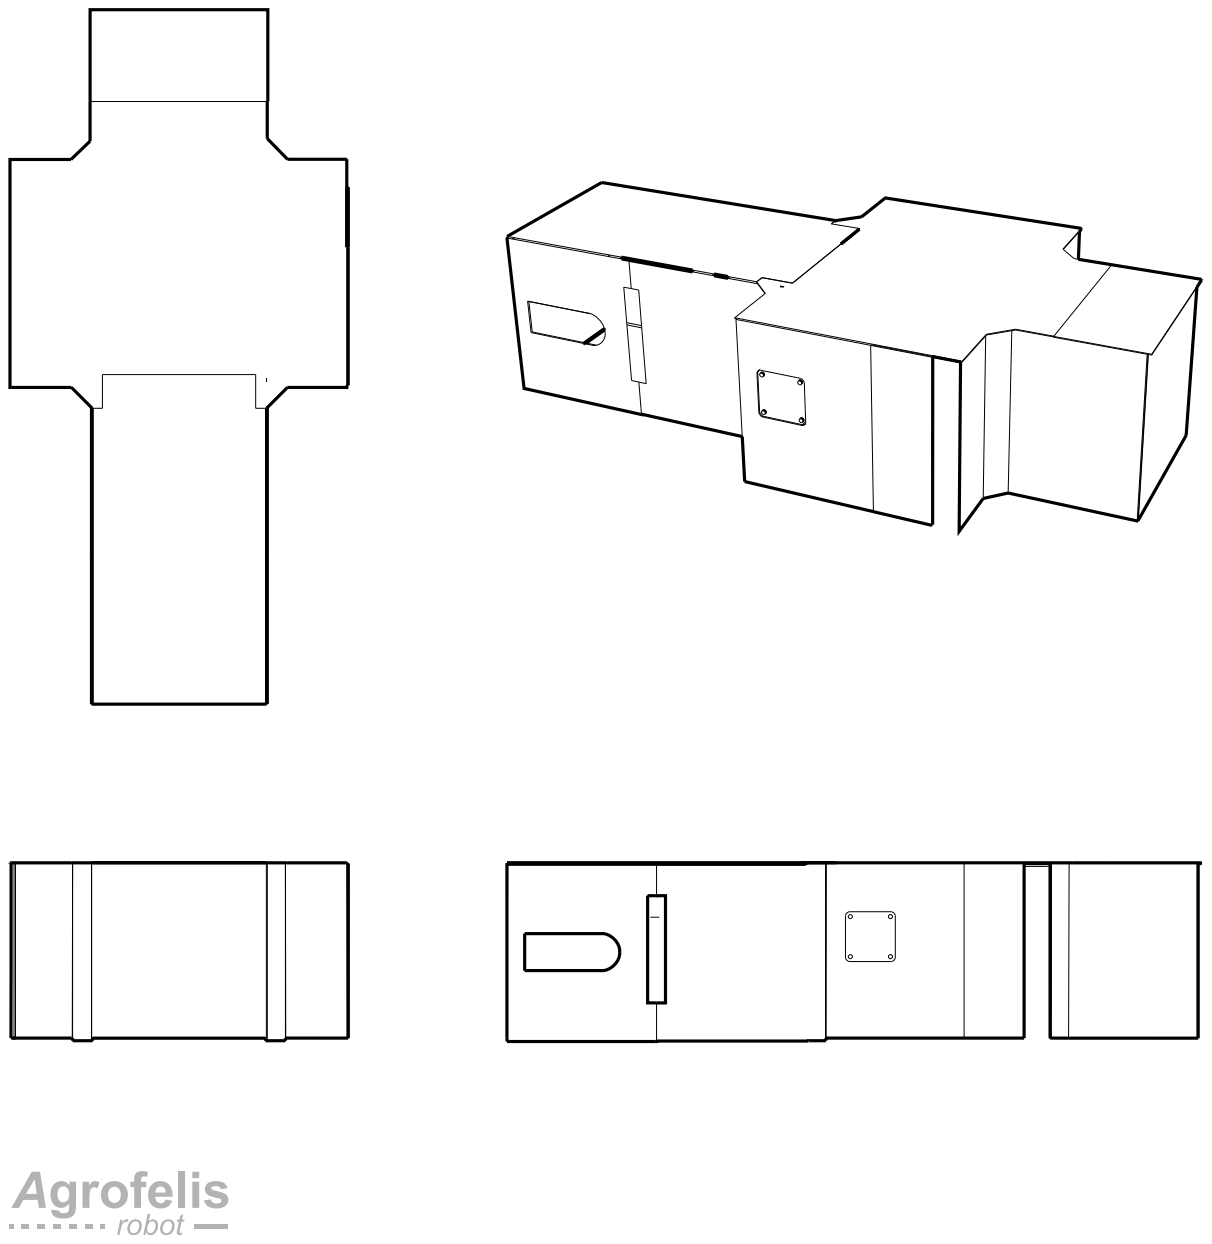
[picture p285: page 1]
