meltoner/agrofelis/components/vehicle-covers/_figures/pdf/02_covers_enumerate.pdf

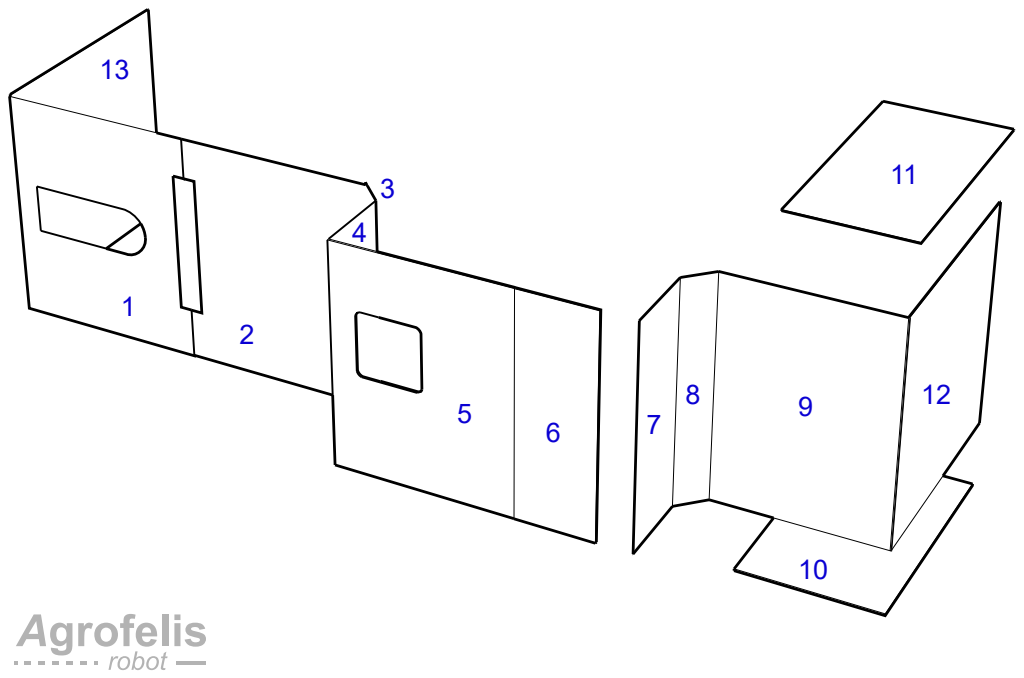
[picture p286: page 1]
