meltoner/agrofelis/components/vehicle-covers/_figures/pdf/04-battery-cover-3mm.pdf

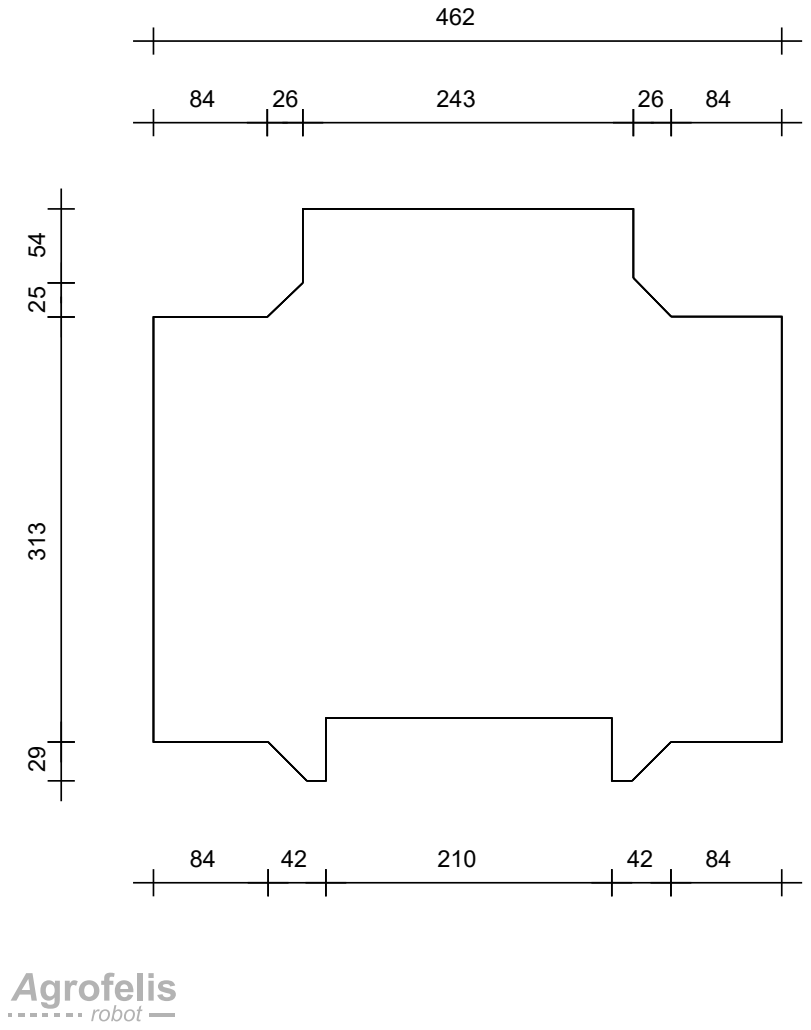
[picture p287: page 1]
