meltoner/agrofelis/components/vehicle-covers/_figures/pdf/05.top-bottom_back_covers.pdf

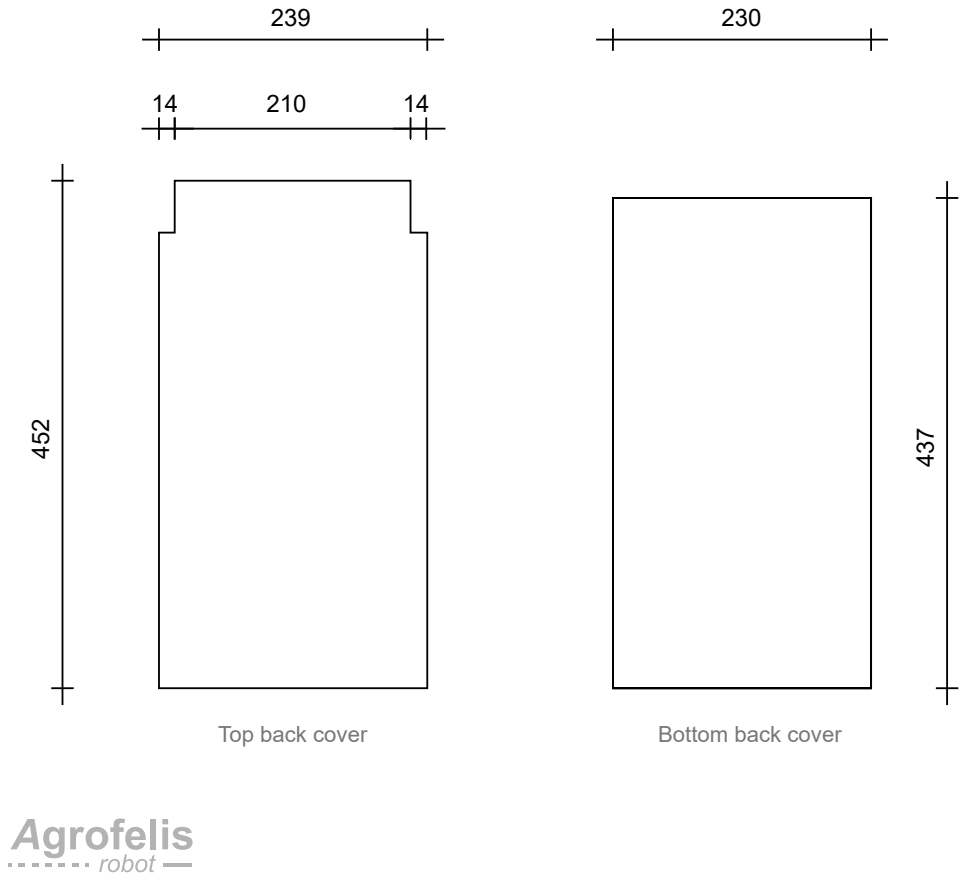
[picture p288: page 1]
Top back cover; Bottom back cover
