meltoner/agrofelis/components/vehicle-covers/_figures/pdf/06.charching-door.pdf

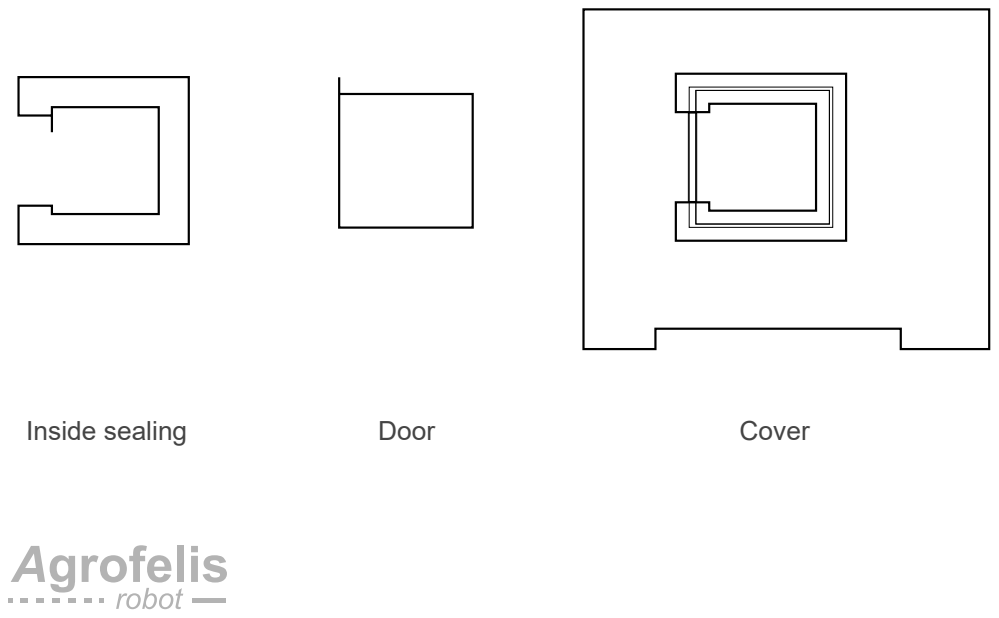
[picture p289: page 1]
Inside sealing; Door; Cover
