meltoner/agrofelis/components/vehicle-steering/_figures/pdf/vehicle-steering-01-steering1.pdf

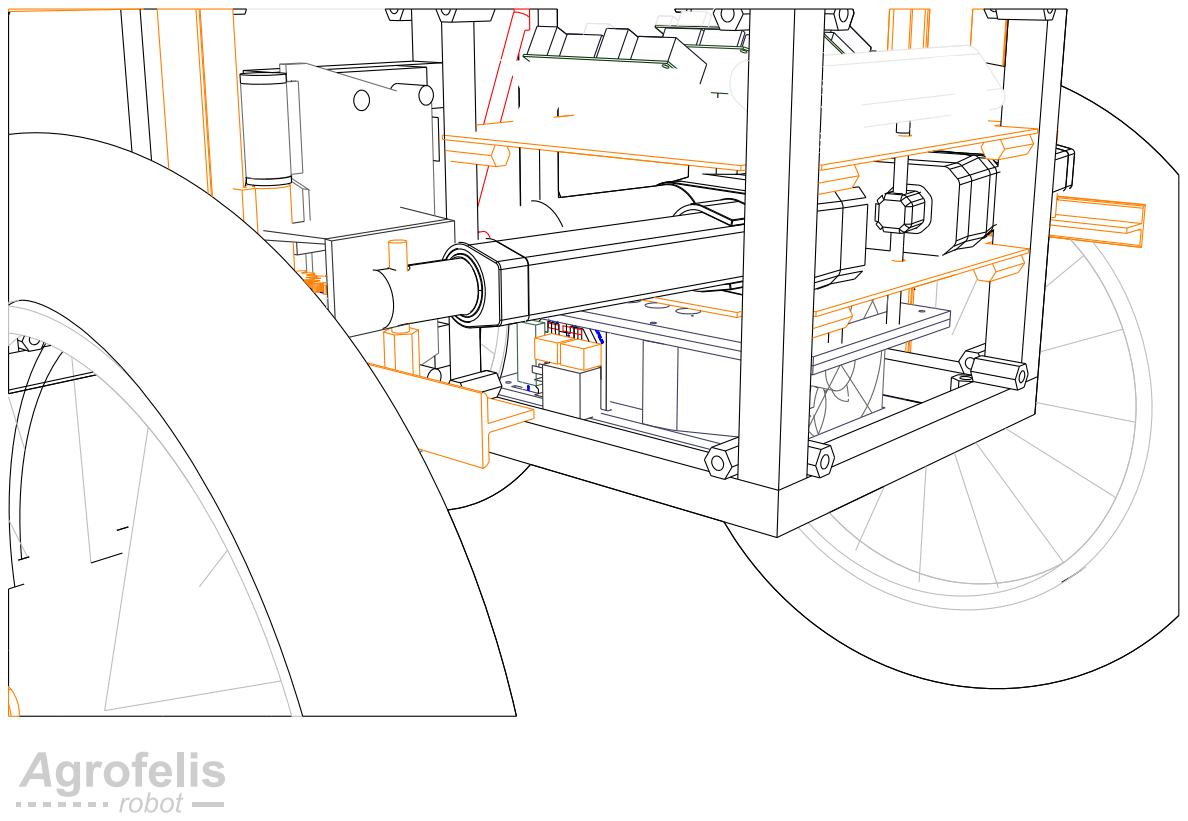
[picture p290: page 1]
