meltoner/agrofelis/components/vehicle-steering/_figures/pdf/vehicle-steering-02-steering2.pdf

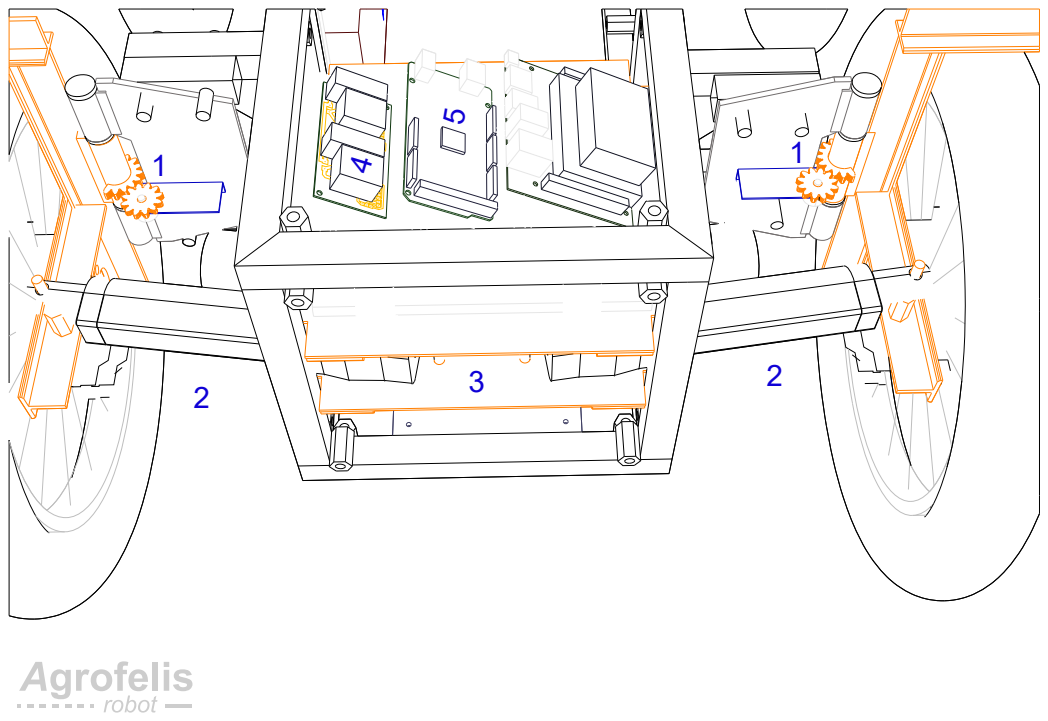
[picture p291: page 1]
