meltoner/agrofelis/components/vehicle-steering/_figures/pdf/vehicle-steering-03-mounting-plates-1.pdf

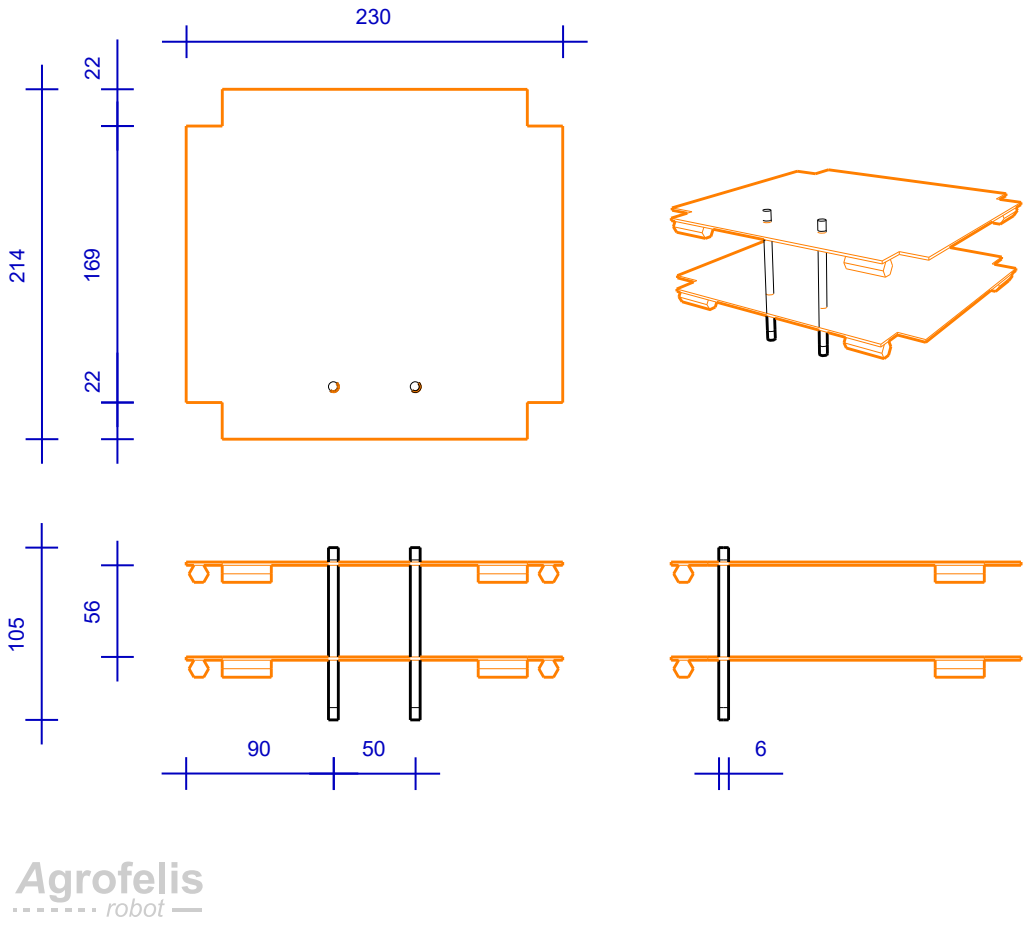
[picture p292: page 1]
