meltoner/agrofelis/components/vehicle-steering/_figures/pdf/vehicle-steering-09-cloth-cover-actuatrors.pdf

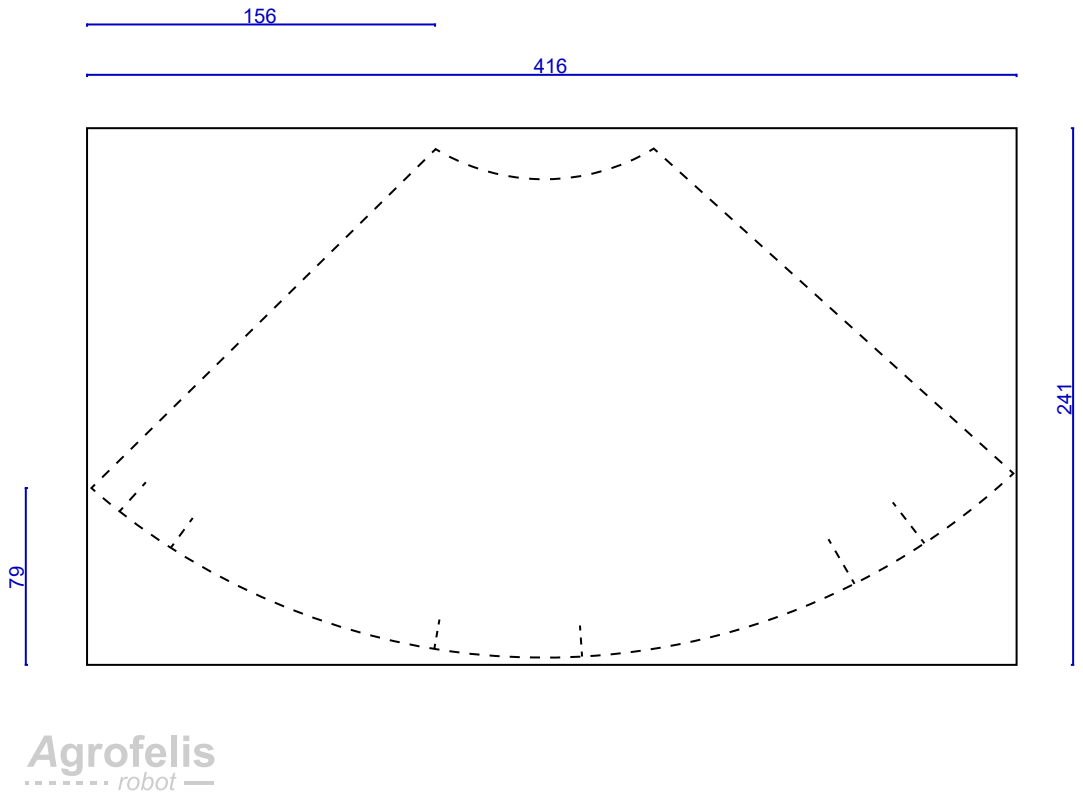
[picture p293: page 1]
