meltoner/agrofelis/components/vehicle-steering/_figures/pdf/vehicle-steering-12-gears.pdf

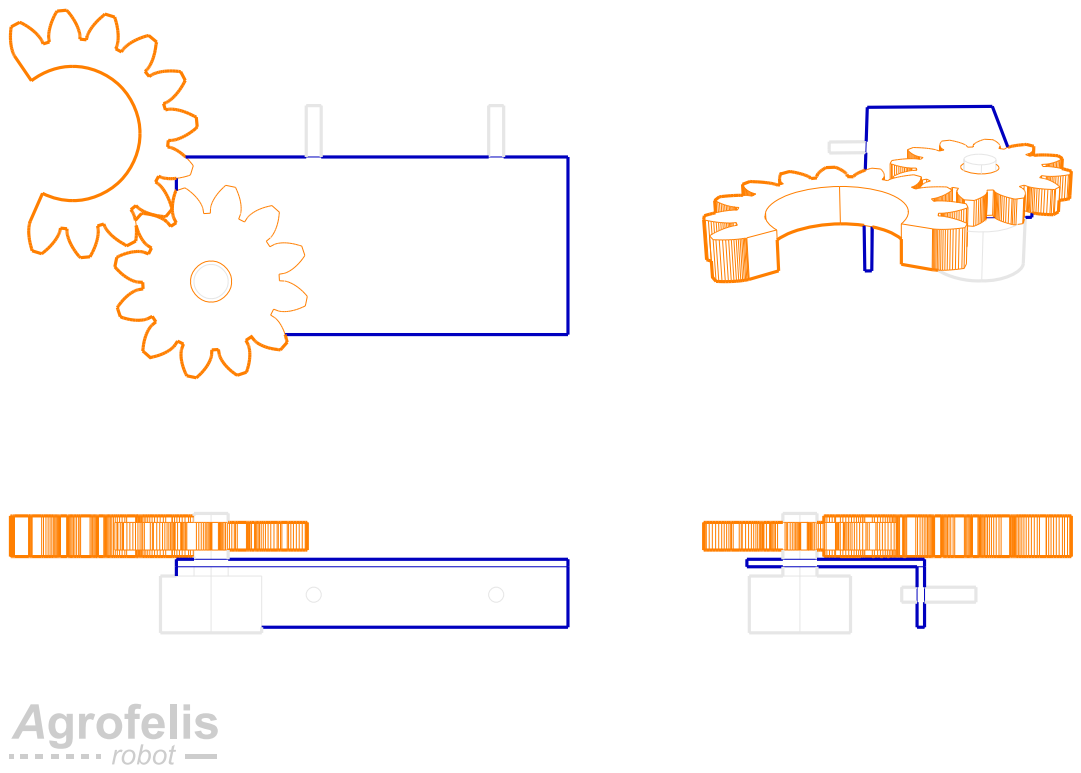
[picture p294: page 1]
