meltoner/agrofelis/components/vehicle-steering/_figures/pdf/vehicle-steering-13.gears-2.pdf

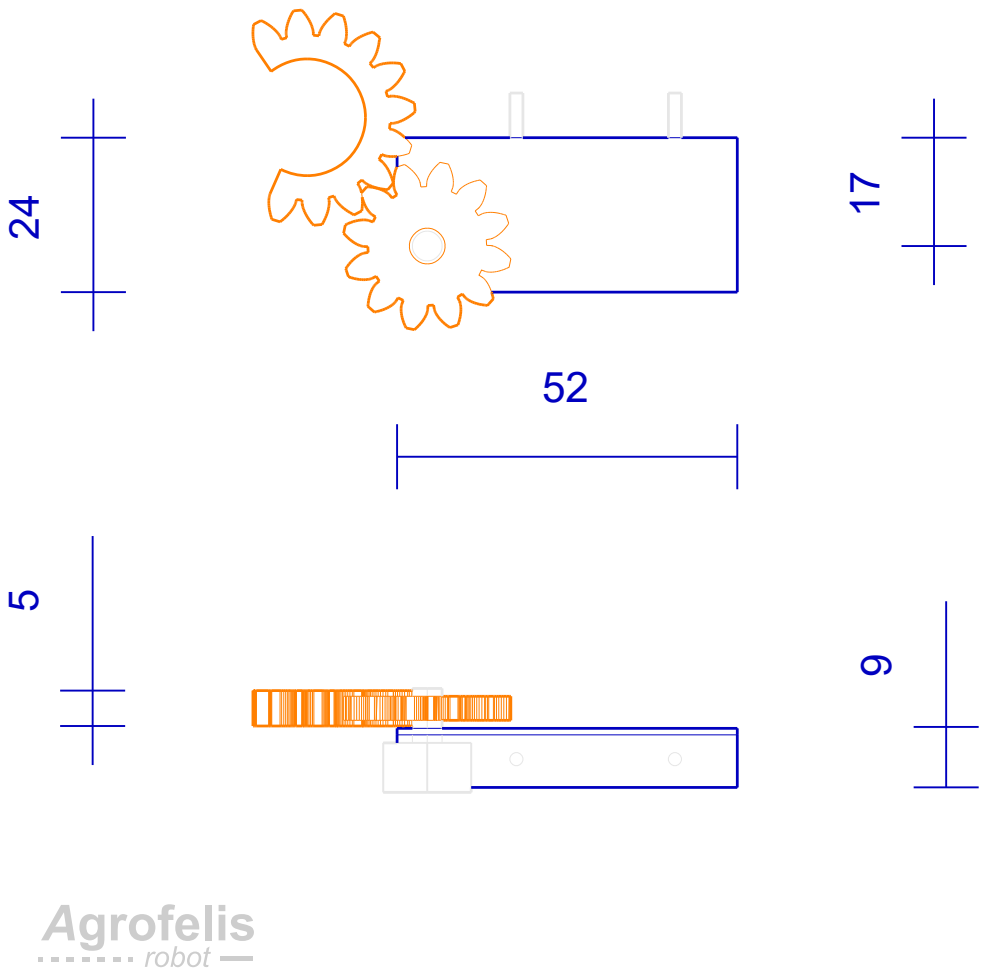
[picture p295: page 1]
