meltoner/agrofelis/components/vehicle-steering/_figures/pdf/vehicle-steering-17-gears-covers.pdf

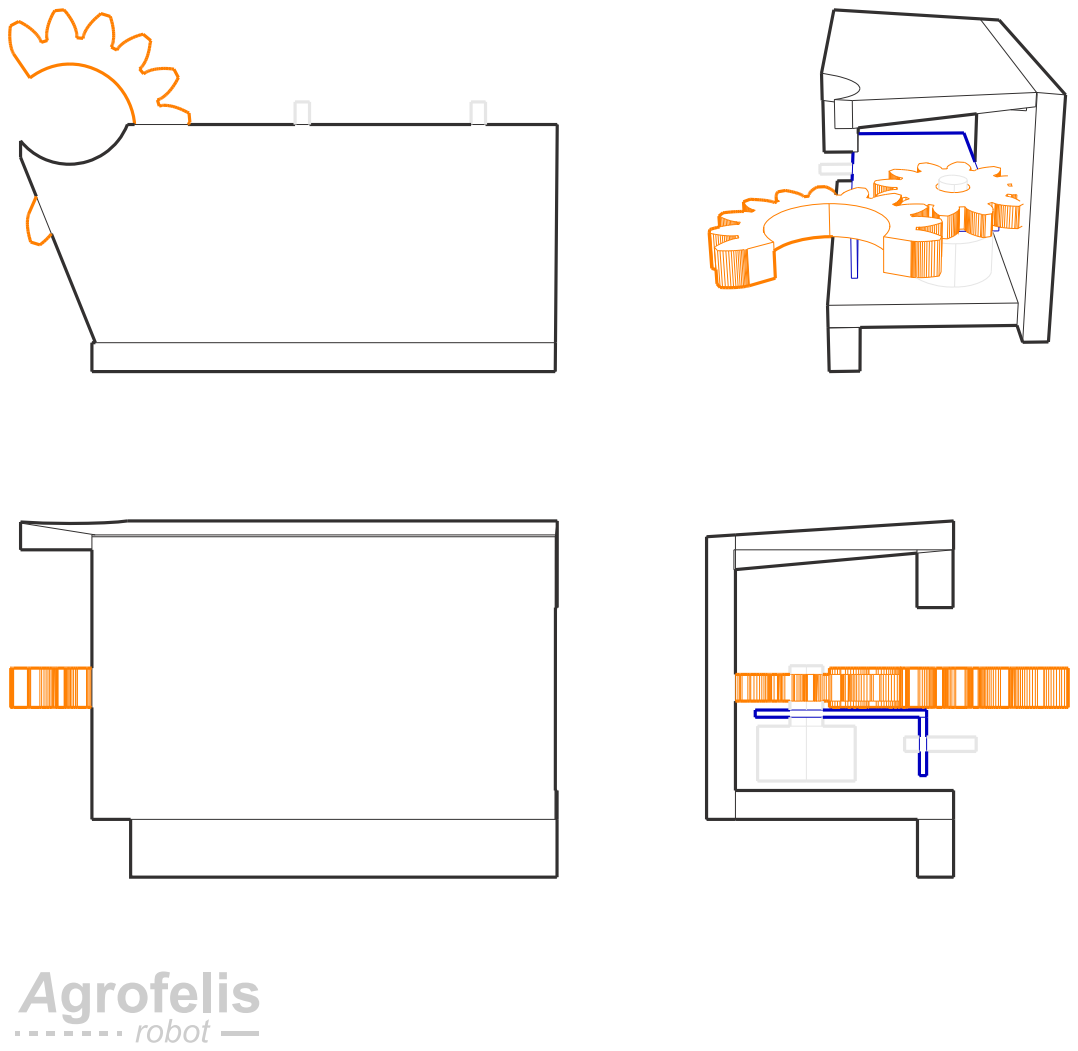
[picture p296: page 1]
