meltoner/agrofelis/components/vehicle-forks/_figures/pdf/vehicle-forks-05-front-fork-exploded.pdf

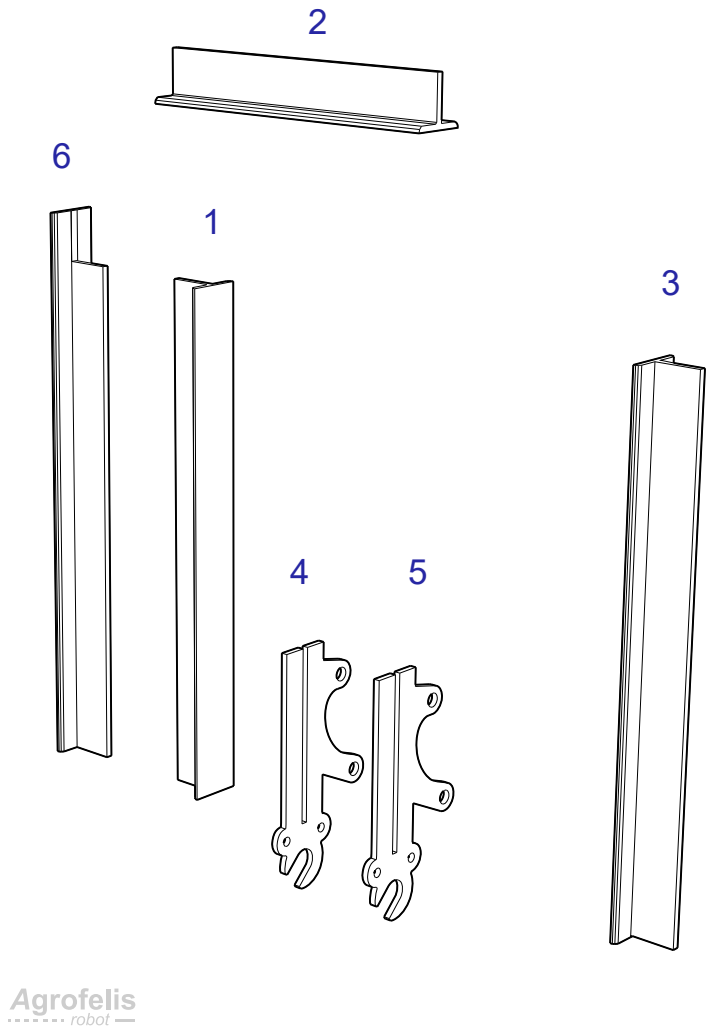
[picture p297: page 1]
