meltoner/agrofelis/components/vehicle-forks/_figures/pdf/vehicle-forks-06-drop-out.pdf

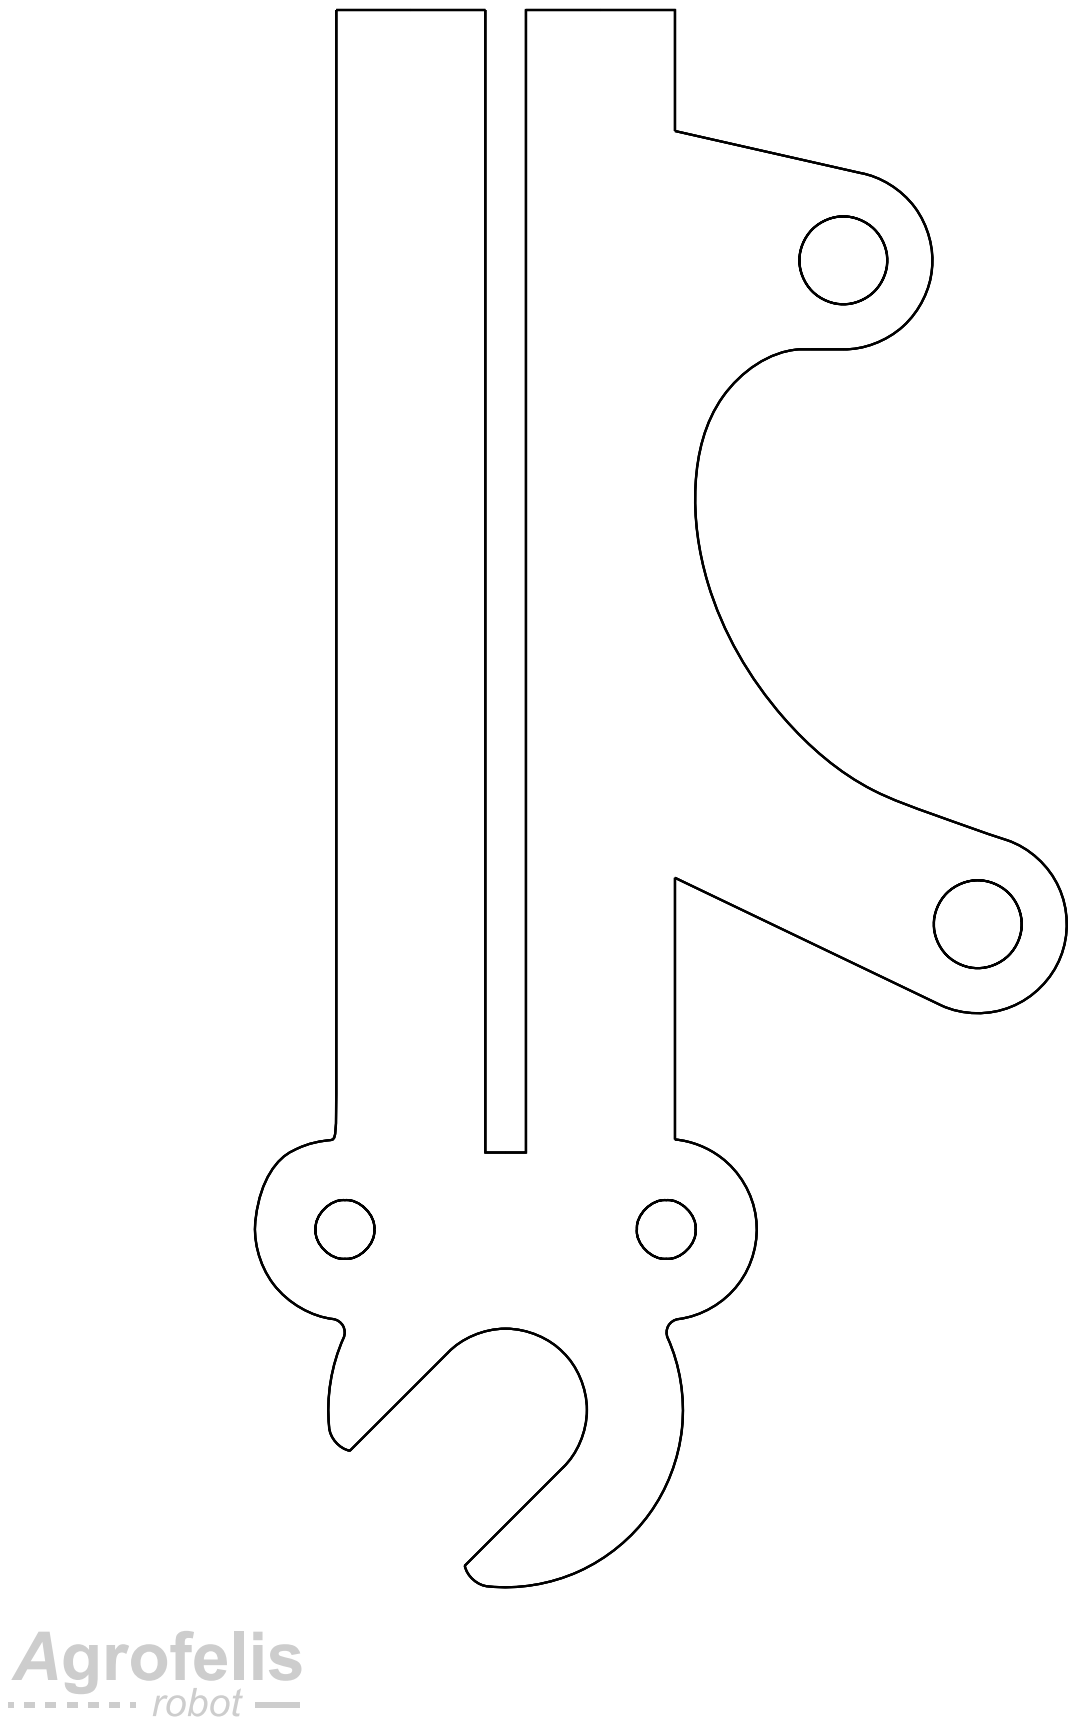
[picture p298: page 1]
