meltoner/agrofelis/components/vehicle-forks/_figures/pdf/vehicle-forks-09-back-fork-lever.pdf

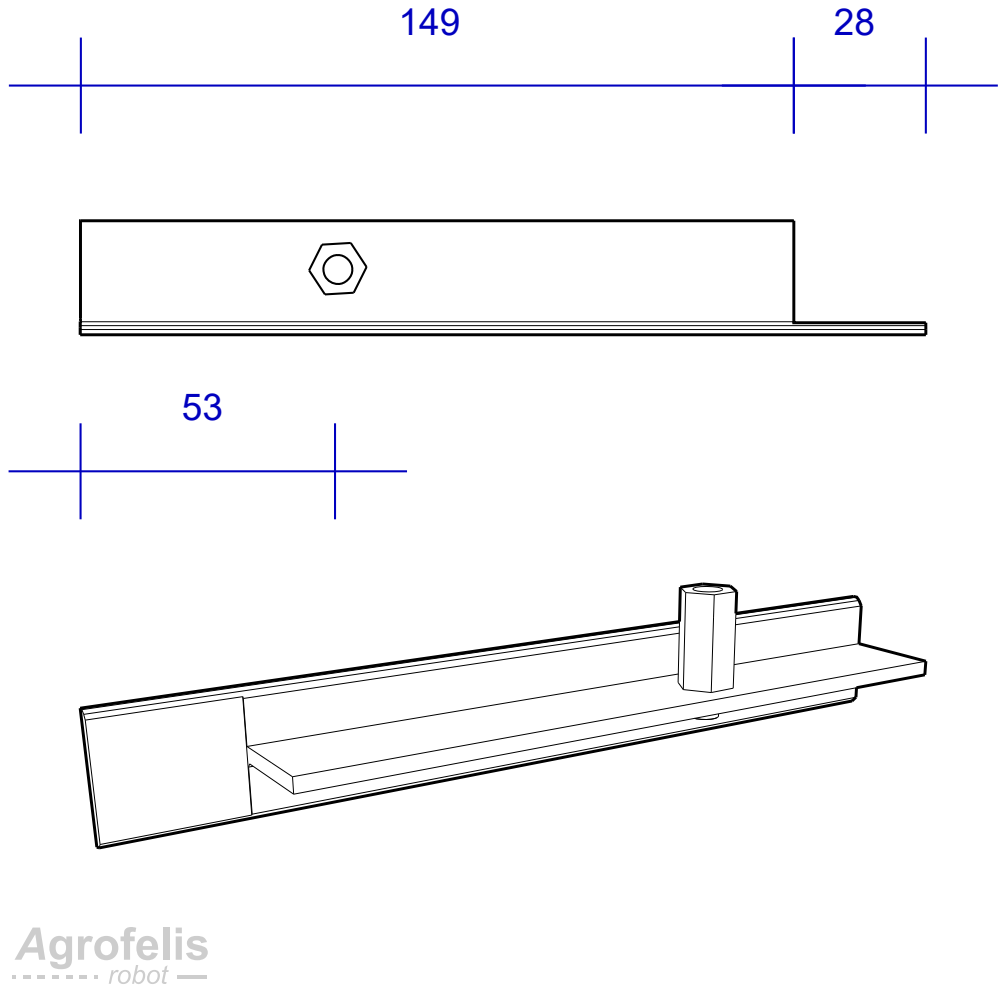
[picture p299: page 1]
