meltoner/agrofelis/components/vehicle-forks/_figures/pdf/vehicle-forks-10-hinge-mount.pdf

17

75

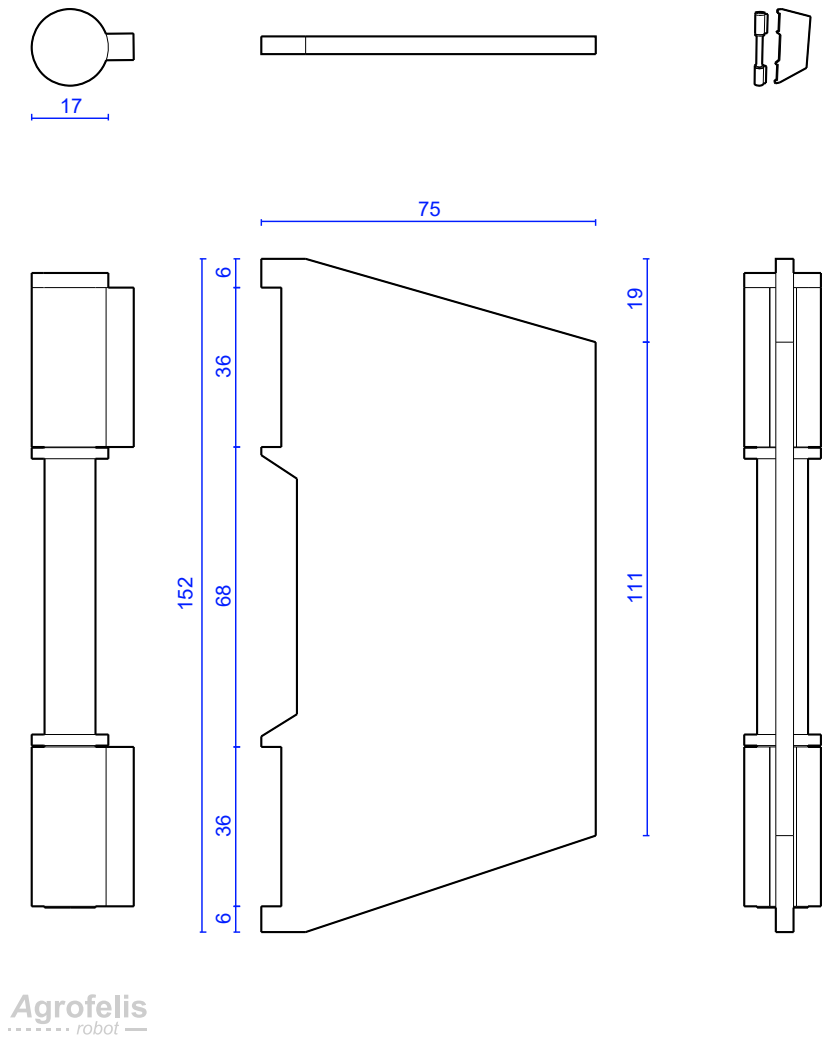
[picture p300: page 1]
