meltoner/agrofelis/components/vehicle-forks/_figures/pdf/vehicle-forks-01-wheel-forks.pdf

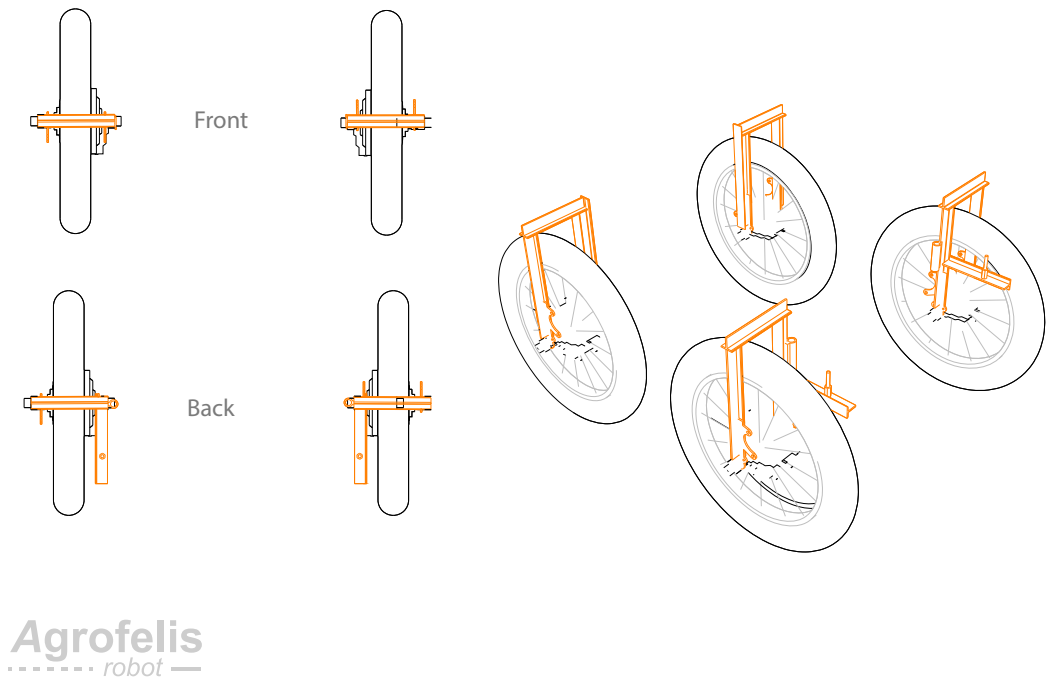
[picture p301: page 1]
Front; Back
