meltoner/agrofelis/components/vehicle-forks/_figures/pdf/vehicle-forks-02-forks.pdf

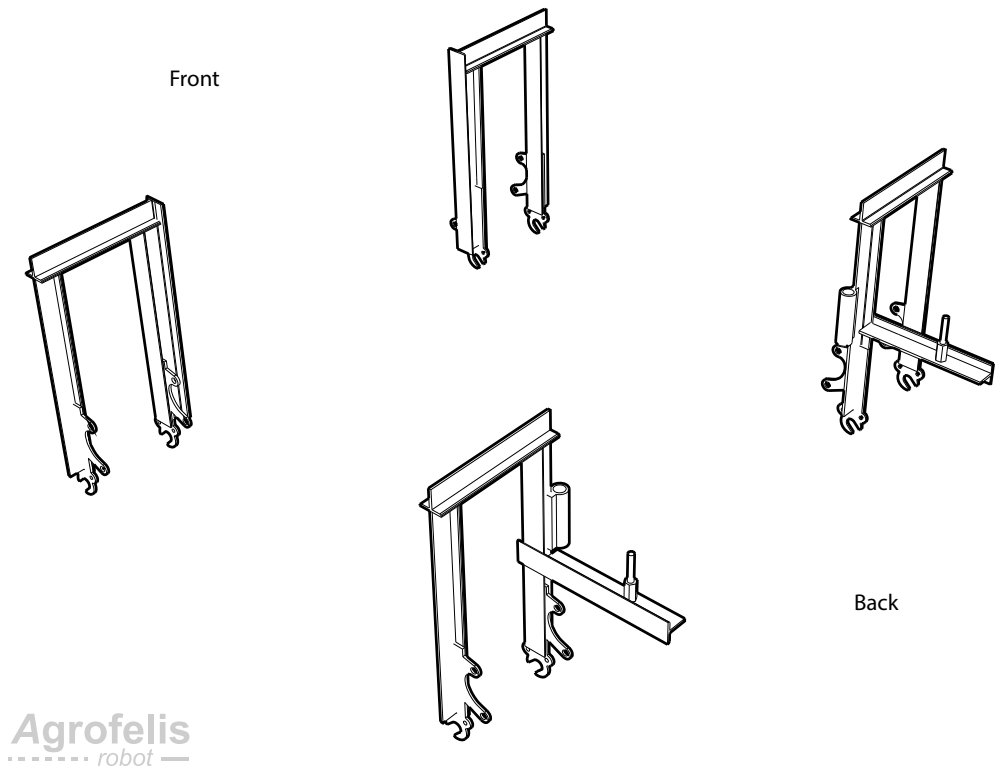
[picture p302: page 1]
Front; Back
