meltoner/agrofelis/components/vehicle-forks/_figures/pdf/vehicle-forks-03-forks-side.pdf

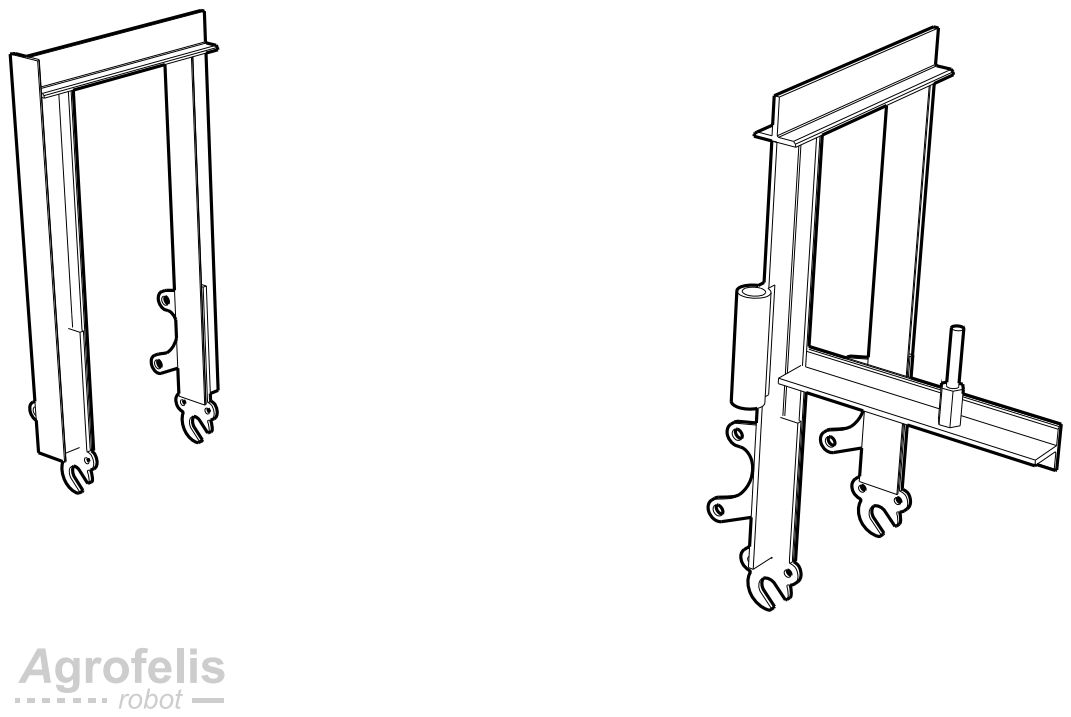
[picture p303: page 1]
