meltoner/agrofelis/components/vehicle-forks/_figures/pdf/vehicle-forks-03-front-fork-dimensions.pdf

25

153

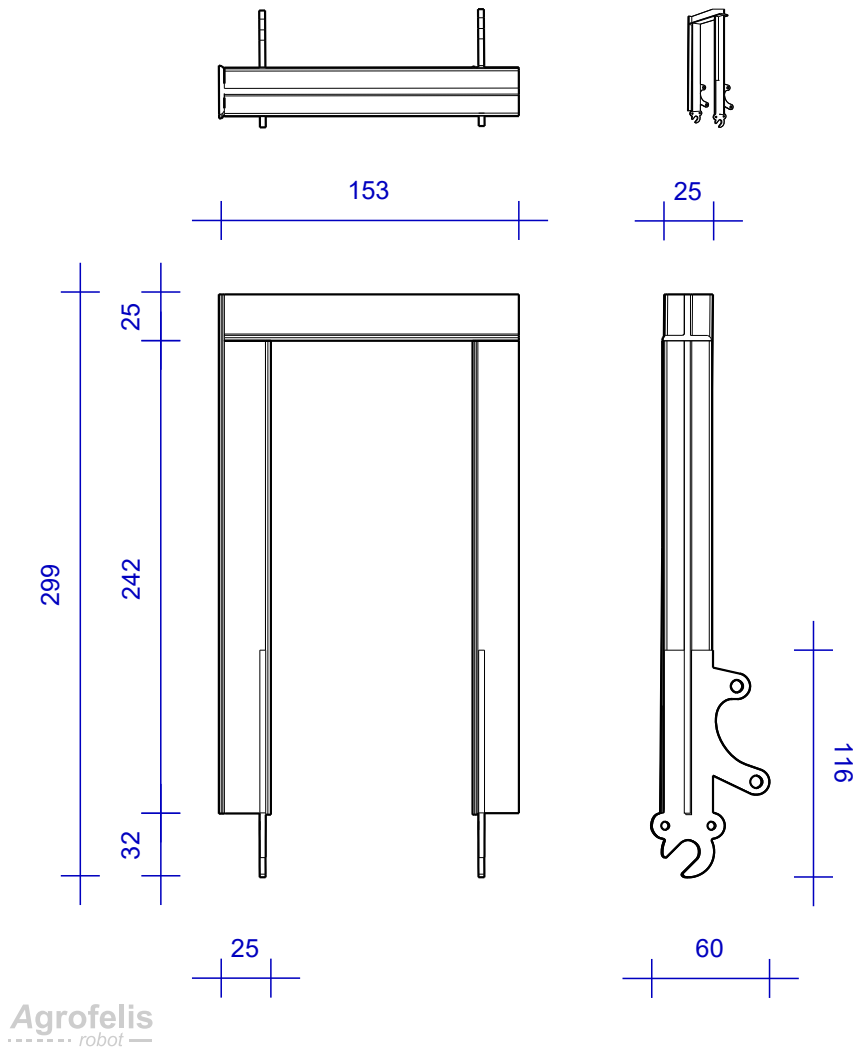
[picture p304: page 1]
