meltoner/agrofelis/components/vehicle-forks/_figures/pdf/vehicle-forks-04-front-fork-components.pdf

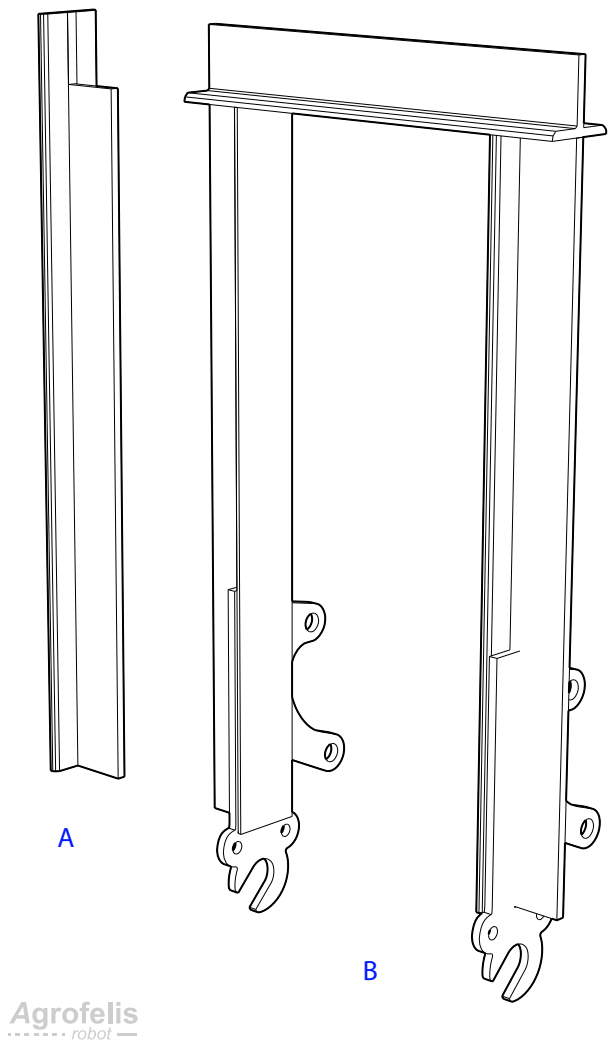
[picture p305: page 1]
