meltoner/agrofelis/components/vehicle-forks/_figures/pdf/vehicle-forks-07-back-fork-dimensions.pdf

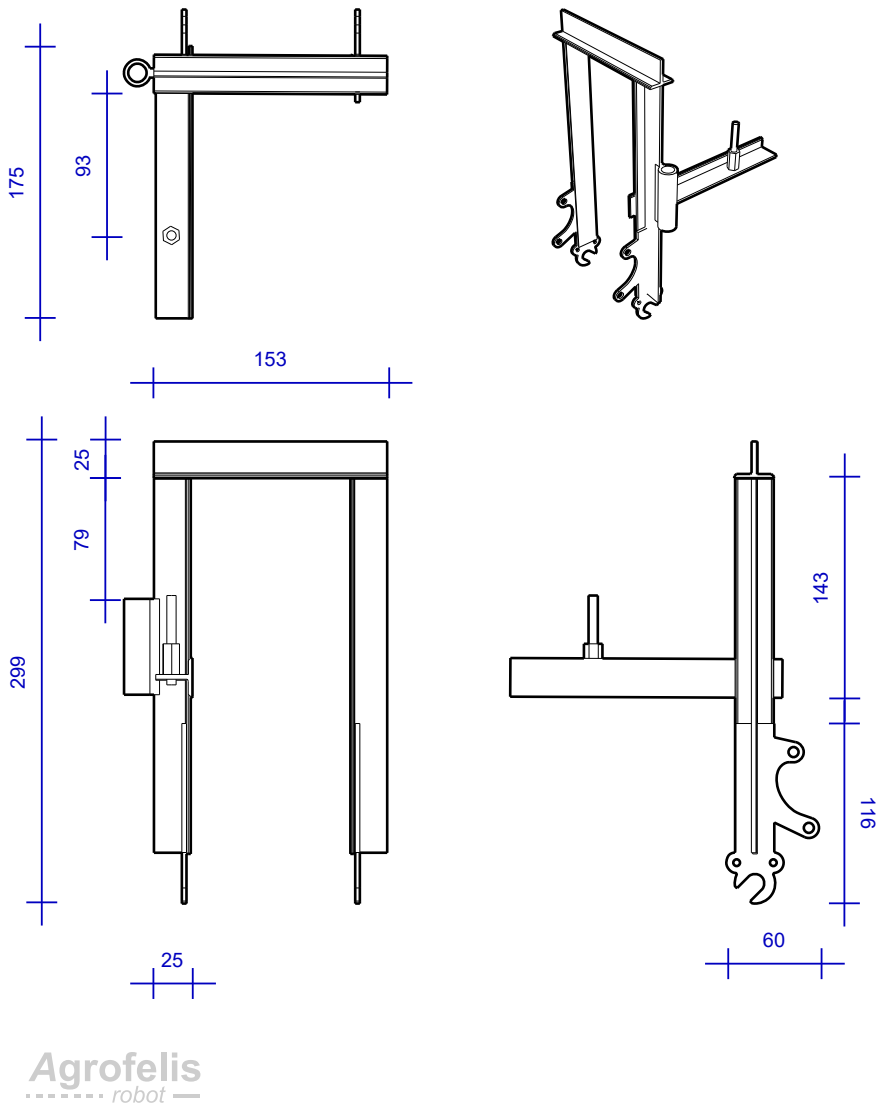
[picture p306: page 1]
