meltoner/agrofelis/components/vehicle-forks/_figures/pdf/vehicle-forks-08-back-fork-exploded.pdf

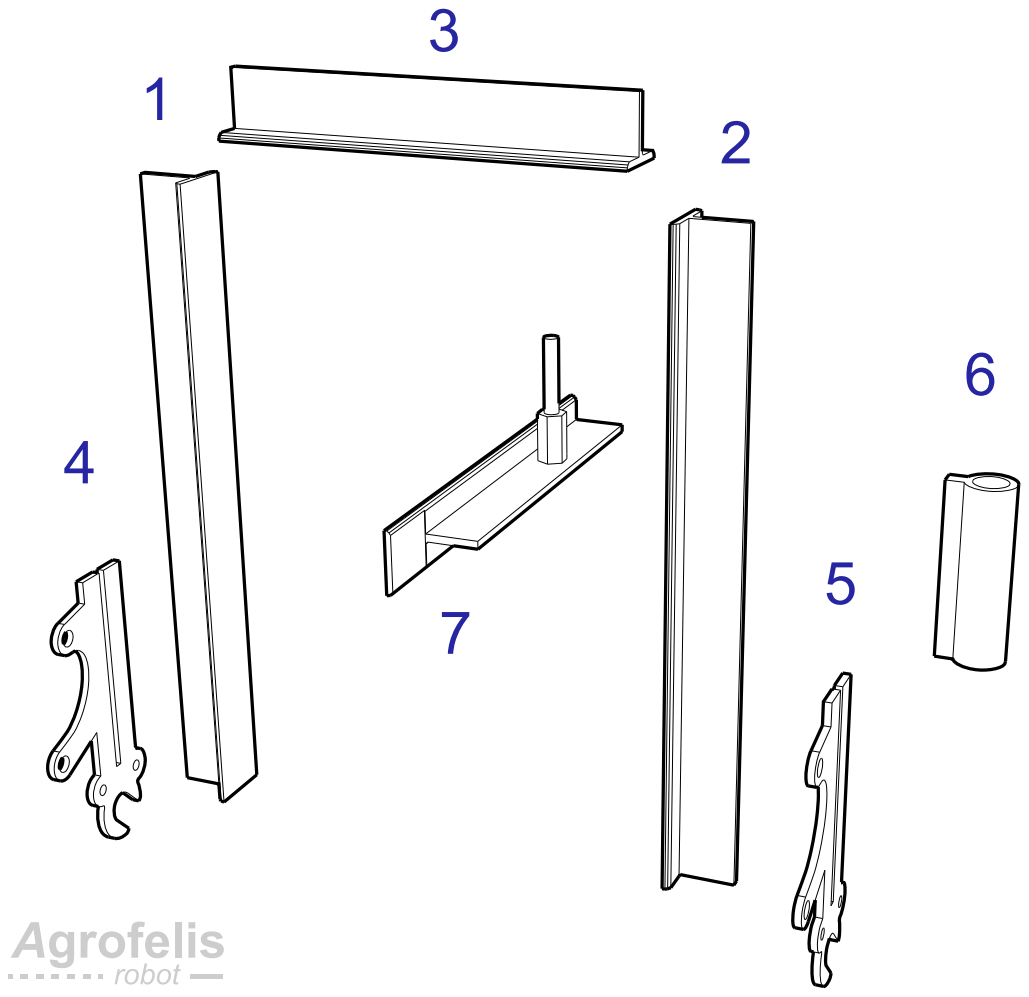
[picture p307: page 1]
