meltoner/agrofelis/components/vehicle-wheels/_figures/pdf/vehicle-wheels-04.pdf

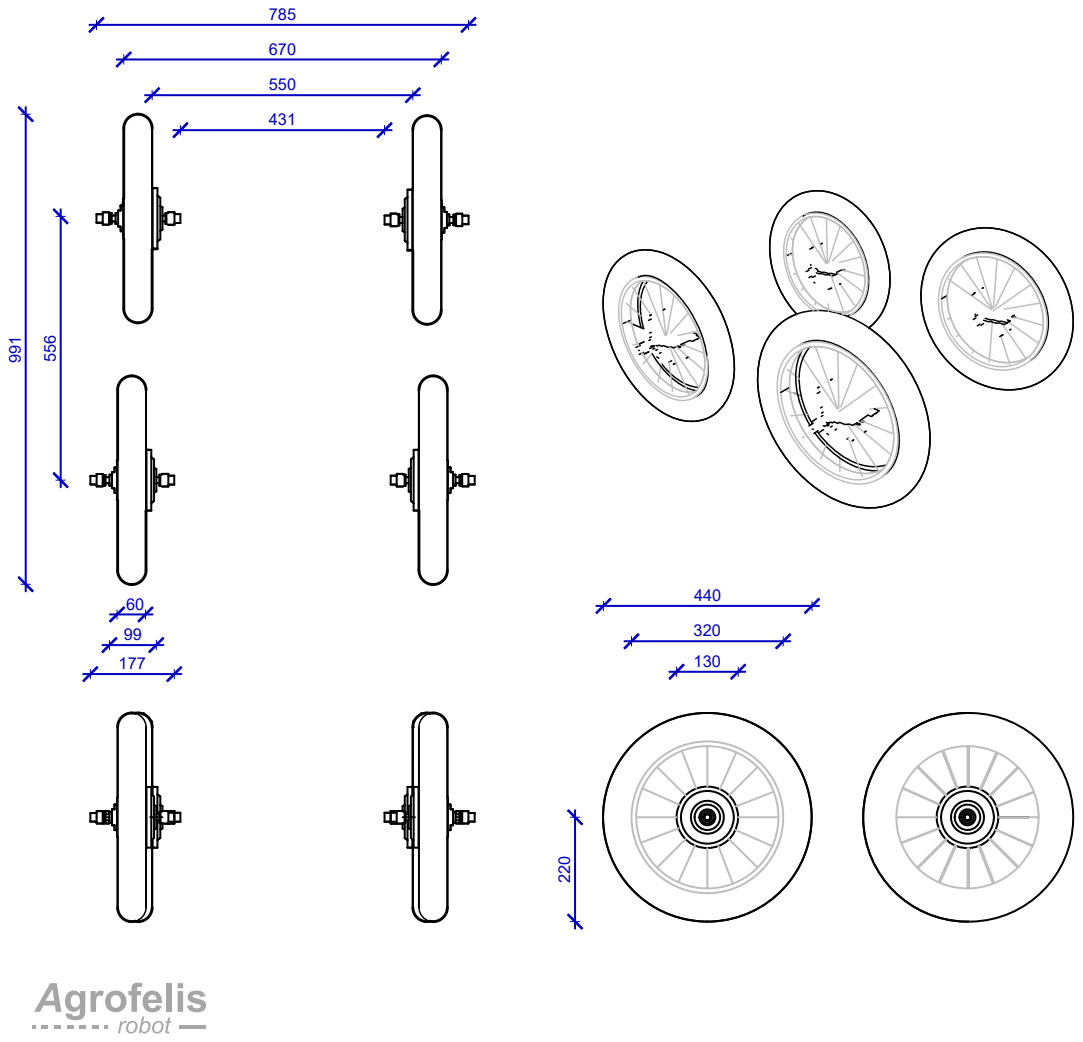
[picture p308: page 1]
