meltoner/agrofelis/components/vehicle-frame/_figures/pdf/vehicle-frame-01-3dview.pdf

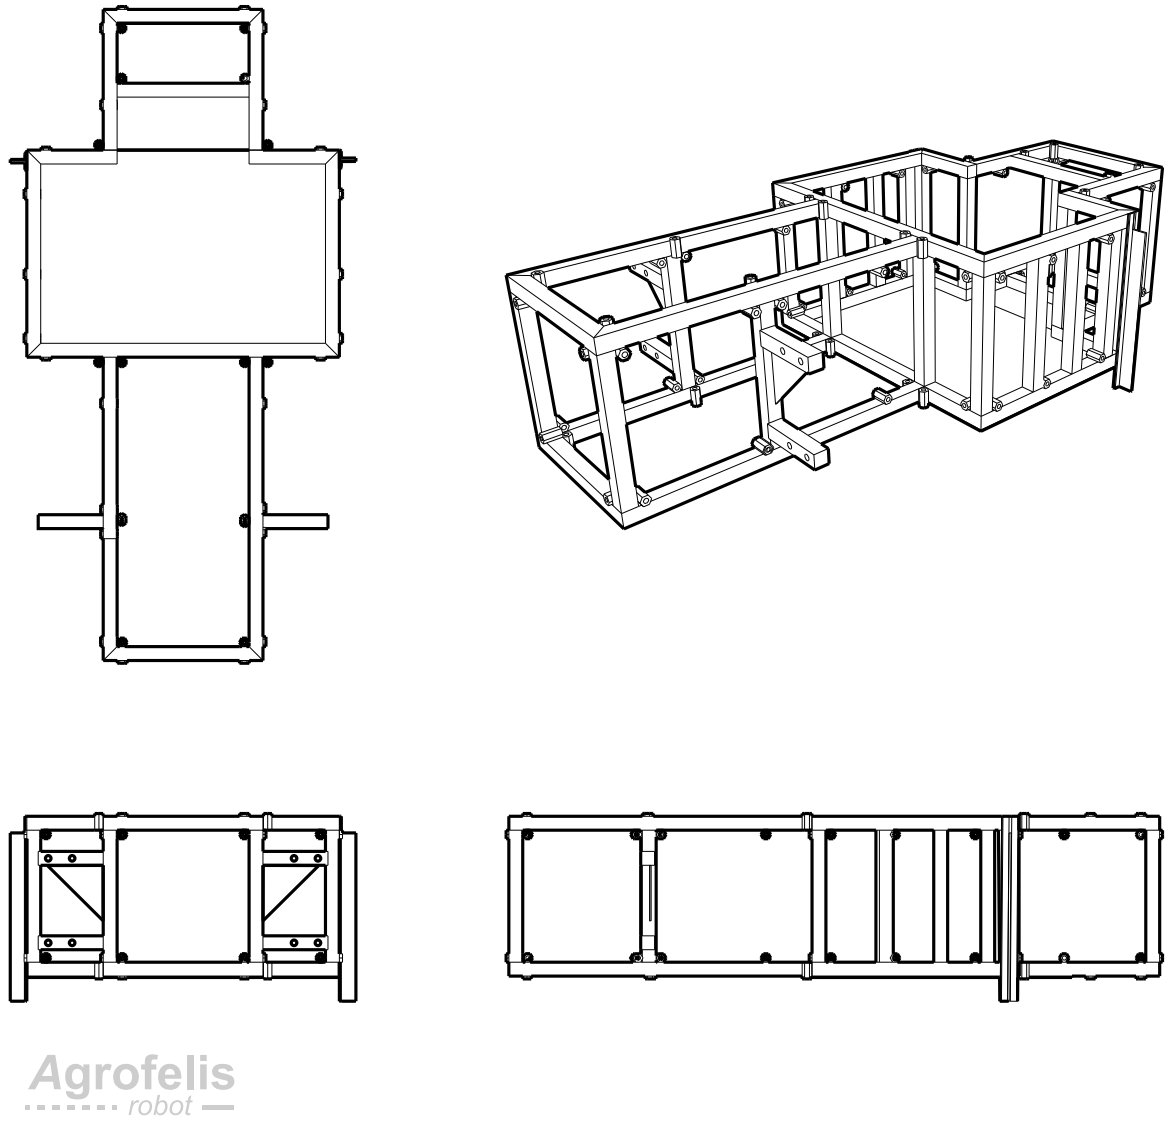
[picture p309: page 1]
