meltoner/agrofelis/components/vehicle-frame/_figures/pdf/vehicle-frame-02-top_view_measure.pdf

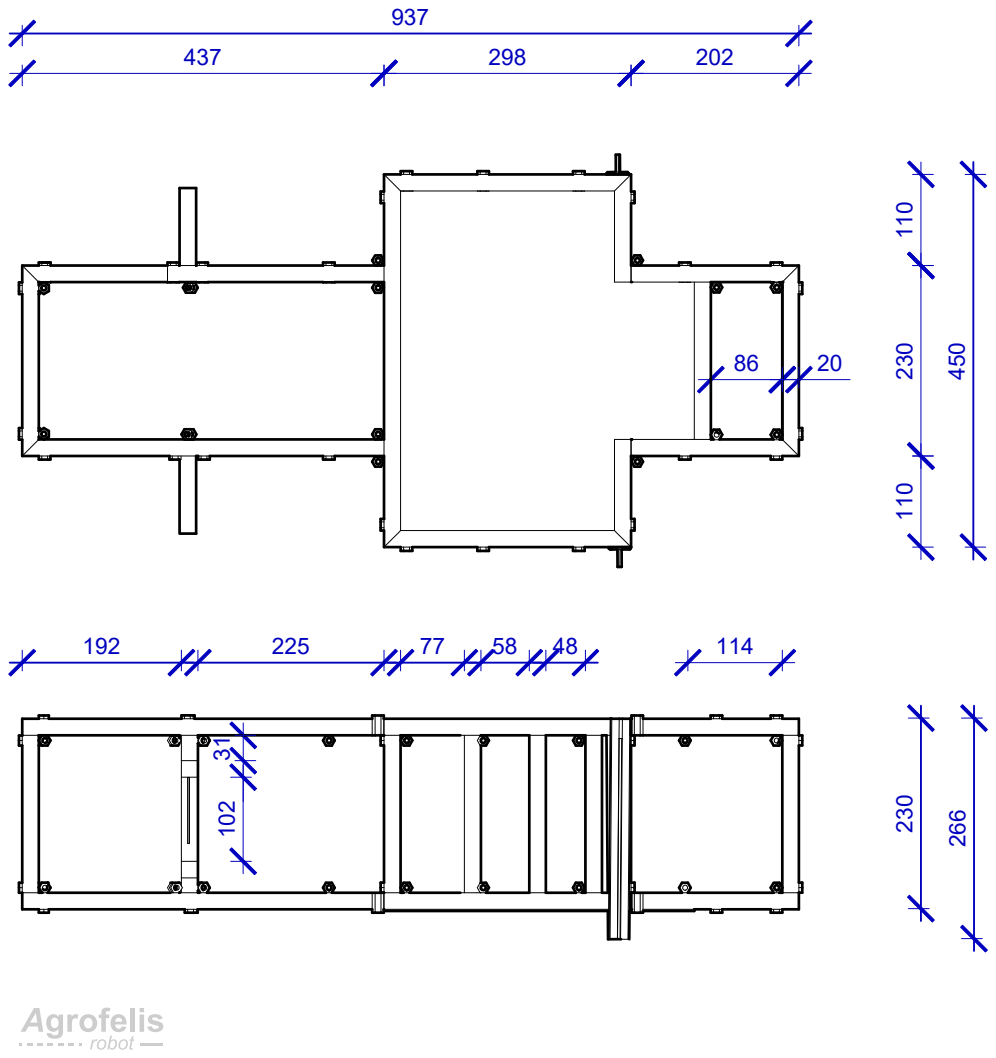
[picture p310: page 1]
