meltoner/agrofelis/components/vehicle-frame/_figures/pdf/vehicle-frame-03-exploded.pdf

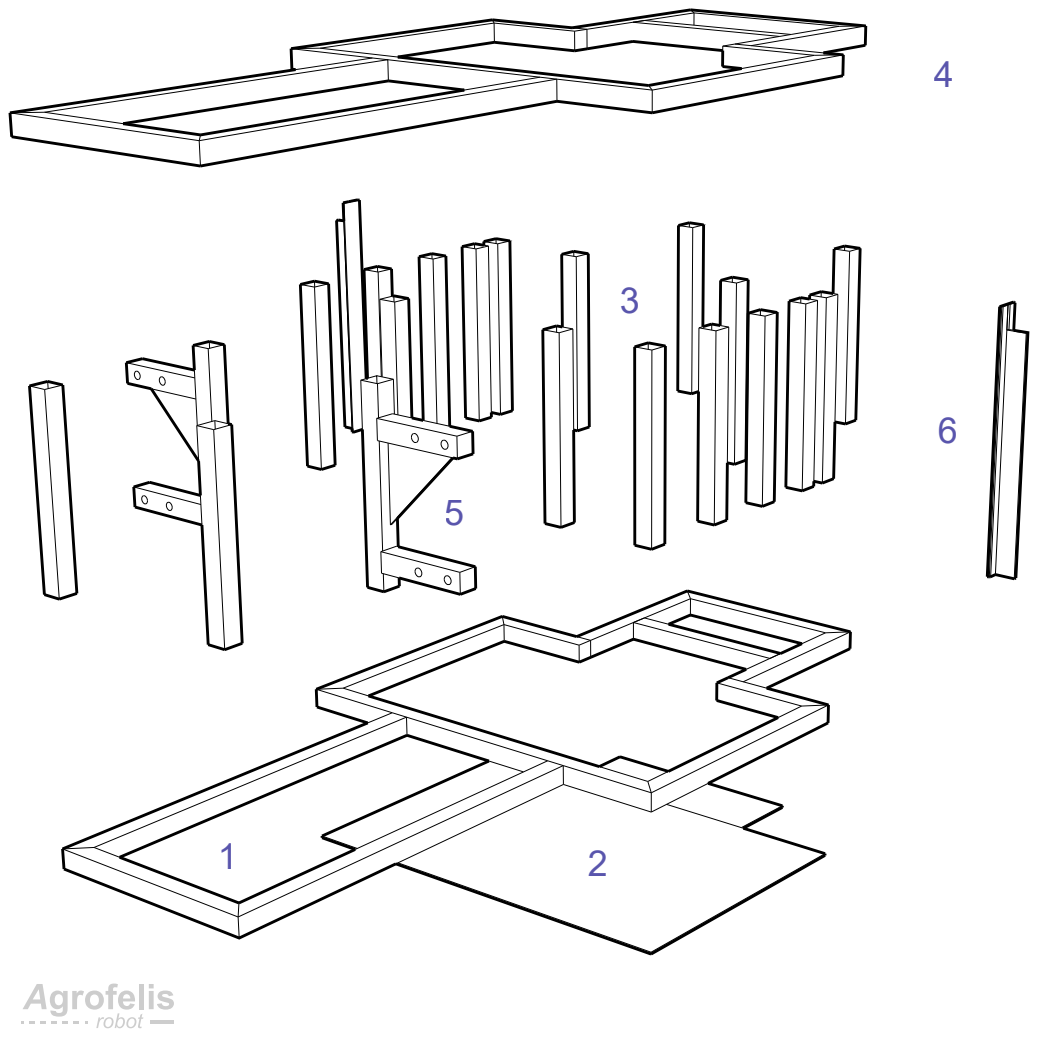
[picture p311: page 1]
