meltoner/agrofelis/components/vehicle-frame/_figures/pdf/vehicle-frame-04-step-01.pdf

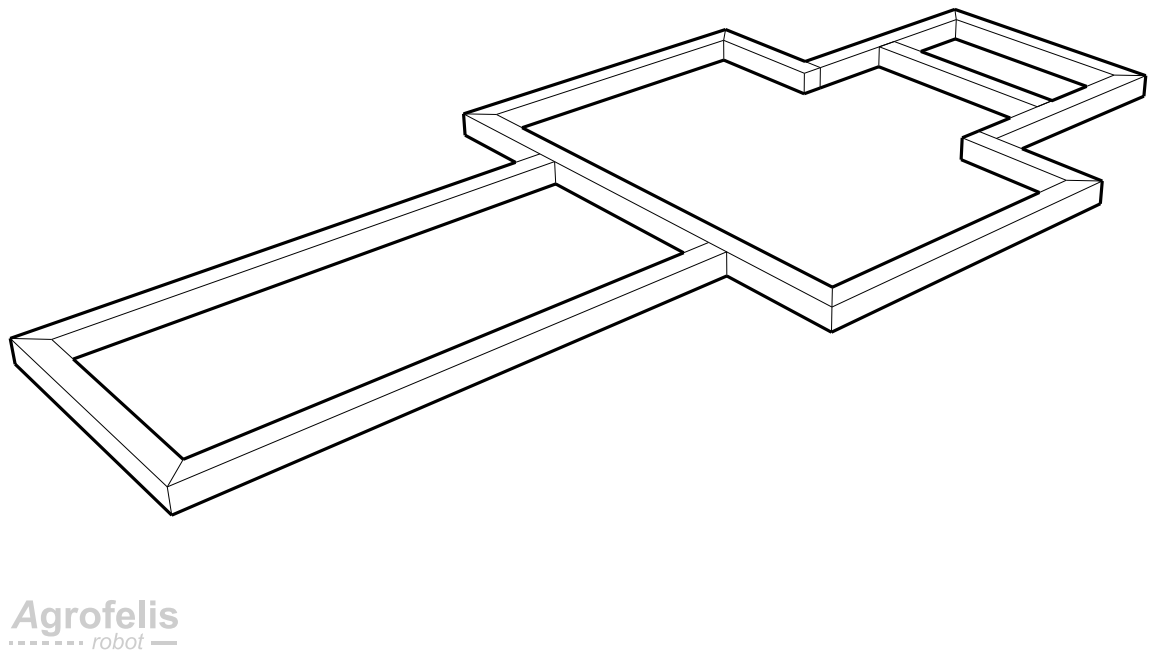
[picture p312: page 1]
