meltoner/agrofelis/components/vehicle-frame/_figures/pdf/vehicle-frame-04-step-02.pdf

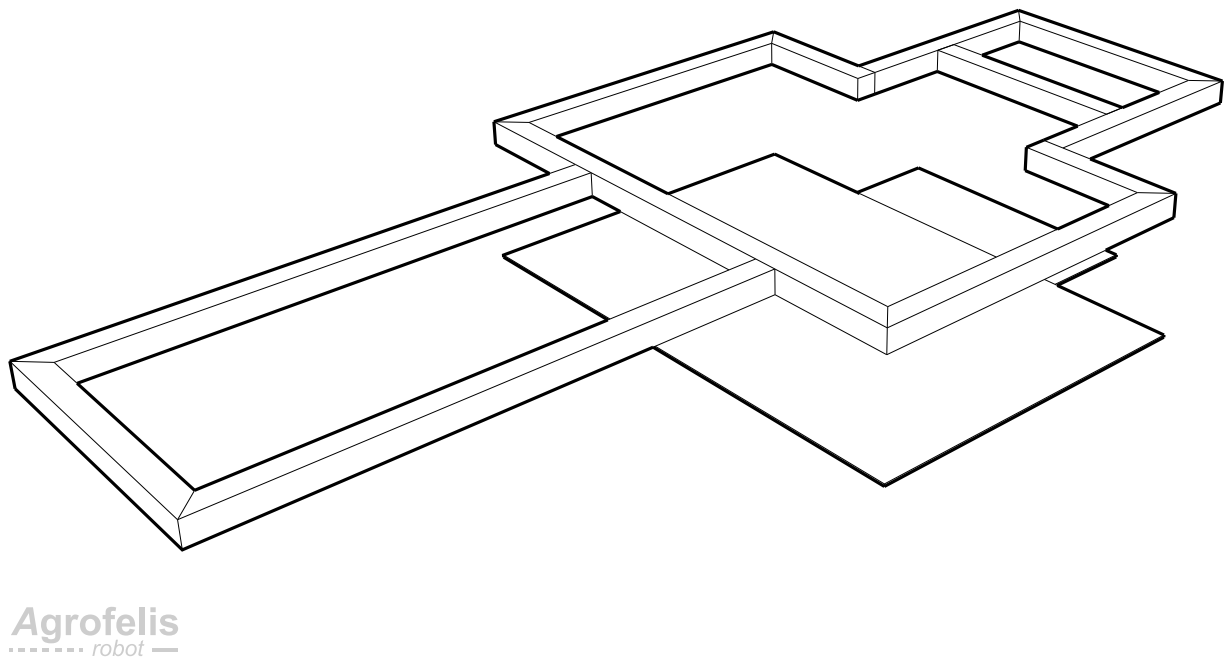
[picture p313: page 1]
