meltoner/agrofelis/components/vehicle-frame/_figures/pdf/vehicle-frame-04-step-03.pdf

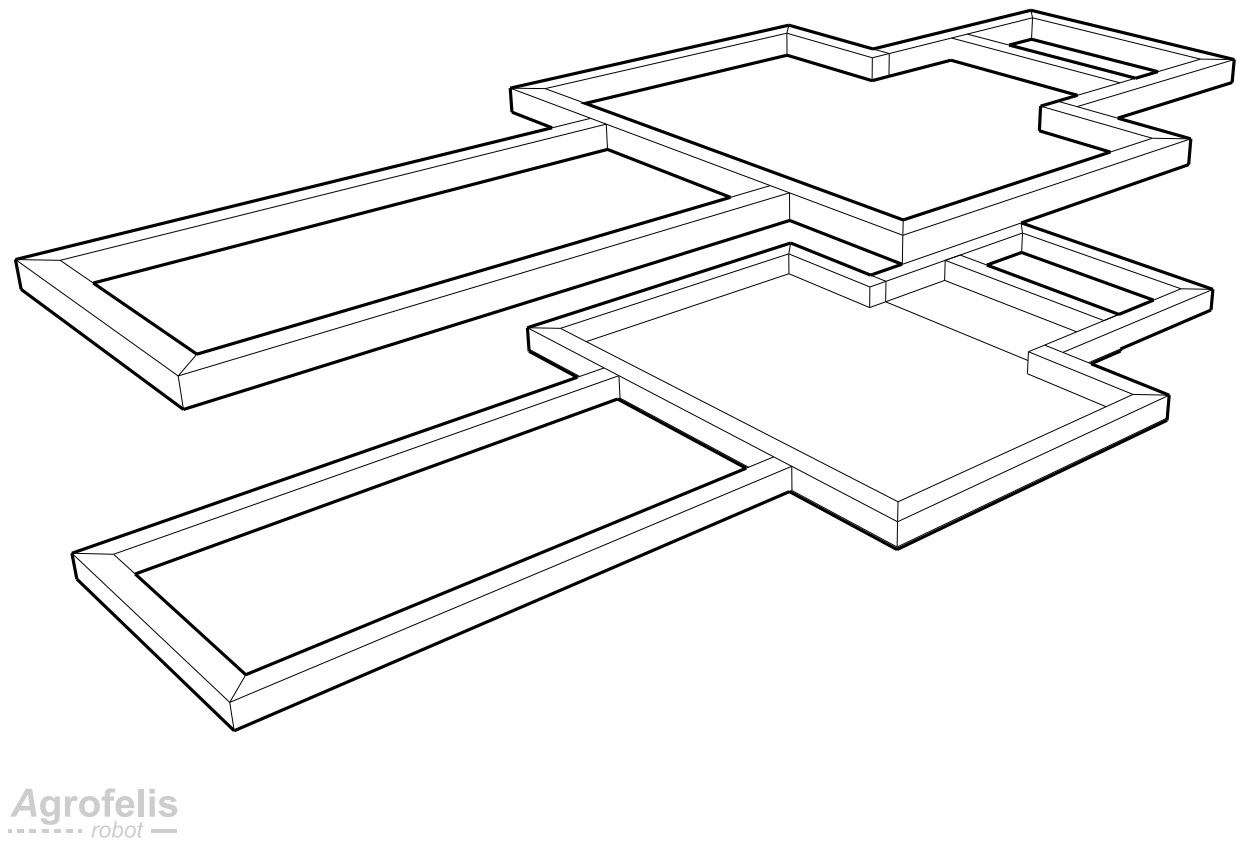
[picture p314: page 1]
