meltoner/agrofelis/(commit log)

2023-05-13 Add files via upload
    extending linear module with current sensor
2023-05-13 Add files via upload
    Simplify serial parser <a,b> a command, b value both ints
    Raise steering input to [-100 to 100] on data modeling / interpolate from [-42 to 42]
2023-05-30 documentation, references, electronics
    [LINEAR MODULE_4.3dm]
2023-06-20 Add files via upload
    web application reflecting the module's sensors and controlling the module's actuators via web sockets
2023-06-29 Add files via upload
    next iteration, using an external ADAC and a level shifter to match all necessary inputs, without falling short by 2 channels.
    [Adac.h, Context.h, Motor.cpp, Motor.h, Sensor.cpp, Sensor.h, SensorADACCurrent.cpp]
2023-07-12 First simultaneous control of both motor hubs
    Adaptation of components, and sub-modules decomposition.
    All connections have been verified. milestone commit
2023-07-12 Motors Hub driver structural components
    3d print and laser cut
    [motorsDriverFinsInner.stl, motorsDriverFinsOuter.stl]
2023-07-13 laser cut motors hub driver structure
2023-07-13 motors_hub_driver pcb source 3 components
2023-07-13 motors_hub_driver software source code
2023-07-14 motors hub driver pcb make files
2023-07-14 motors hub sub components readme files
    description and list of component
2023-07-14 motor hubs driver update of web application
2023-07-15 pcb motors driver structural elements readme
2023-07-19 documentation agrofelis motors hub driver
2023-07-22 Halls sensor implementation
2023-07-22 halls sensors implementation
2023-07-23 Motor synchronization, progressive throttling
    Progressive throttling
    Motor synchronized commands
    Motor end speed equalization
2023-07-23 web app features
    first motor controls both motors
    intermediate speed reflection
2023-08-03 lab improvements
    [MotorsAdaptationDrafting.xls]
2023-08-04 improvement on motors position reach
2023-08-06 code reviewing the steering module
2023-08-07 unificator initial import websocket server and spa
    Initial import of a node server integrating the serial port of the steering module, with jetson nano and exposing it using websockets.
    The unificator web server application implemented in node, will integrate all web, websocket and serial related modules of the system.
    The commit also includes a web application reflecting the steering (serial) module, internal state over the web enabling to alter its state.
2023-08-18 Motors hub separation to front and back
2023-08-22 already forked to front and back
    [MotorsAdaptationDrafting.xls]
2023-08-23 vehicle frame documentation start
2023-08-23 vehicle frame documentation
2023-08-24 Agrofelis wheels docmentation initiation
2023-08-24 wheels documentation in progress
    [36holes-16-inch-pattern.3dm]
2023-08-24 wheels documentation
2023-08-24 updates on wheel documentation
2023-08-24 Motors hub driver main document summary
2023-08-24 list of components for the frame in progress
2023-08-28 New Lidar module Front sensors
2023-08-29 Agrofelis wheels fork fabrication document
    initial commit
2023-08-30 Bill and material table update
2023-08-30 steering folder rename
    [LINEAR MODULE_4.3dm]
2023-08-30 images updates
    [potensiometerCoversL.stl, potensiometerCoversR.stl]
2023-08-30 vehicle steering documentation figures
2023-08-30 Steering module documentation
2023-08-30 bill and material table
2023-08-30 Steering bill and material and software
2023-08-30 steering documentation abstract improvement
2023-09-03 Frame covers documentation figures
2023-09-03 add hinge component
2023-09-05 power related documentation init
2023-09-05 power document updates
2023-09-06 wifi relay module
2023-09-06 addition of power system documentation in main document
2023-09-07 motos hub driver software section
2023-09-07 Lidar analysis shiny app initial commit
2023-09-07 new doc lidar
2023-09-08 lidar front sensors module document
2023-09-08 add lidar in main document
2023-09-08 add in bill n material
2023-09-08 New document 2 degrees rotating implement mount
2023-09-09 add NC and Gcode source and component list, suppliers info
    [laser-cut_stainless_gear_disk_motor_gear_order.dwg]
2023-09-10 add supporting figures in steering documentation
    ackerman, feedback sensor and labels
2023-09-10 add 3 figures in power documentation
2023-09-10 figures in final document
    [export_electronics_base.stl, usb_holder.stl]
2023-10-08 add lidar datasheet
